ishi-kai/Chipathon2023_ADC/README.md

# ADC of [Chipathon2023](https://github.com/sscs-ose/DC23-LTC2)'s Japan Team

## Submission files
Click [here](https://github.com/ishi-kai/Chipathon2023_ADC/edit/main/submit_version) plz!

## Specification
- Base Spec
    - 6bit SAR-ADC
- Clock(Resolution)
    - 8MHz
- Process
    - Global Fundories 180nm
- Size
    - x00um x x00um
- Work Voltage (VDD)
    - 3.3V

## Members
- [Maple0705](https://github.com/maple0705)
    - Skills
        - Semiconductor Engineer
    - XP
        - Analog Circuit Design
- [Gitefu](https://github.com/Gitefu)
    - Skills
        - FPGA(Digital) Cource's Graduate Student
    - XP
        - Twice Analog Circuit Design
- [Kinako](https://github.com/kinako71)
    - Skills
        - FPGA(Digital) Cource's Graduate Student
    - XP
        - First Time Analog Circuit Design
- [Tseng](https://github.com/tsengs0)
    - Skills
        - Electronic Circuit Designer
    - XP
        - First Time Analog Circuit Design
- [Noritsuna Imamura](https://github.com/noritsuna)
    - Skills
        - RF Circuit Engineer (PCB CAD)
    - XP
        - Third Times Analog Circuit Design

### Supporters
- Takeshi Kuboki
- [Mizuki Mori](https://github.com/3zki/)
- [Akira Tsuchiya](https://github.com/atuchiya/)

# Parts
## [All Parts Merge as SAR-ADC](https://github.com/ishi-kai/Chipathon2023_ADC/tree/main/maple0705/SAR_ADC)
- Designer
    - [Maple0705](https://github.com/maple0705)

## [SAR-Logic](https://github.com/ishi-kai/Chipathon2023_ADC/tree/main/maple0705/SAR_Logic)
- Designer
    - [Maple0705](https://github.com/maple0705)

## [Comparator](https://github.com/ishi-kai/Chipathon2023_ADC/tree/main/gitefu/comp_20240331)
- Designer
    - [Gitefu](https://github.com/Gitefu)

## [CDAC](https://github.com/ishi-kai/Chipathon2023_ADC/tree/main/cdac/mim_cap_array_8x8)
- Designer
    - [Tseng](https://github.com/tsengs0)

## [Latch](https://github.com/ishi-kai/Chipathon2023_ADC/tree/main/latch)
- Designer
    - [Kinako](https://github.com/kinako71)

## [Switch](https://github.com/ishi-kai/Chipathon2023_ADC/tree/main/transmission-gate)
- Designer
    - [Kinako](https://github.com/kinako71)

## [LDO](https://github.com/ishi-kai/Chipathon2023_ADC/tree/main/noritsuna/ldo)
- Designer
    - [Noritsuna Imamura](https://github.com/noritsuna)

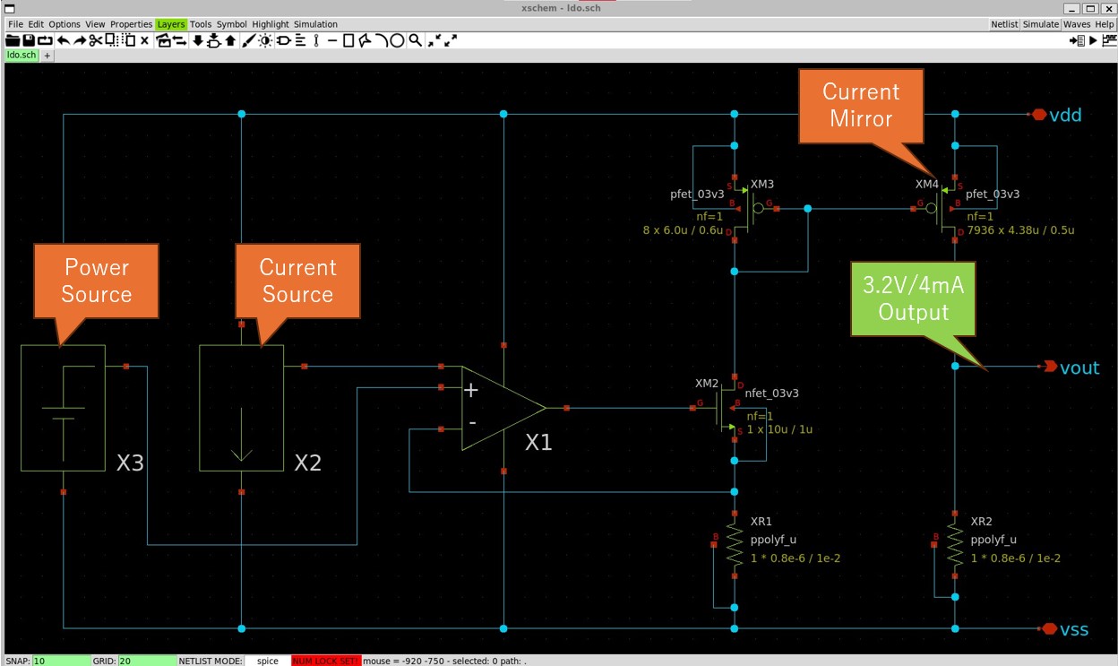
[picture p1: noritsuna/ldo/images/curcuit_ldo.jpg]
Curcuit
-   
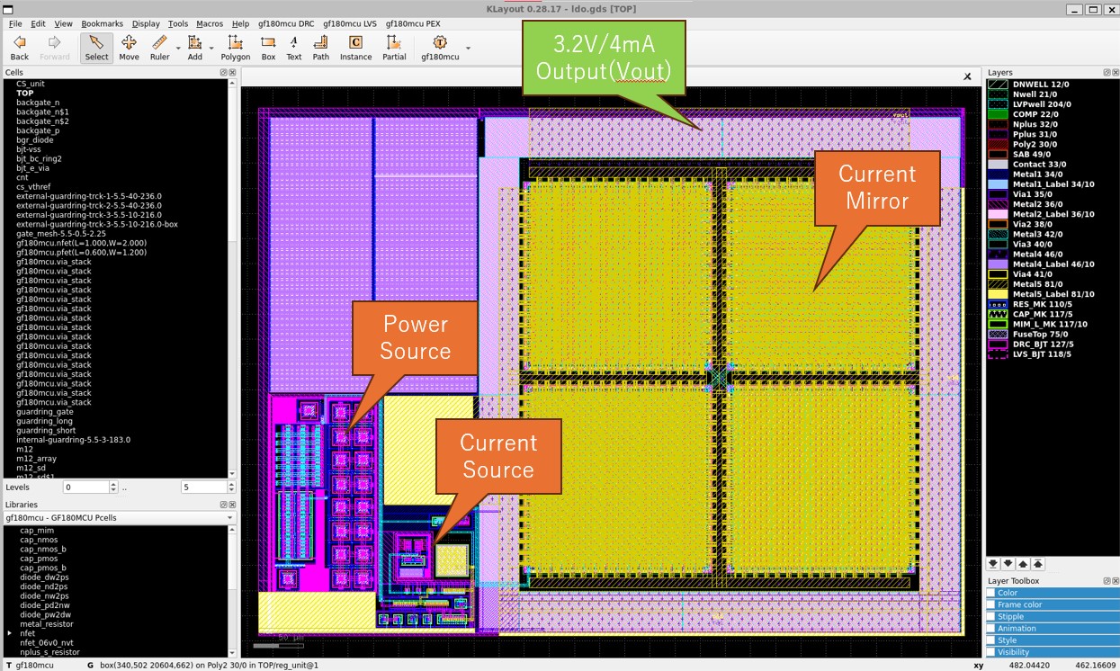
[picture p2: noritsuna/ldo/images/layout_ldo.jpg]
Layout
-   

### Specification
    - Size
        - 700um x 550um
    - In Voltage (VDD)
        - 3.3V
    - Out Voltage (Vout)
        - 3.2V
    - Out Ampere (Vout)
        - 4mA

# WSL Image
We provide a WSL image with an environment set up to run the circuit diagrams, simulations, layouts, DRC, and LVS mentioned above.  

- [Image for circuit diagrams, simulations, layouts, and LVS](https://www.noritsuna.jp/download/ubuntu2204_chipathon2023_gf180.tar.xz)
    - ID: ishi-kai
    - Pass: ishi-kai

## Installing WSL Images
`wsl --import-in-place ubuntu2204_chipathon2023_gf180 .\ubuntu2204_chipathon2023_gf180\ext4.vhdx`

The above command will be recognised. To execute it, please use the included "ubuntu2204_chipathon2023_gf180.lnk".  

## Deleting WSL Images
Please note that image files will also be deleted.  

`wsl --unregister ubuntu2204_chipathon2023_gf180`

# License
