ishi-kai/Chipathon2023_ADC/submit_version/readme.md

# Submission files
- [GDSII for tapeout](https://github.com/ishi-kai/Chipathon2023_ADC/blob/main/submit_version/klayout/SAR_TOP.gds)
- [Schematic file for LVS](https://github.com/ishi-kai/Chipathon2023_ADC/blob/main/submit_version/xschem/sar_adc_lvs.sch)

  - Layout and the contributor of each subblock/subsystem
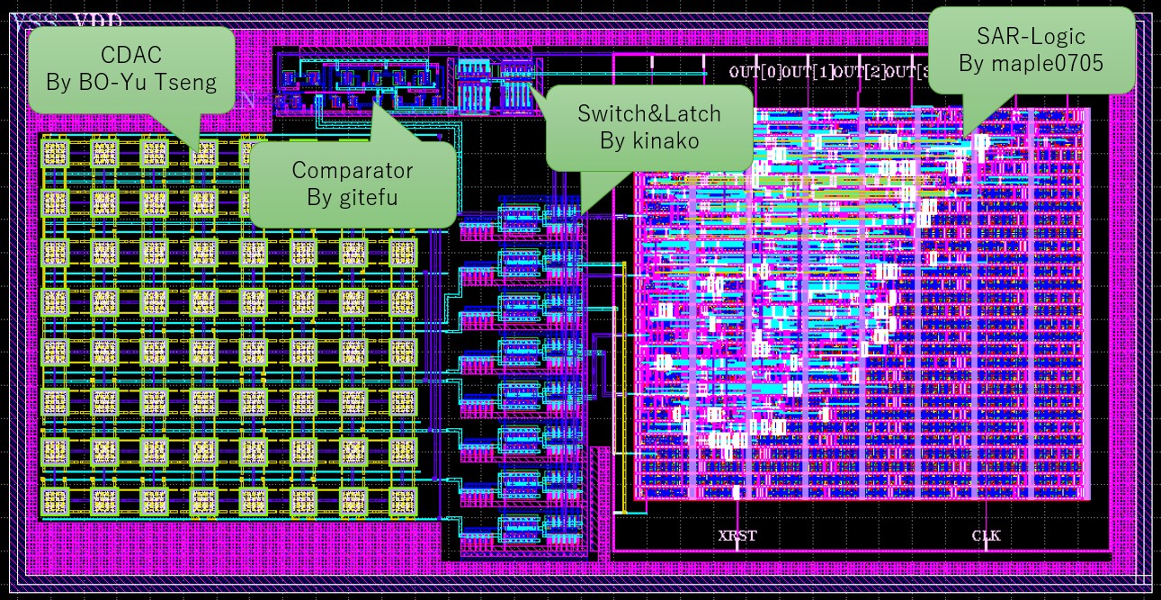
[picture p3: submit_version/images/layout.jpg]
Parts Layout
  

  - Block Diagrams
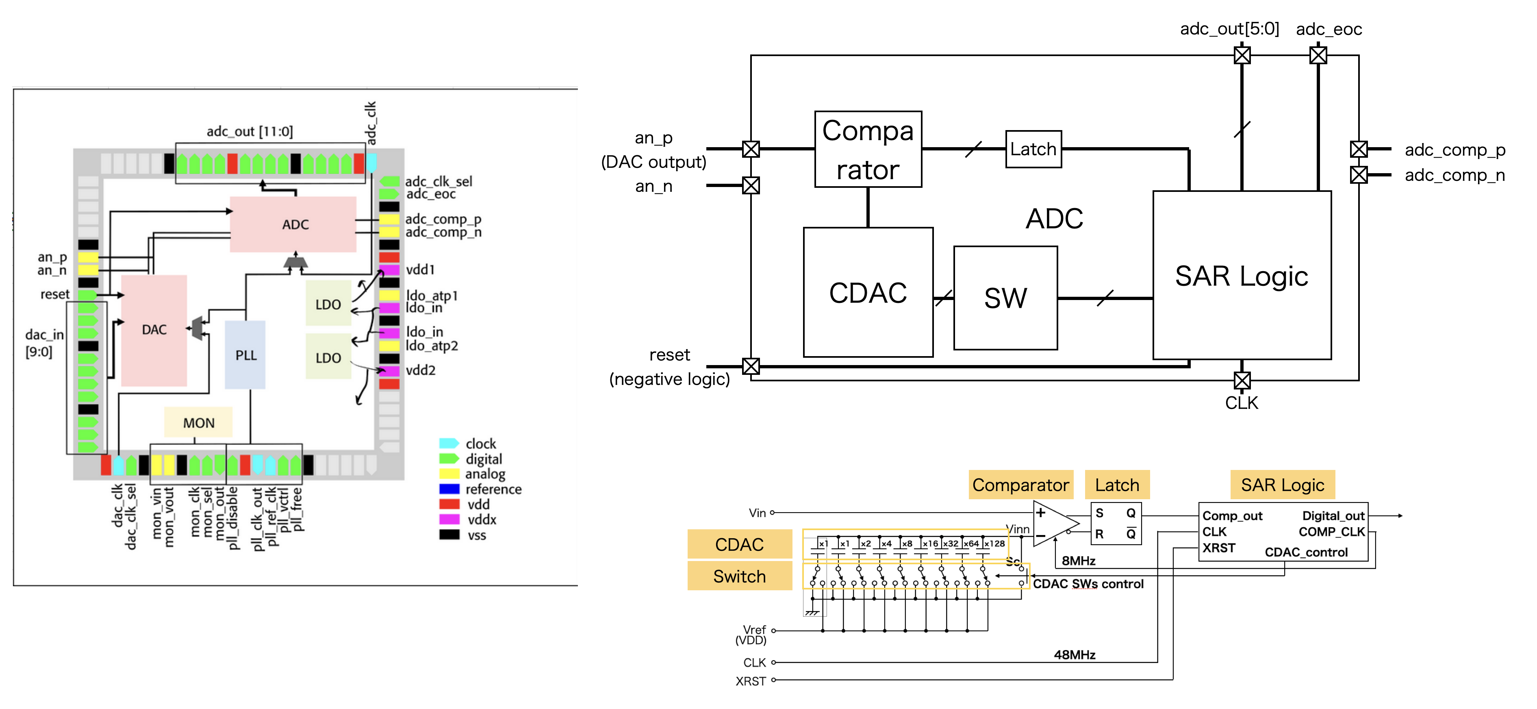
[picture p4: submit_version/images/PnR.png]
Block Figs
  

  - Interface and Area
  Pins Layout  

---

# Descriptoin of each design file
| File | Purpose/Function | Remark |
| --- | --- | --- |
|SW_CDAC.sch|switch component for each CDAC bit which is based on the https://github.com/ishi-kai/Chipathon2023_ADC/blob/main/transmission-gate/sw.sch|The only difference from the base sw.sch is the NMOS connected to the Vout port|
|SW_CDAC.sym|symbol file made from the Sw_CDAC.sch||
|user_proj_sarlogic.sym|symbol file used for the simulation of [user_proj_sarlogic_pex_extracted.spice](https://github.com/ishi-kai/Chipathon2023_ADC/blob/main/maple0705/SAR_Logic/klayout/user_proj_sarlogic_pex_extracted.spice)||
|user_proj_sarlogic.sch|blackbox module for making the symbol file of user_proj_sarlogic||
|tran_sar_logic.sch|schematic file for the unit-level verification of SAR logic||
|tran_sar_adc.sch|Testbench for the integration of the overall SAR A/D converter as shown in the figure below||

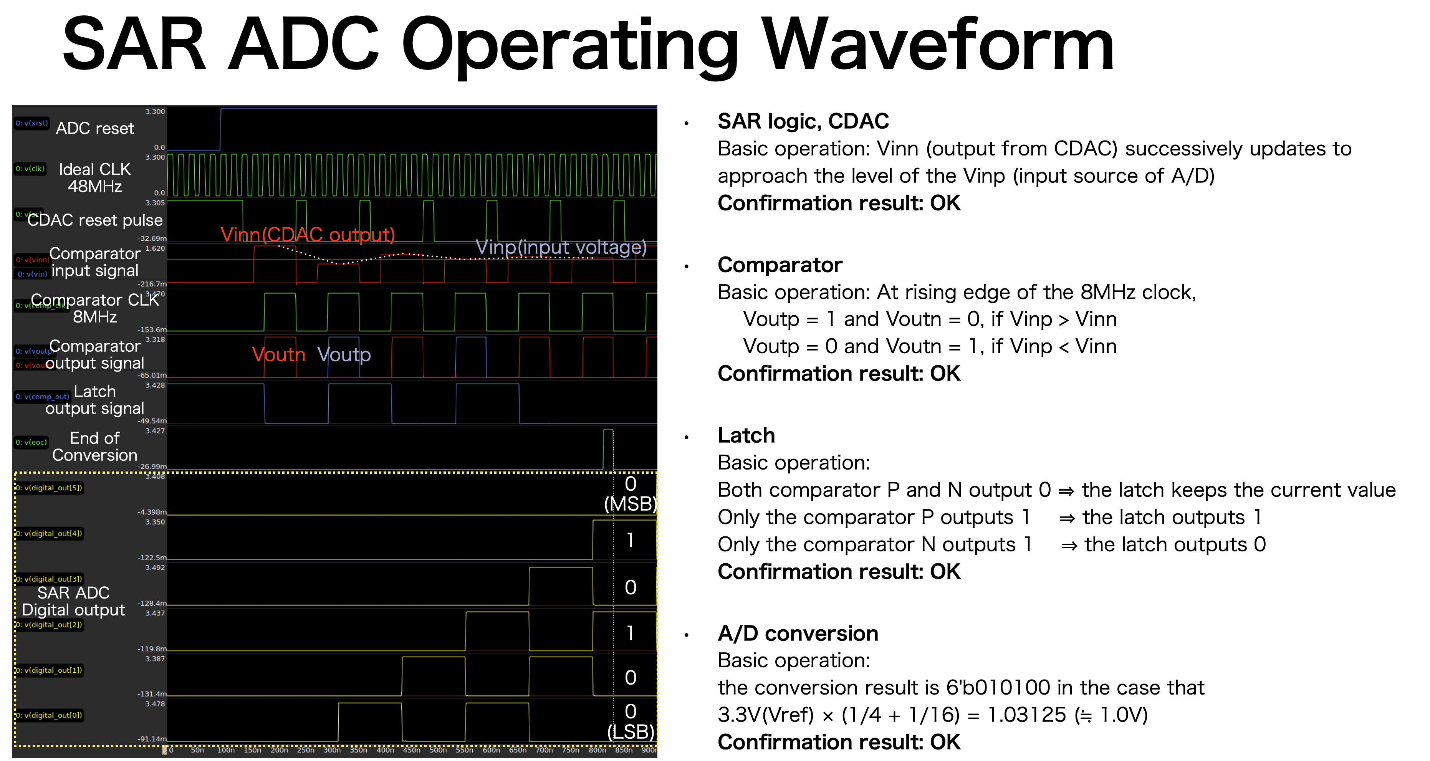
[picture p5: submit_version/images/sar_adc_operating_waveform.png]
SAR-ADC Spec
 

---

## Miscellaneous:  
  - Top-level schematic of the A/D converter integrating all subblocks 
    - https://github.com/ishi-kai/Chipathon2023_ADC/tree/main/maple0705/SAR_Logic/caravel/openlane
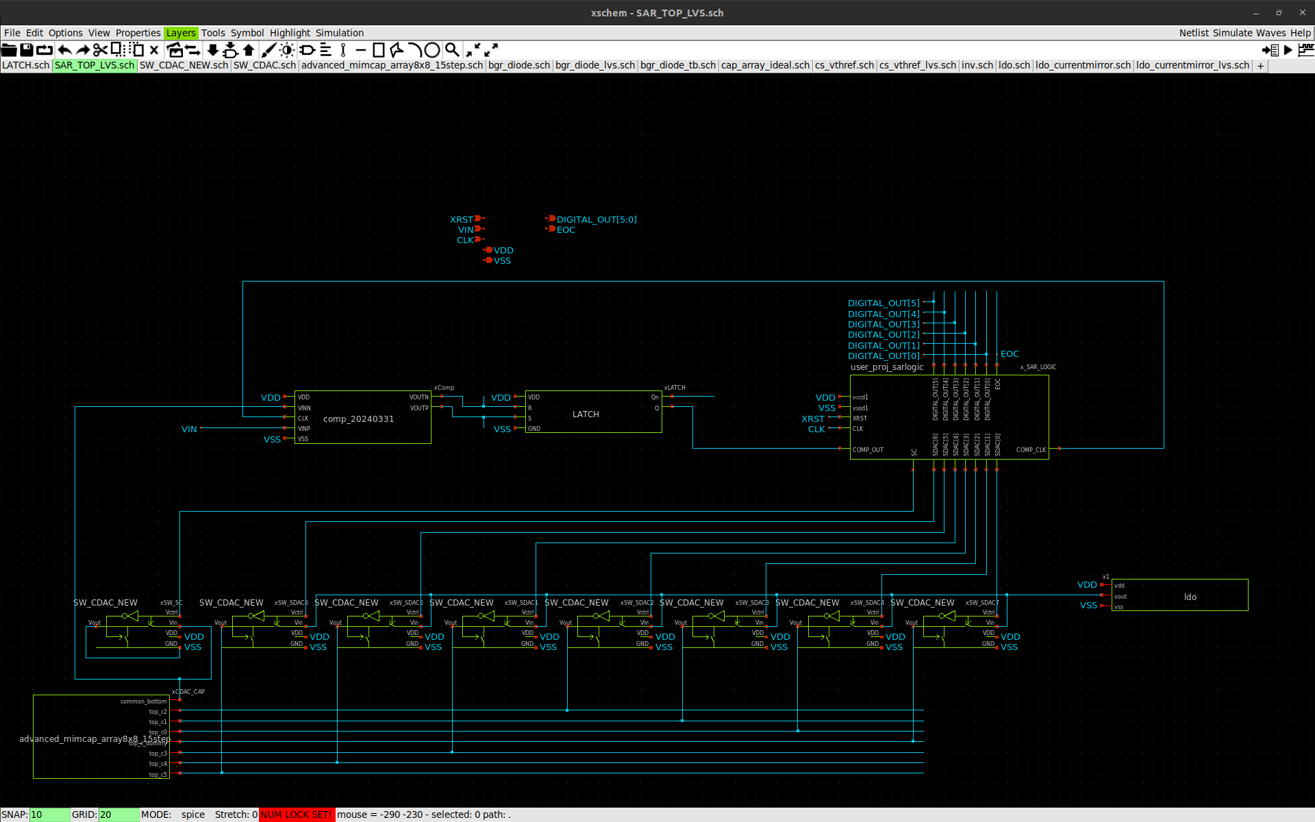
[picture p6: submit_version/images/SAR_TOP_LVS.png]
SAR_TOP_LVS
    -   
  - Design of the MIM capacitor array  
    - https://github.com/ishi-kai/Chipathon2023_ADC/tree/cdac_tseng/cdac/mim_cap_array_8x8
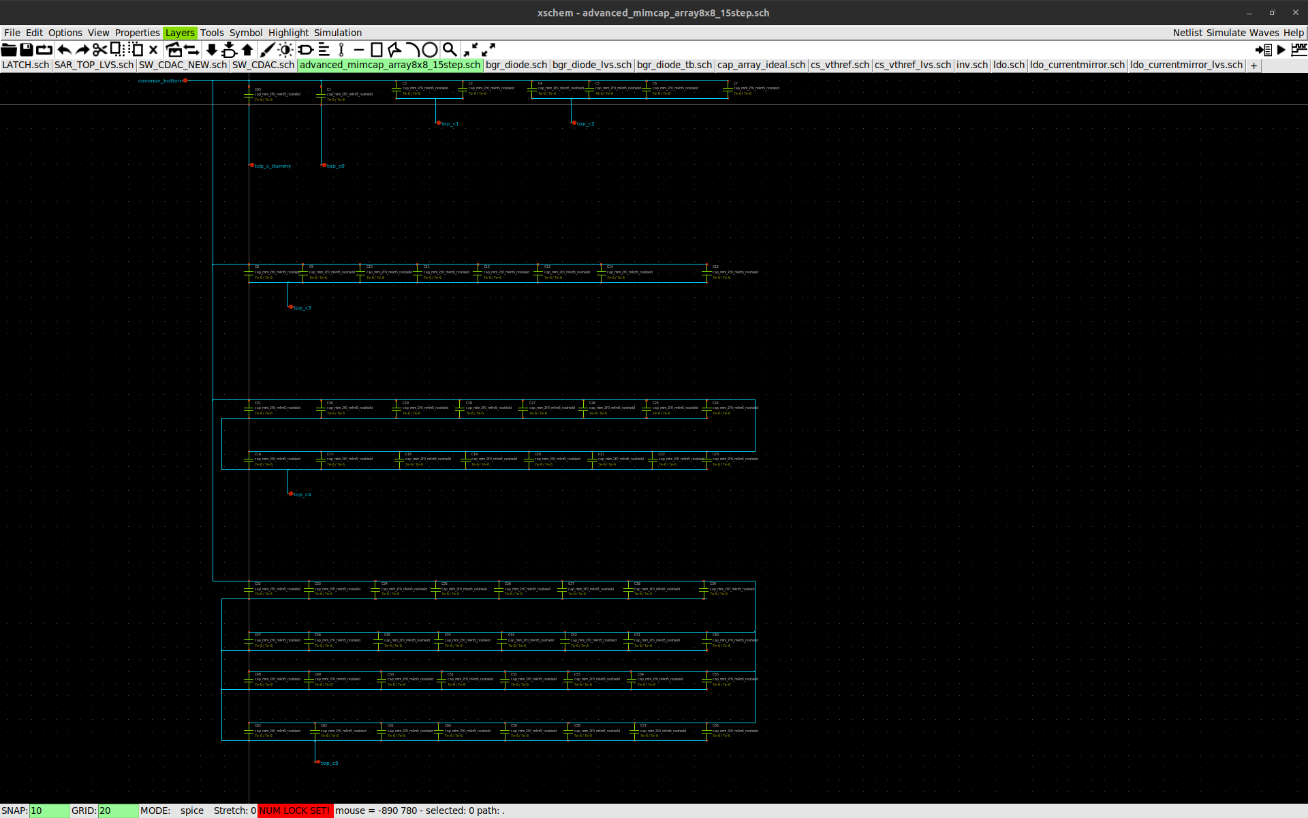
[picture p7: submit_version/images/advanced_mimcap_array8x8_15step.png]
CDAC
    -   
  - Design of the latch components
    - https://github.com/ishi-kai/Chipathon2023_ADC/tree/main/latch  
    - https://github.com/ishi-kai/Chipathon2023_ADC/tree/main/inverter
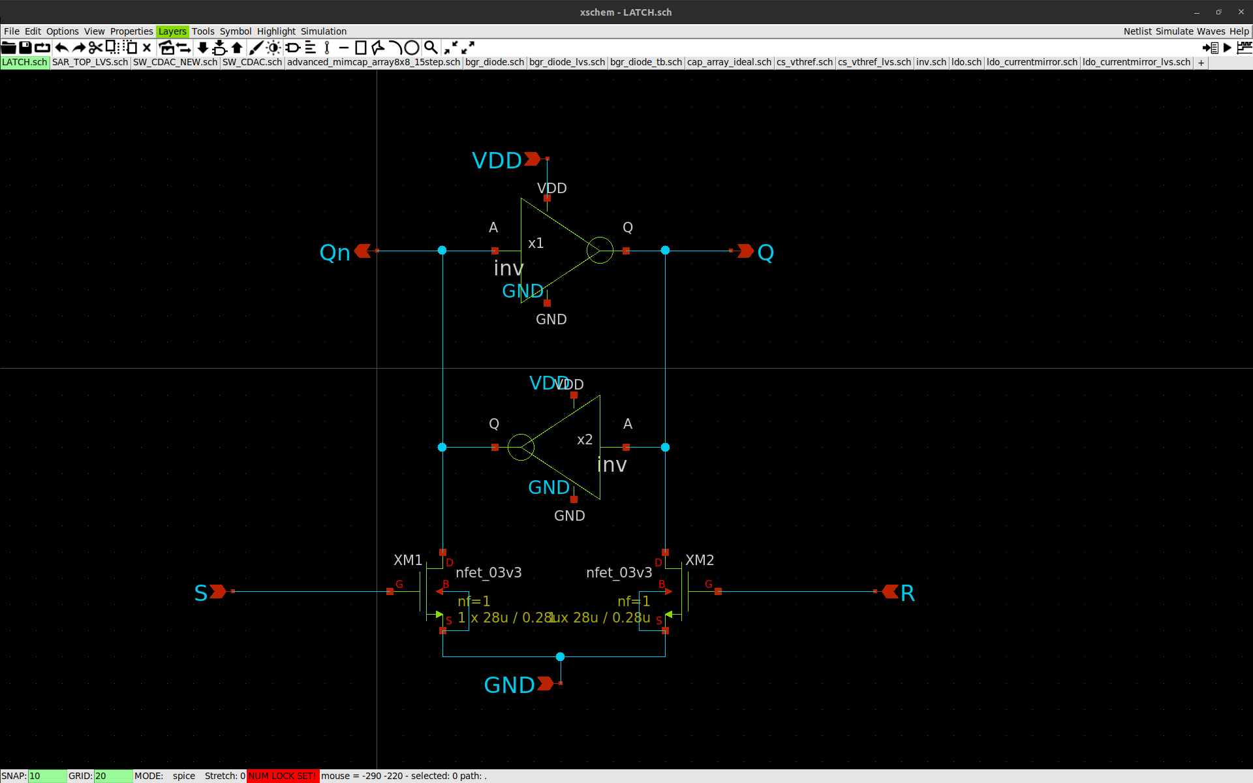
[picture p8: submit_version/images/LATCH.png]
LATCH
    -   
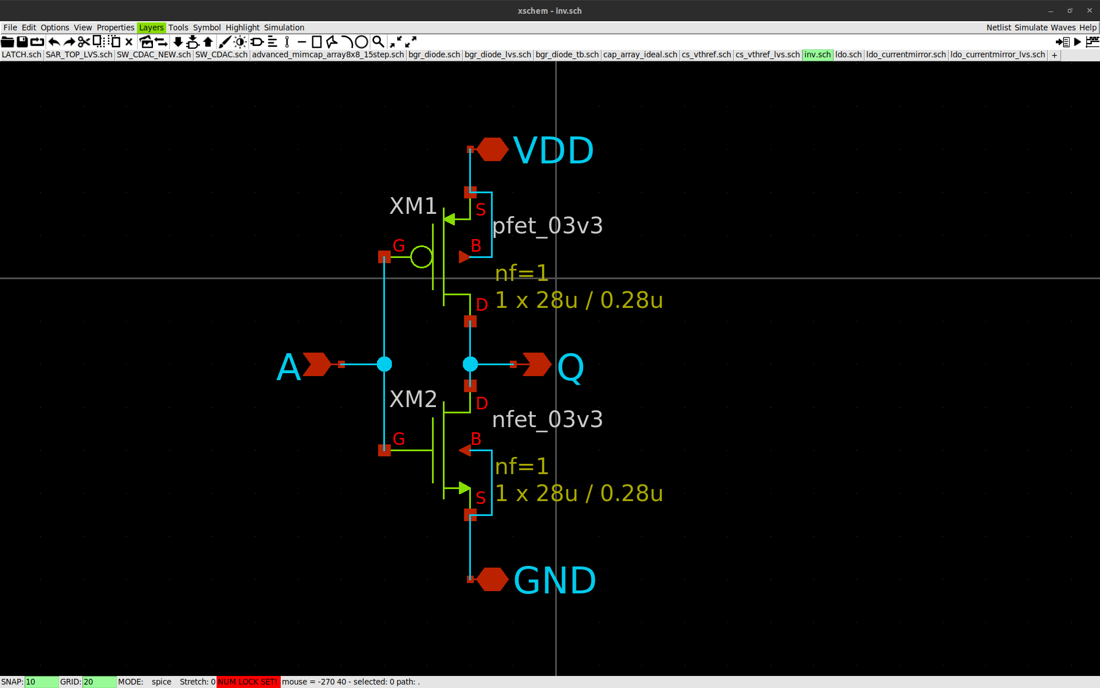
[picture p9: submit_version/images/Inv.png]
Inv
    -   
  - Design of the comparator
    - https://github.com/ishi-kai/Chipathon2023_ADC/tree/main/gitefu/comp_20240331
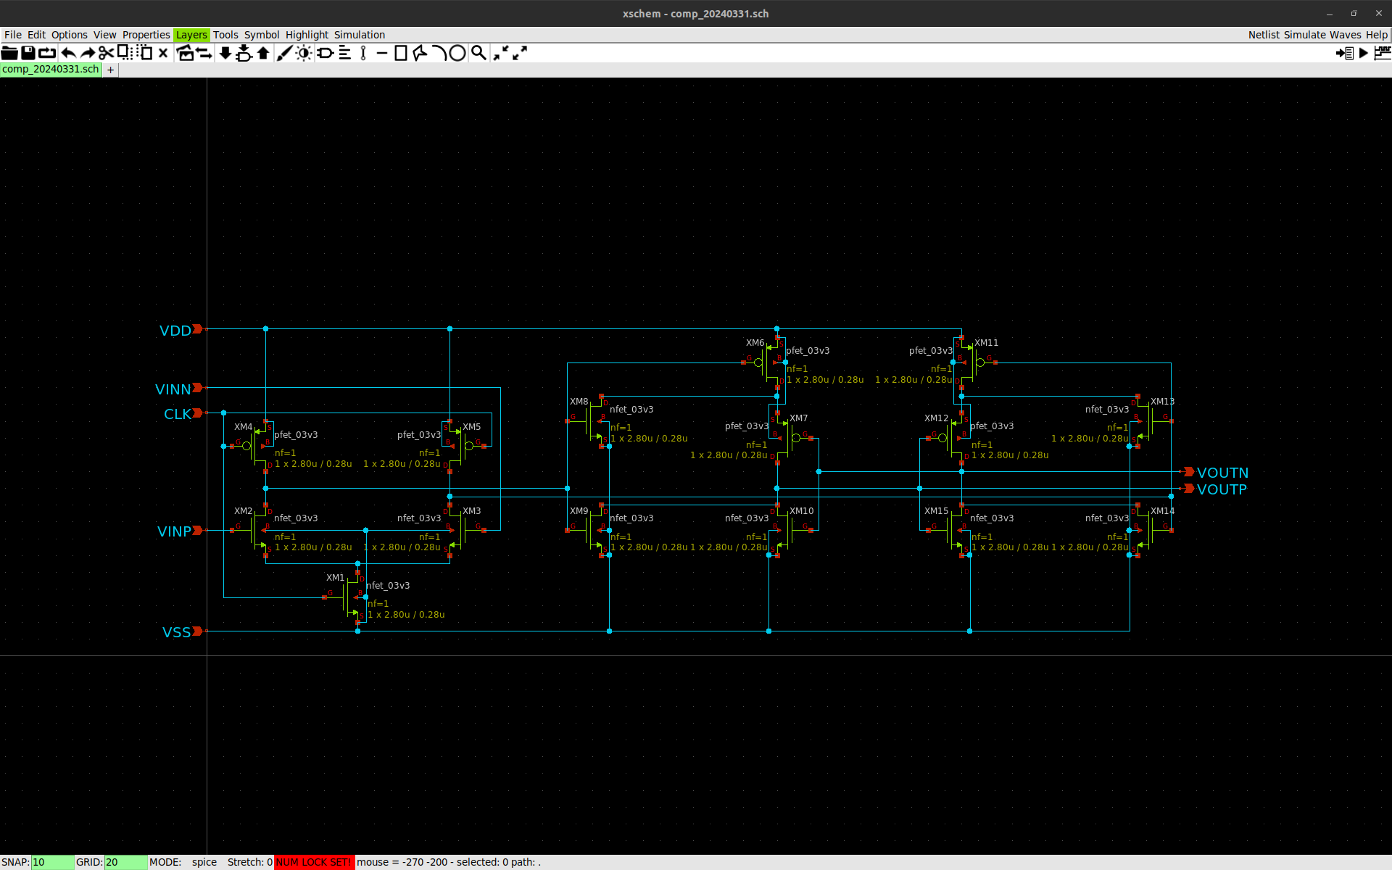
[picture p10: submit_version/images/comp_20240331.png]
Comparator
    -   
  - Unused/Tentative design material
      - LDO: https://github.com/ishi-kai/Chipathon2023_ADC/tree/main/noritsuna/ldo
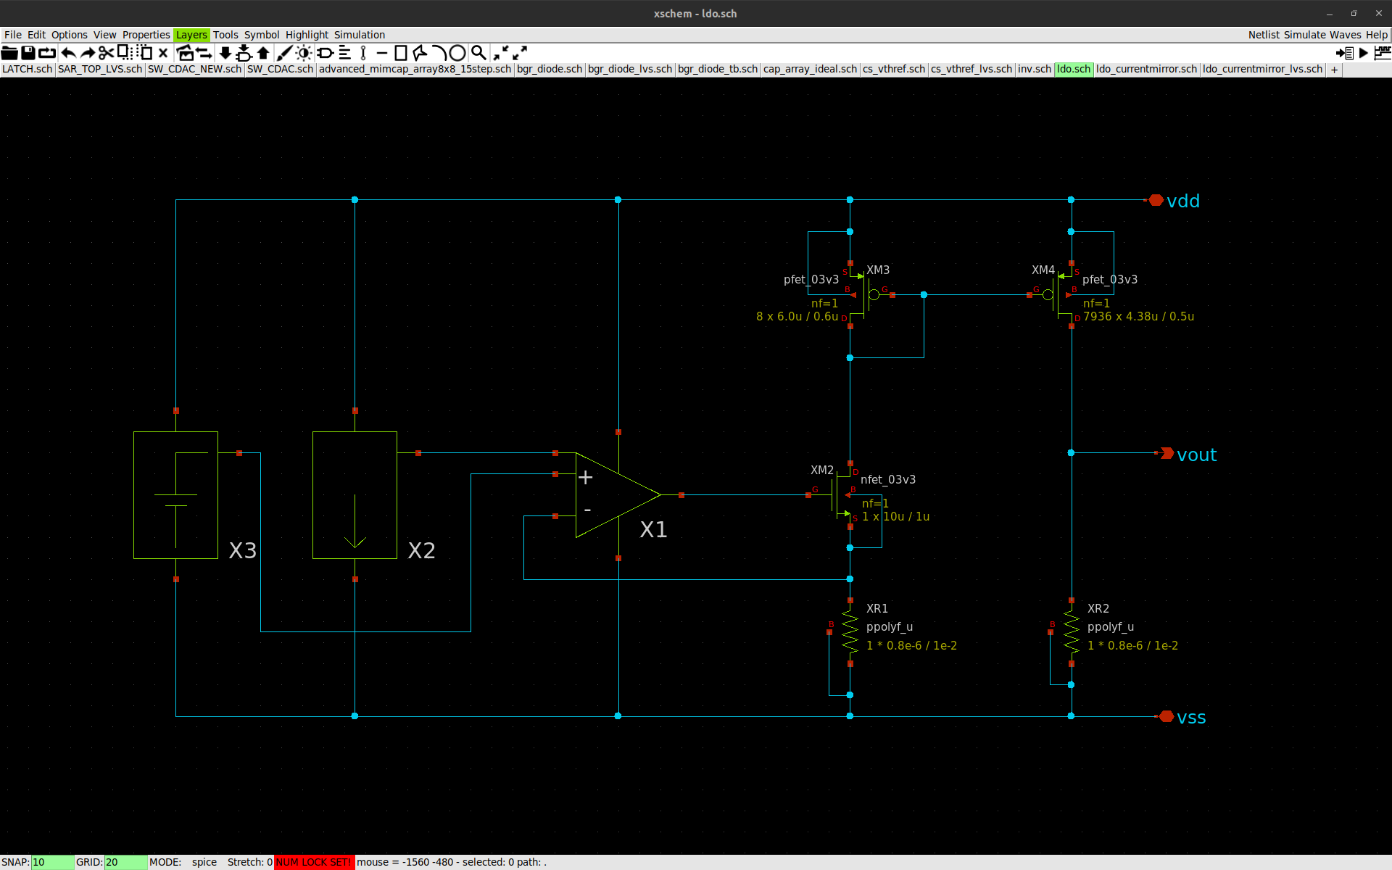
[picture p11: submit_version/images/ldo.png]
LDO
      -
