ishi-kai/Chipathon2023_ADC/maple0705/readme.md

- SAR ADC  
  SAR ADC 統合検証テストベンチ
- SAR Logic  
  SARロジック RTLや論理合成設定ファイル、合成後GDS
