ishi-kai/Chipathon2023_ADC/review/0407/noritsuna_sampleADC_Analyze.pptx

## 他のADCサンプル解析

Noritsuna Imamura
noritsuna@ishi-kai.org

## サンプル：MPW7より 差動入力10bit SAR-DAC https://github.com/christoph-weiser/mpw7

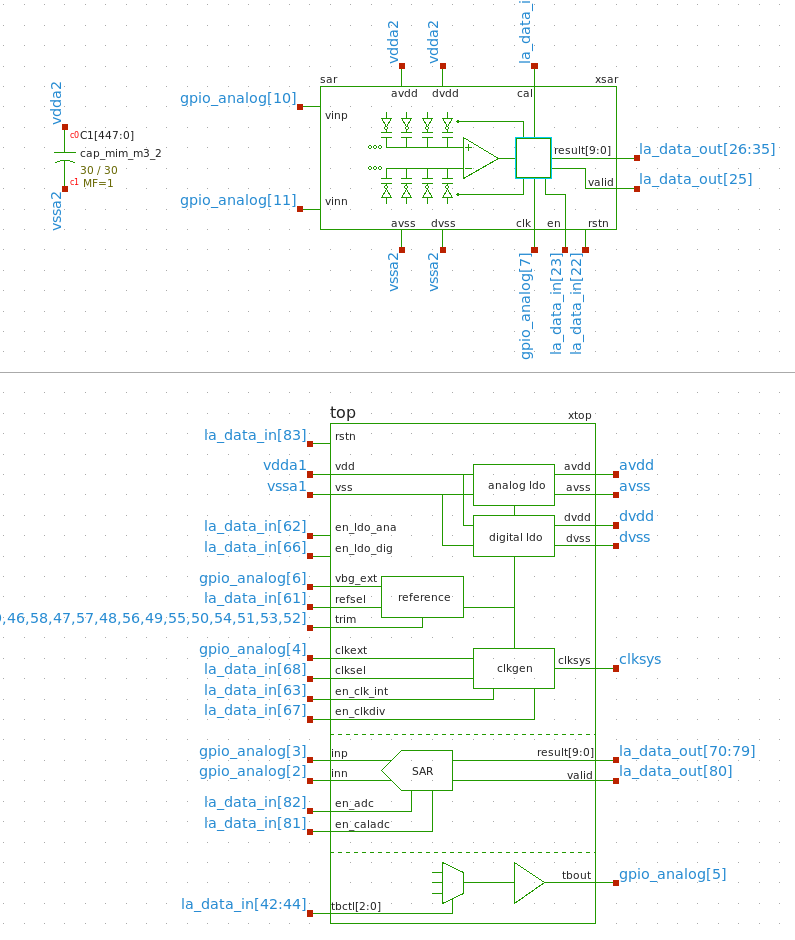
[picture p16: figure]

## 全体 レイアウトの サンプル

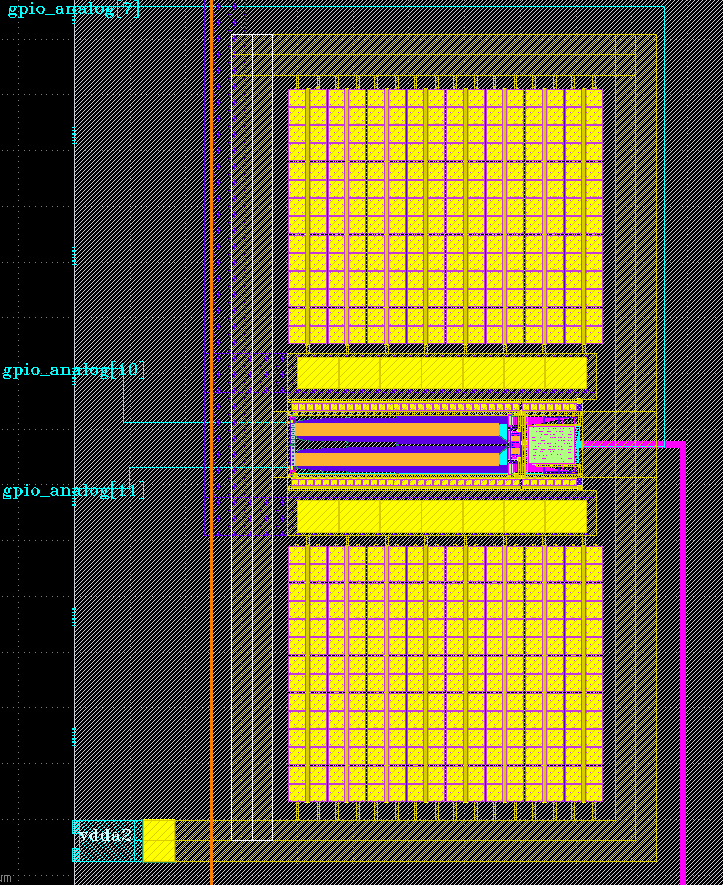
[picture p17: figure]

## 黄色の謎

MIMコンデンサのようだが、ここに電荷を貯めて、高速に電荷をCDAC部分に送れるようにしている？

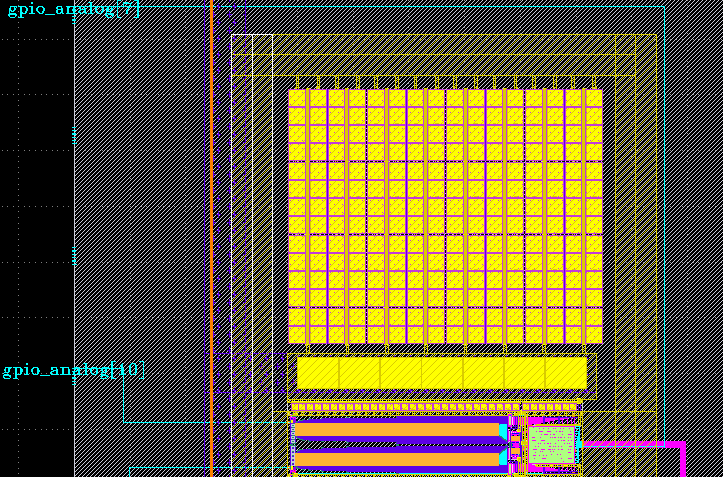
[picture p18: figure]

## CDACの前に何か回路がある

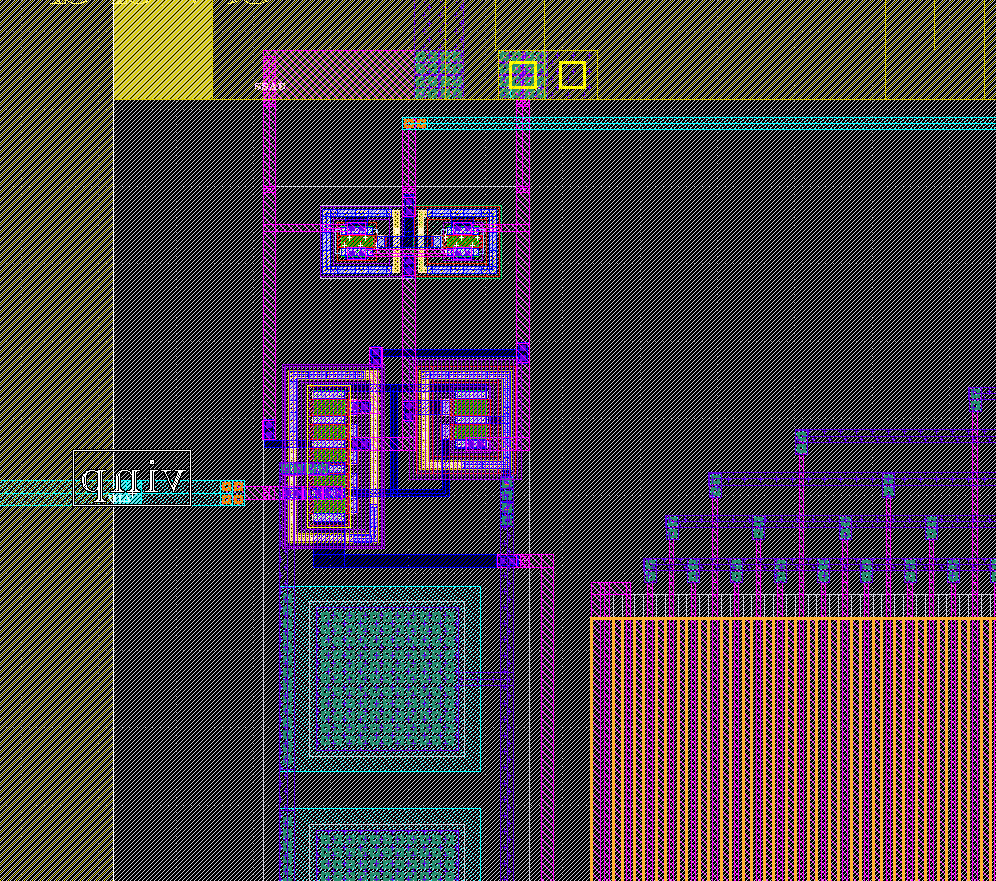
[picture p19: figure]

## 回路的にはBIAS用のAMP？

これは必要か？

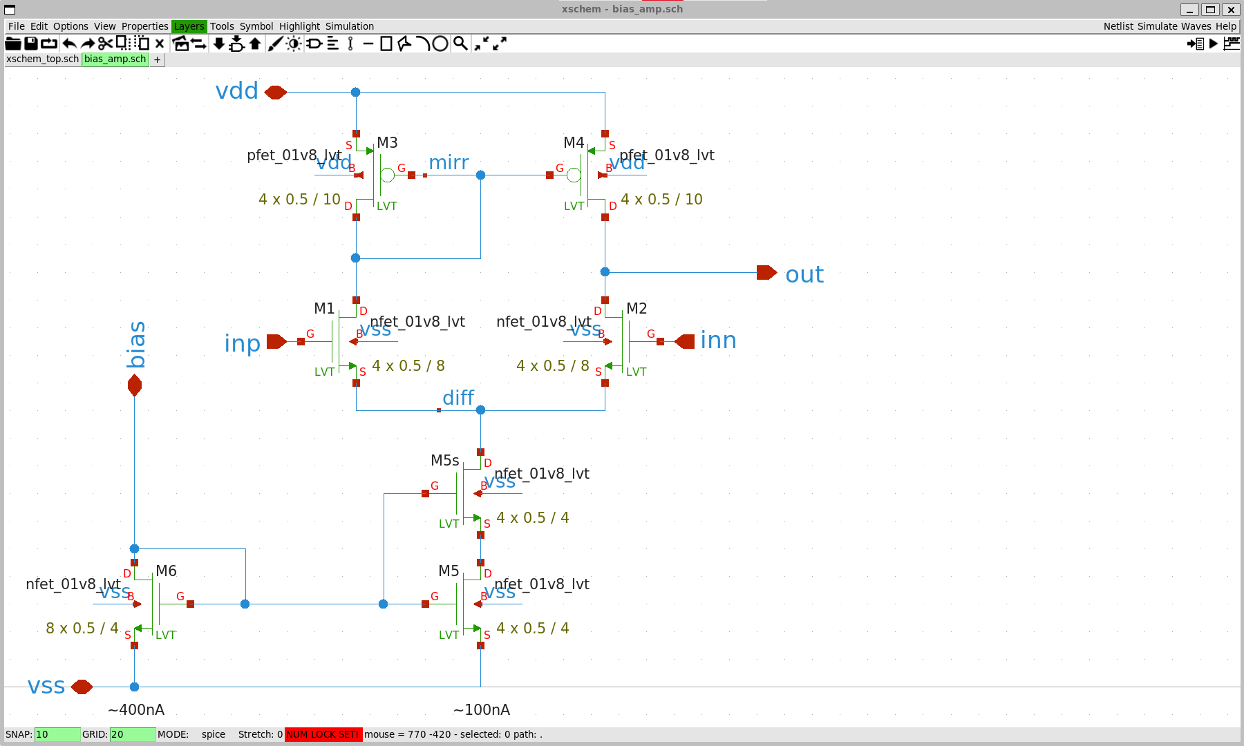
[picture p20: figure]

## コンパレータ

CDACスイッチ

ロジック

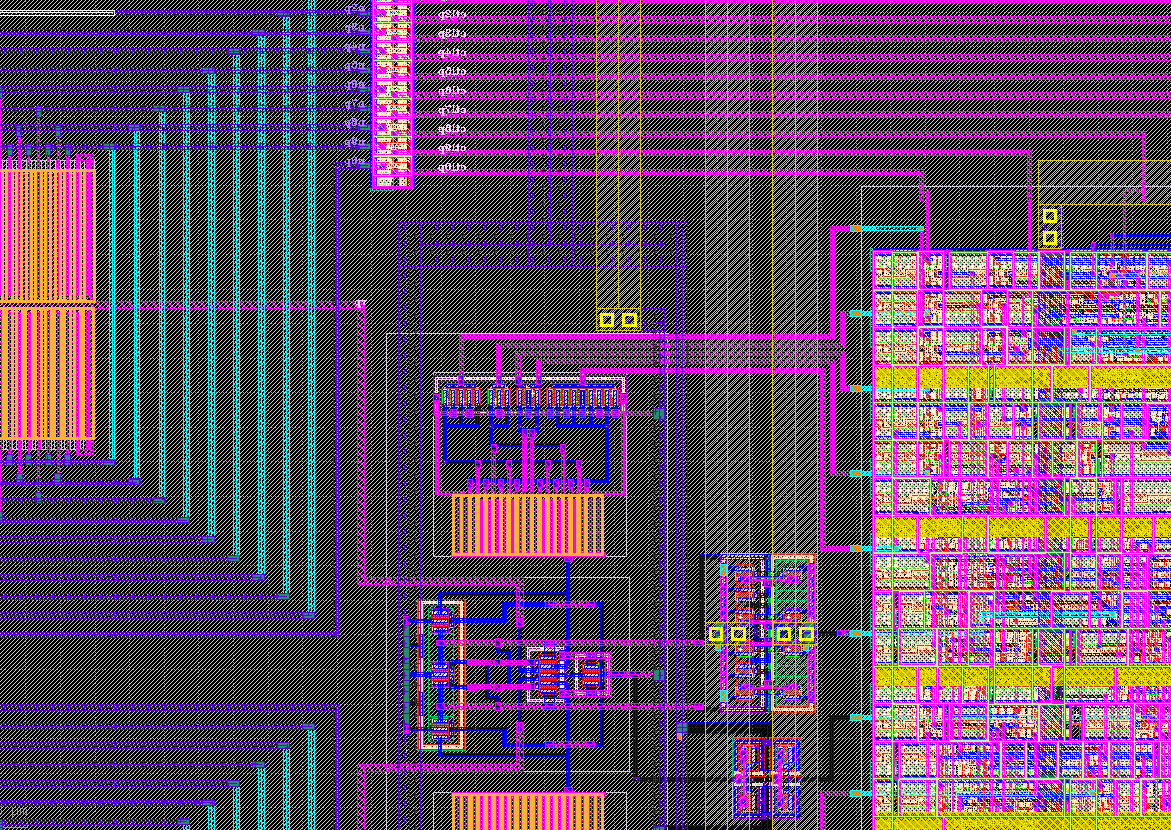
[picture p21: figure]

trim

コンパレータ

ラッチアップ

クロック
（バッファー）

## trim

何に使うの？

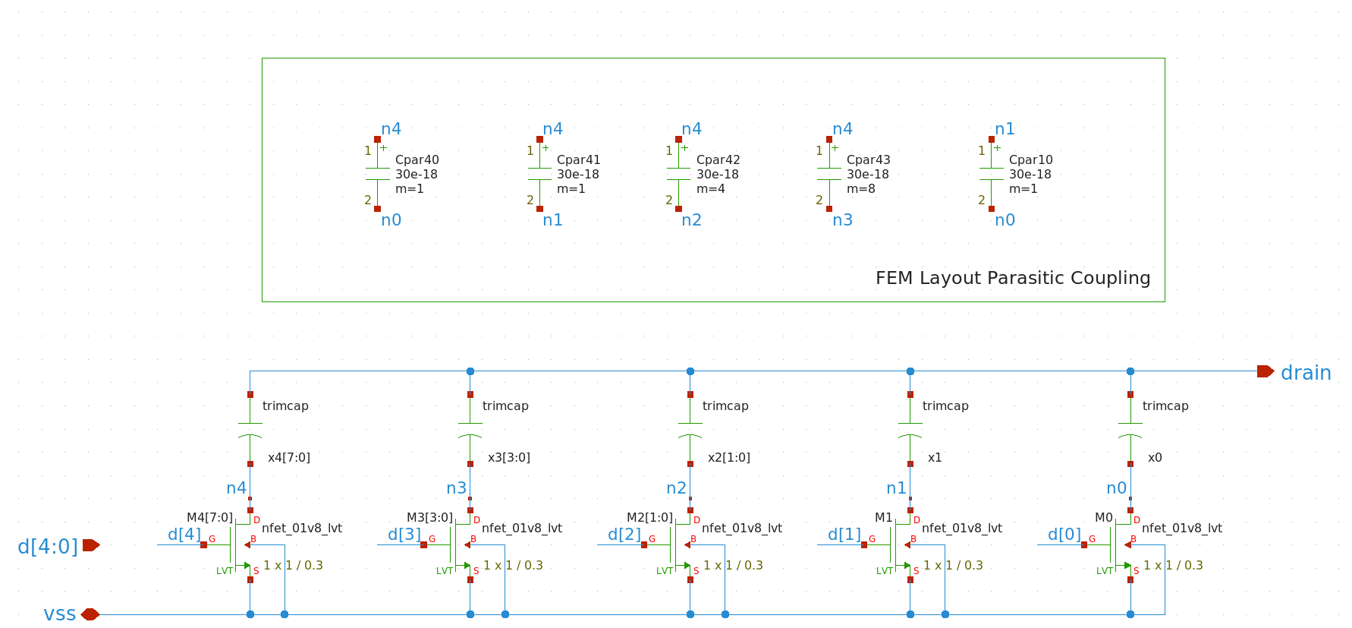
[picture p22: figure]

## ラッチアップ回路 と デジタル→アナログ駆動用スイッチ

こちらはスイッチも含めてきなこさんに作ってもらっている

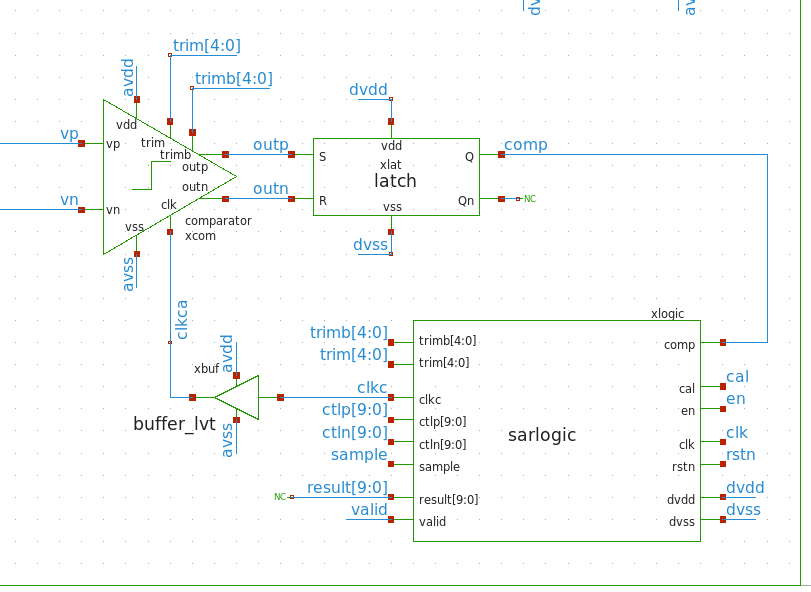
[picture p23: figure]

## クロック用 バッファー

SAR-Logicから供給される。
デジタル→アナログ駆動用？バッファーが必要な模様。
誰も作ってないはず・・・

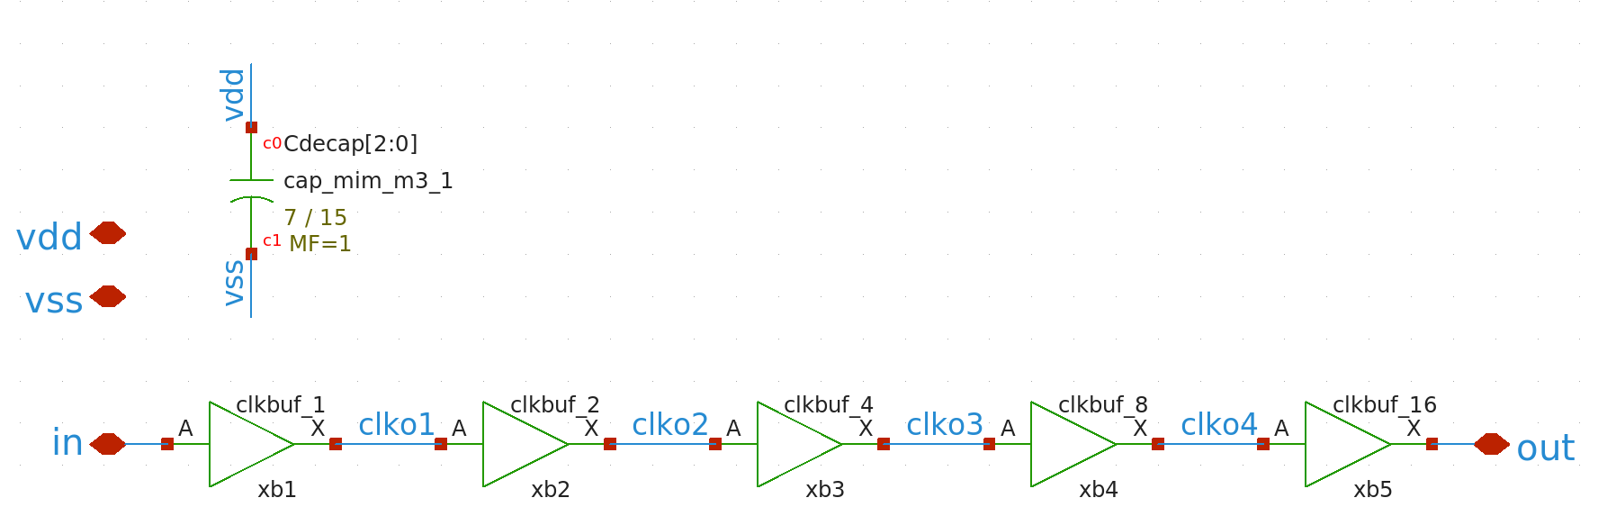
[picture p24: figure]

## LDOやリファレンス、クロックジェネレータ

- どこまで必要か？
- リファレンス電源は何種類いるのか？
  - ±3.3V, ± 1.8V, ± 0.6V

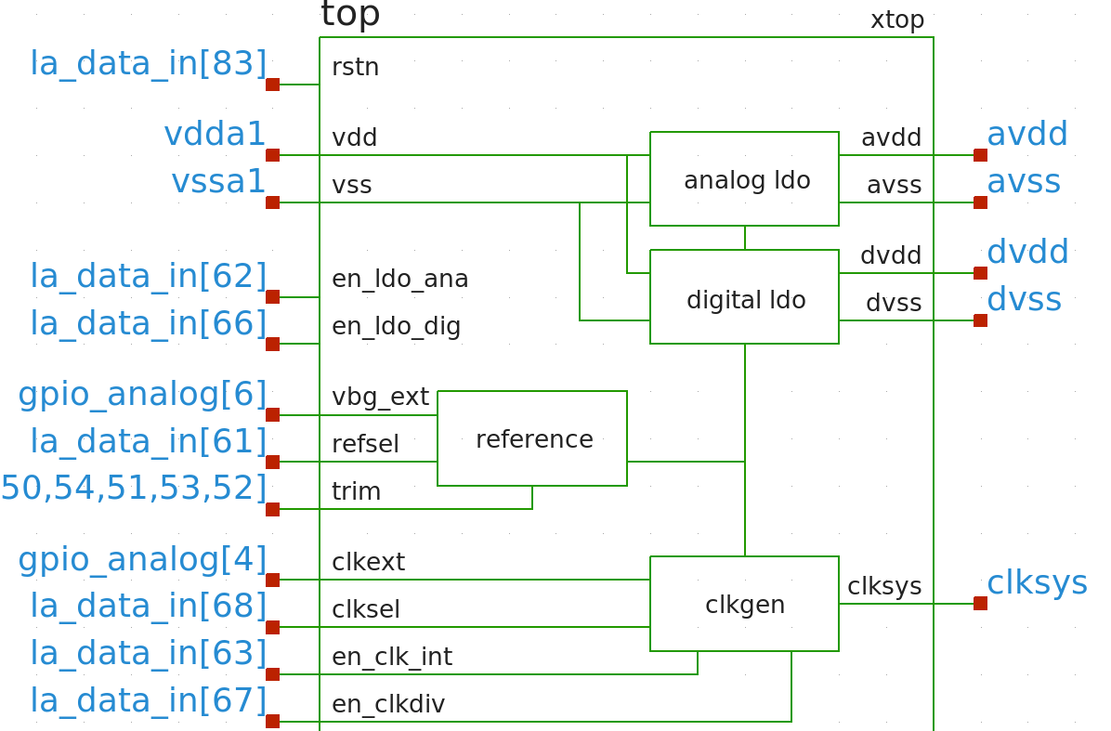
[picture p25: figure]
