ishi-kai/Chipathon2023_ADC/review/0407/SAR_Logic_review.pdf

## maple0705

# Chipathon 2023 SAR ADC

# レビュー 2024/4/7

# サマリ

- 進捗

## - SARロジックGDS完成(とりあえず動くものとして) - 皆さんの回路を統合して、抽出後の.spiceでA/Dとしての動作をtran sim.で確認

- 残件

## - 入力電圧 対 A/D結果、誤差 のシミュレーション 回路構成的に入力レンジに制限があるはず。それを確認したい

## - SAR ADC全体のレイアウト完成

## - シフトレジスタ作成

- 疑問

•

# 想定しているSAR ADC構成

### - 宮原先生資料の構成をベースとした。 ただし、一旦Sample&Holdは無しとした。必要な場合、前段の駆動力が気になる。 (A/D対象入力信号の仕様が知りたい。レンジ・周波数・・・)

### - PLLから48MHzクロックをもらい、SARロジックを動作させる。

### - 1bitあたりのA/D時間は125ns(1/8MHz)。 この時間内に、CDAC制御・コンパレータ反転・次のbitでのCDAC状態決定 が行われる。

### - A/D精度は6bit (実際は、回路は8bitで作り下位2bitを捨てるのでしたっけ?)

### - 各bit、入力信号VinとVDACが比較され、 Vin > VDAC 1 Vin < VDAC 0 が順次出力される。従ってA/D結果から電圧値を逆算する場合、 電圧値[V] = Vref × ((Q8)/2 + (Q7)/4 + ・・・+ (Q2)/128 + (Q1)/256) Qnは各ビットの0/1。 Vin=1.0Vならば、A/D結果は6ʼb010011 (=0.9796875V) が理想

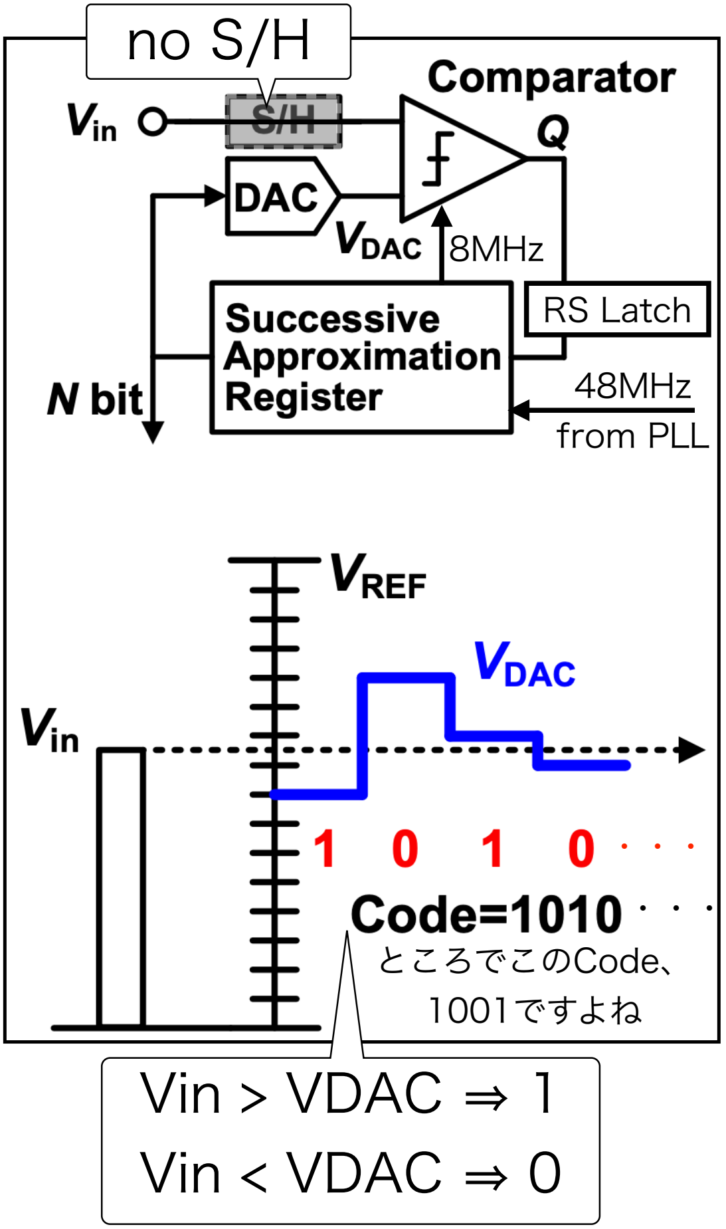
[picture p26: figure]
ところでこのCode、; 1001ですよね Vin > VDAC  1; Vin < VDAC  0; RS Latch; 8MHz; 48MHz; from PLL

https://openit.kek.jp/training/2020/daq/text/analog-digital-miyahara-200729-v1.pdf p.52

# 想定しているSAR ADC構成 詳細

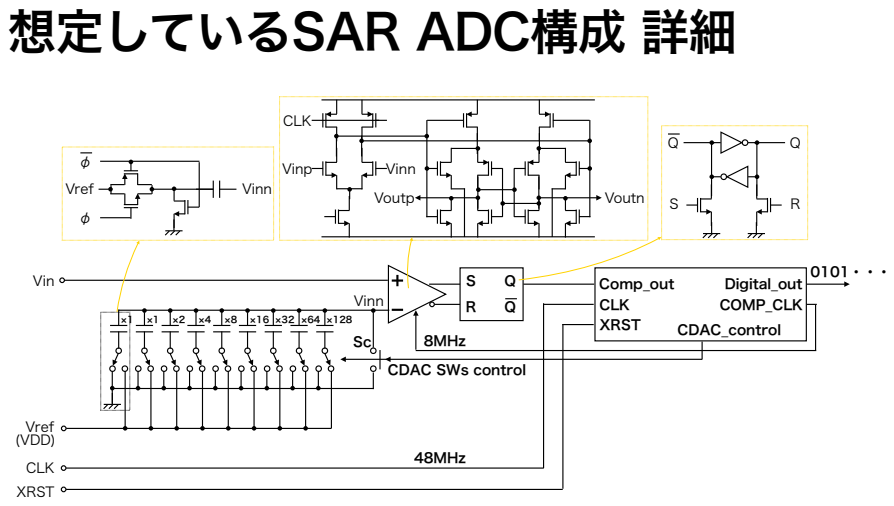
[picture p27: page 4]
Vinn; Vref; Vin; (VDD); Comp_out; CLK; XRST; CDAC_control; Digital_out COMP_CLK; 8MHz; Vinp; Voutp; Voutn; 48MHz

CDAC SWs control

# SAR Logic 動作

Sc

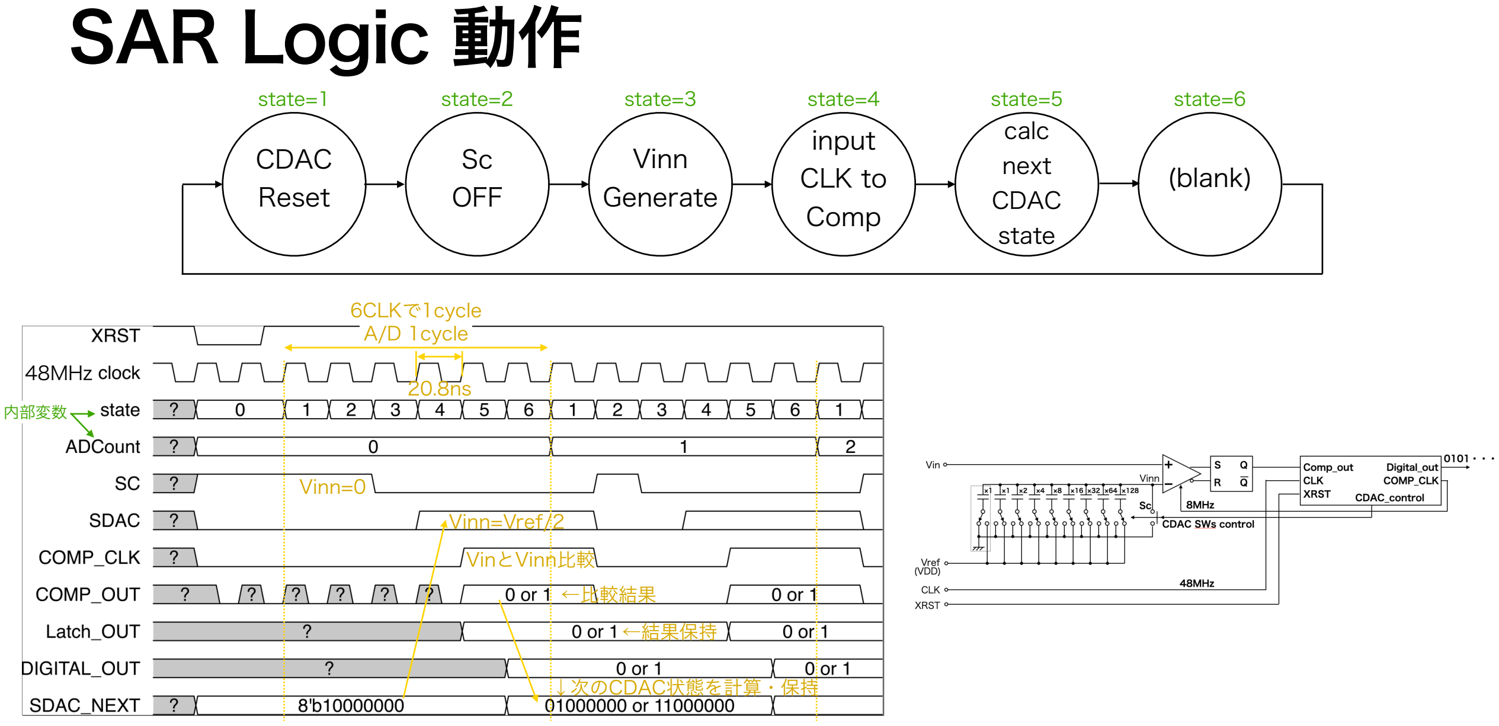
[picture p28: page 5]

## CDAC Reset

## OFF

## Vinn Generate

## input CLK to Comp

### calc next CDAC state

48MHz | 20.8ns A/D 1cycle

6CLKで1cycle

state=1 | state=2 | state=3 | state=4 | state=5

## (blank)

state=6

Vinn=0

Vinn=Vref/2

VinとVinn比較

内部変数

←比較結果

←結果保持

↓次のCDAC状態を計算・保持

# SARロジック GDS

# - Openlane 自動生成 ピン配置やサイズ等は相談したい

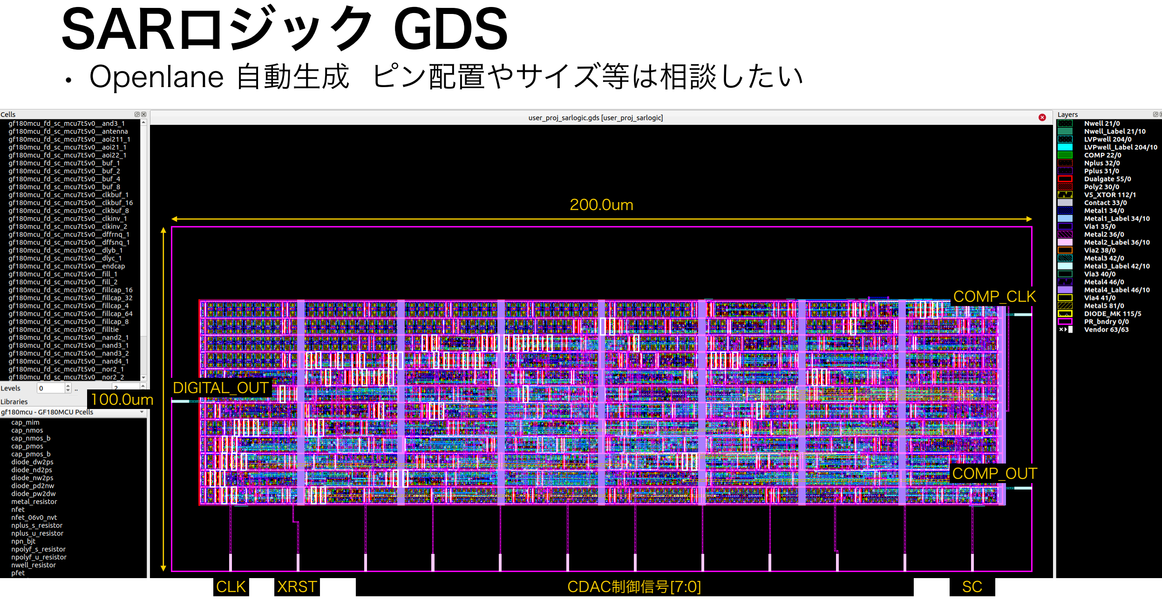
[picture p29: page 6]

200.0um

100.0um DIGITAL_OUT

COMP_CLK

COMP_OUT

CLK | XRST | CDAC制御信号[7:0] | SC

# テストベンチ

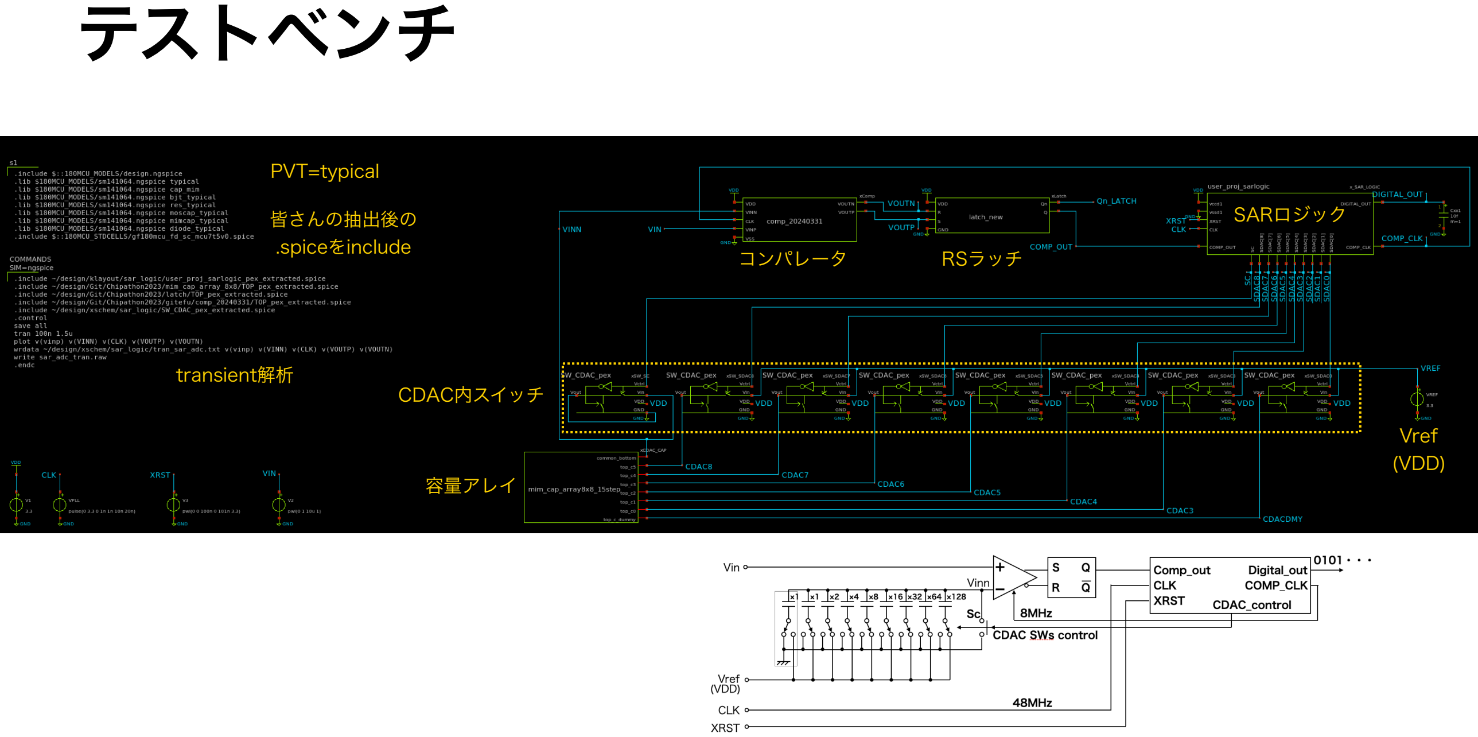
[picture p30: page 7]

コンパレータ | RSラッチ

SARロジック

CDAC内スイッチ

容量アレイ

Vref
(VDD)

PVT=typical

皆さんの抽出後の
.spiceをinclude

transient解析

# SAR ADC 基本動作確認 → OK

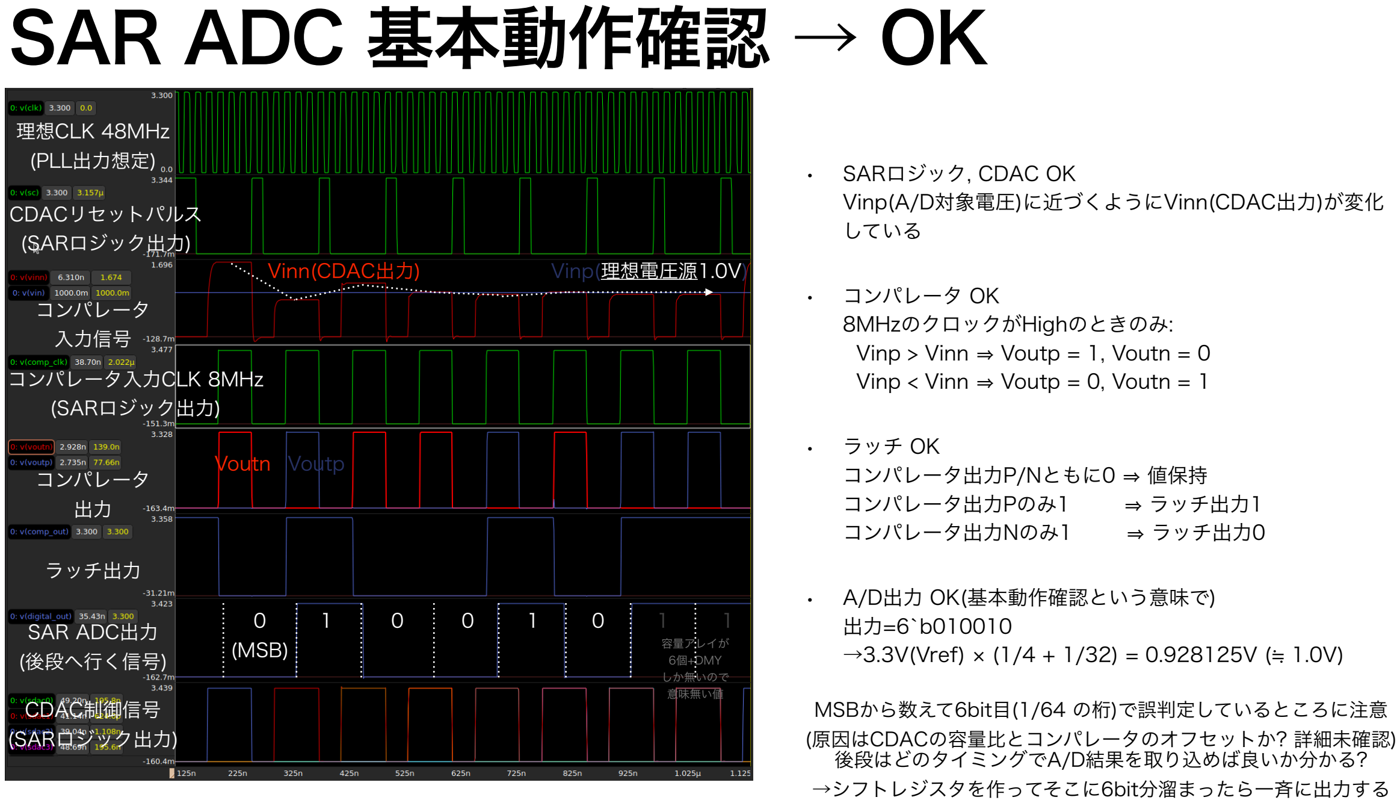
[picture p31: page 8]

- SARロジック, CDAC OK
Vinp(A/D対象電圧)に近づくようにVinn(CDAC出力)が変化 している
- コンパレータ OK
8MHzのクロックがHighのときのみ:
Vinp > Vinn Voutp = 1, Voutn = 0 Vinp < Vinn Voutp = 0, Voutn = 1
- ラッチ OK
コンパレータ出力P/Nともに0 値保持
コンパレータ出力Pのみ1 | ラッチ出力1
コンパレータ出力Nのみ1 | ラッチ出力0
- A/D出力 OK(基本動作確認という意味で)
出力=6`b010010
→3.3V(Vref) × (1/4 + 1/32) = 0.928125V ( 1.0V)

理想CLK 48MHz
(PLL出力想定)

CDACリセットパルス
(SARロジック出力)

コンパレータ
入力信号
Vinn(CDAC出力) | Vinp(理想電圧源1.0V)

コンパレータ入力CLK 8MHz
(SARロジック出力)

コンパレータ
出力

Voutn Voutp

ラッチ出力

SAR ADC出力
(後段へ行く信号)

CDAC制御信号
(SARロジック出力)

0
(MSB)
1 | 0 | 0 | 1 | 0 | 1 | 1

容量アレイが
6個+DMY
しか無いので
意味無い値
MSBから数えて6bit目(1/64 の桁)で誤判定しているところに注意 (原因はCDACの容量比とコンパレータのオフセットか? 詳細未確認) 後段はどのタイミングでA/D結果を取り込めば良いか分かる? →シフトレジスタを作ってそこに6bit分溜まったら一斉に出力する

# Appendix

# SAR ADC 基本動作確認 → ほぼOK

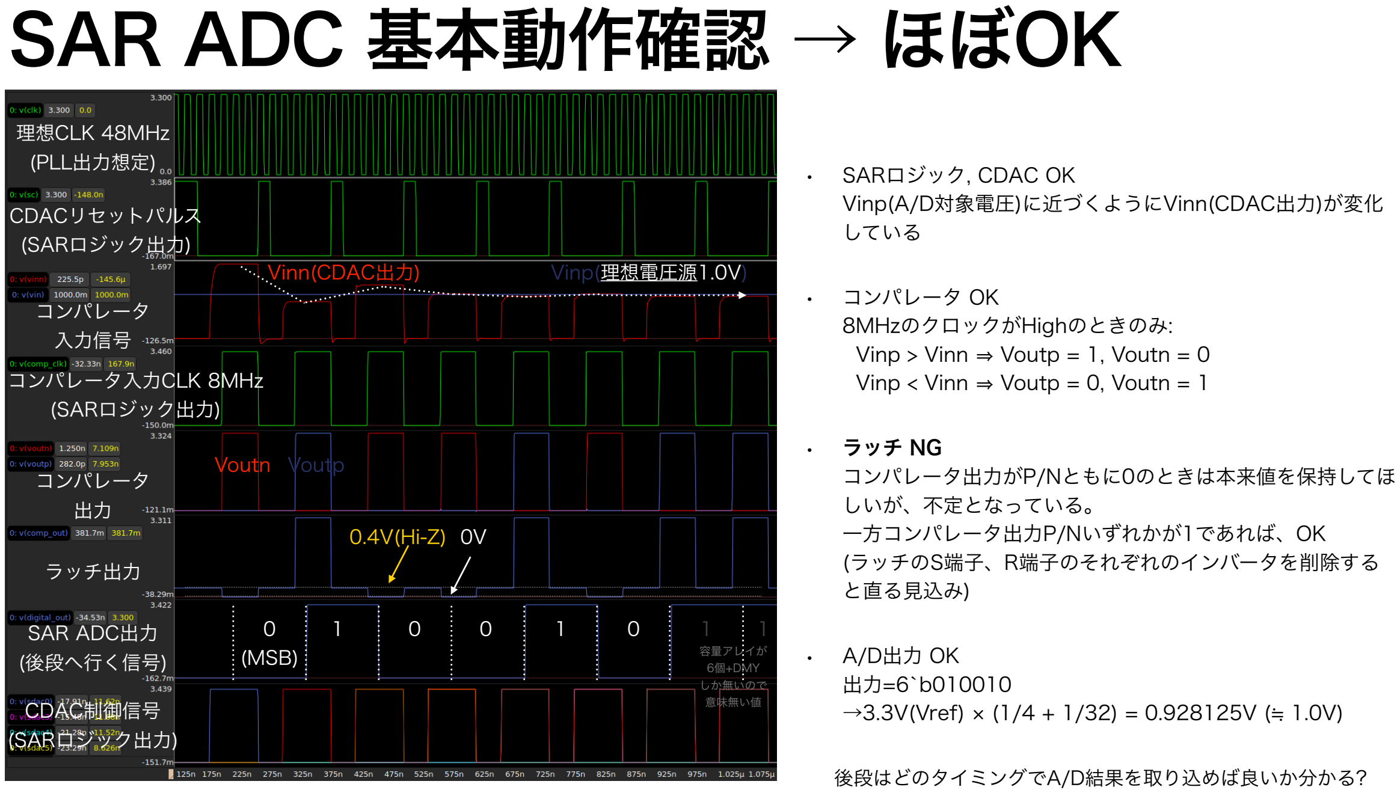
[picture p32: page 10]

- SARロジック, CDAC OK
Vinp(A/D対象電圧)に近づくようにVinn(CDAC出力)が変化 している
- コンパレータ OK
8MHzのクロックがHighのときのみ:
Vinp > Vinn Voutp = 1, Voutn = 0 Vinp < Vinn Voutp = 0, Voutn = 1
- ラッチ NG
コンパレータ出力がP/Nともに0のときは本来値を保持してほ しいが、不定となっている。
一方コンパレータ出力P/Nいずれかが1であれば、OK (ラッチのS端子、R端子のそれぞれのインバータを削除する と直る見込み)
- A/D出力 OK
出力=6`b010010
→3.3V(Vref) × (1/4 + 1/32) = 0.928125V ( 1.0V)

理想CLK 48MHz
(PLL出力想定)

CDACリセットパルス
(SARロジック出力)

コンパレータ
入力信号
Vinn(CDAC出力) | Vinp(理想電圧源1.0V)

コンパレータ入力CLK 8MHz
(SARロジック出力)

コンパレータ
出力

Voutn Voutp

ラッチ出力

SAR ADC出力
(後段へ行く信号)

CDAC制御信号
(SARロジック出力)

0.4V(Hi-Z) 0V

0
(MSB)
1 | 0 | 0 | 1 | 0 | 1 | 1

容量アレイが
6個+DMY
しか無いので
意味無い値

後段はどのタイミングでA/D結果を取り込めば良いか分かる?

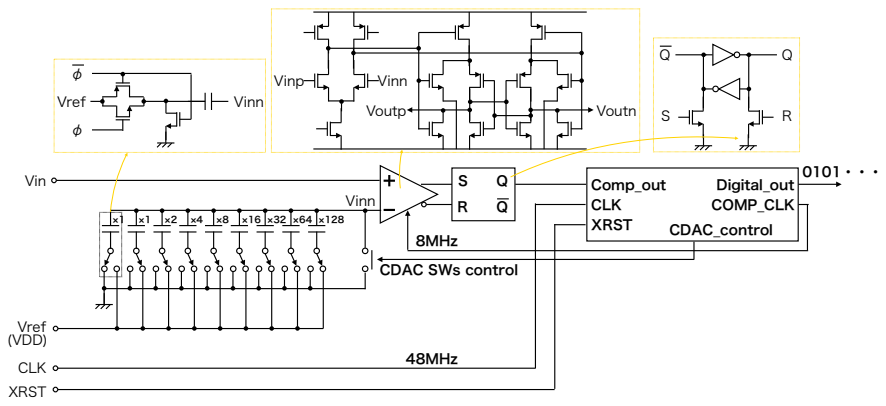
[picture p33: page 11]
Vinn; Vref; Vin; (VDD); Comp_out; CLK; XRST; CDAC_control; Digital_out COMP_CLK; 8MHz; Vinp; Voutp; Voutn; 48MHz

CDAC SWs control

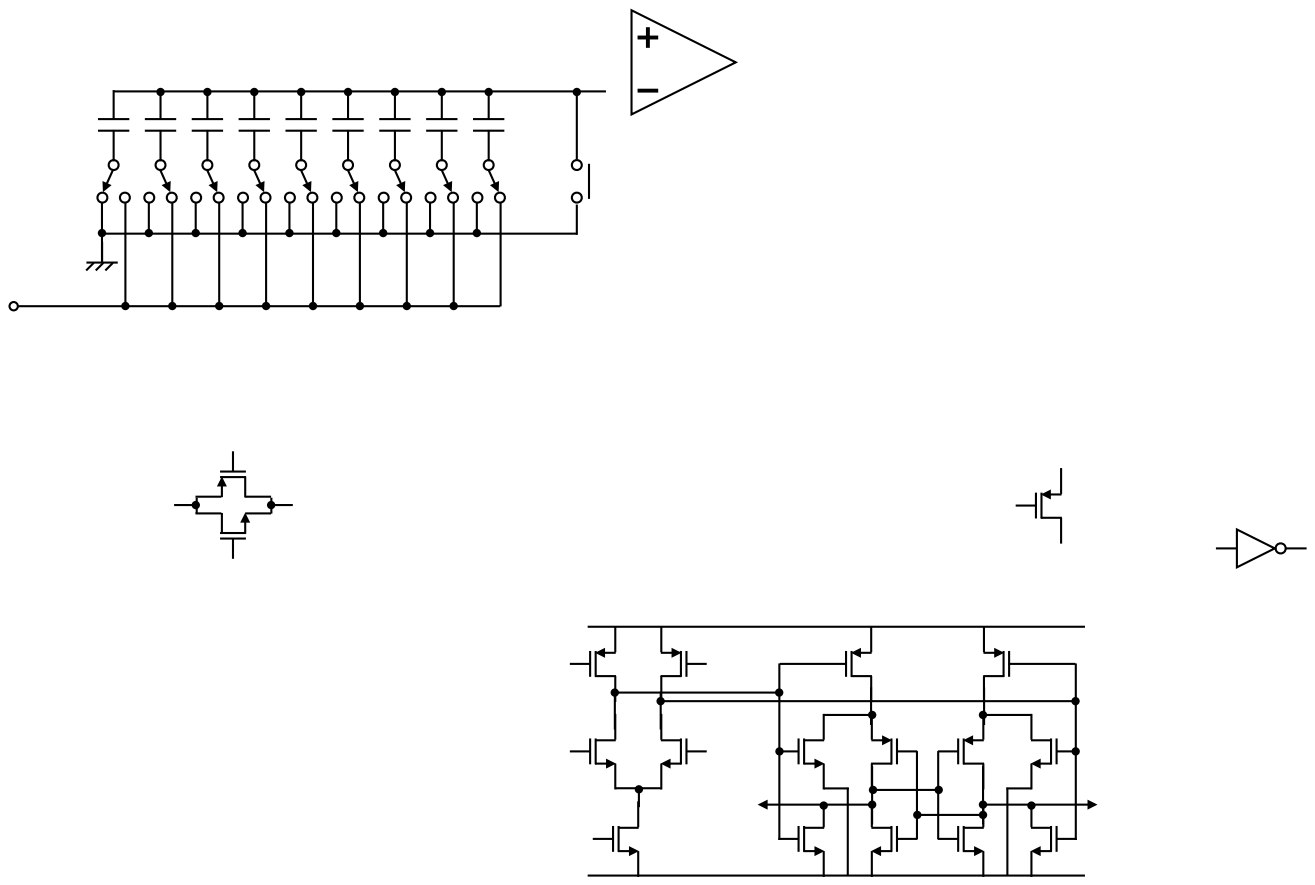
[picture p34: page 12]
