ishi-kai/Chipathon2023_ADC/tools/xschem/gf180_comp_mc/README.md

# gf180_comp_mc
Mismatch and Montecarlo simulation examples

# モンテカルロシミュレーション
コーナーをランダムに設定してシミュレーションを行います。

通常のシミュレーションでは”ダイ”の特性は最も平均的なもの(=typical)が設定されており、
コーナーではベスト(=ff)とワースト(ss)を見る事ができます。

これに対して、モンテカルロシミュレーションではベスト－ティピカル－ワーストの間を
確率的に（ランダムに）設定して特性をみることができます。

尚、モンテカルロシミュレーションで変更されるパラメータは酸化膜厚とチャネル長／幅のオフセット等です。

例えばMOSFETでは以下のパラメータが変更されます。
```
vth0 - Long channel threshold voltage at Vbs = 0
tox - Oxide thickness (toxp=toxe=tox)
xl - Channel length offset due to mask/etch effect
xw - Channel width offset due to mask/etch effect
xj - Junction depth
rdsw - Zero bias LDD resistance per unit width
```

モデルを読み込む際はコーナー```statistical```を適用します。
ダイオードとMOSCAPは対応していません。
```
.lib $::180MCU_MODELS/sm141064.ngspice statistical
.lib $::180MCU_MODELS/sm141064.ngspice bjt_statistical
.lib $::180MCU_MODELS/sm141064.ngspice res_statistical
.lib $::180MCU_MODELS/sm141064.ngspice mimcap_statistical

.lib $::180MCU_MODELS/sm141064.ngspice cap_mim
.lib $::180MCU_MODELS/sm141064.ngspice diode_typical
.lib $::180MCU_MODELS/sm141064.ngspice moscap_typical
```

# ミスマッチシミュレーション
各素子の特性を確率的に（ランダムに）振ってシミュレーションを行います。

コーナーシミュレーションではモンテカルロシミュレーションでは全体の特性を変更しているだけで、
各素子間のばらつきは一様（つまりばらつきなし）としています。

しかし、実際は隣接する素子ですら特性は異なっています。そのためのミスマッチシミュレーションです。

ミスマッチではMOSFET、抵抗、BJTの特性が変わります。

MOSFETでは各素子に対して```delvto```がランダムに設定され、Vthが変動します。また、Vthが変動したことでgmなどのパラメータも併せて変動します。

# ミスマッチ付きモンテカルロシミュレーション
両方組み合わせてより現実に近いばらつきを考慮してシミュレーションを行う事も可能です。

# 例
例として、２個のPFETの動作点解析を見てみますす。

モンテカルロシミュレーションであってミスマッチシミュレーションでない場合、
2個のPFETは同じ特性です。

```
 BSIM4v5: Berkeley Short Channel IGFET Model-4
     device              m.xm2.m0              m.xm1.m0
      model           pfet_03v3.4           pfet_03v3.4
          l               2.8e-07               2.8e-07
          w                 1e-06                 1e-06
          m                     1                     1
         nf                     1                     1
         sa                     0                     0
         sb                     0                     0
         sd                     0                     0
        sca                     0                     0
        scb                     0                     0
        scc                     0                     0
         sc                     0                     0
        min                     0                     0
         ad               1.8e-13               1.8e-13
         as               1.8e-13               1.8e-13
         pd              2.36e-06              2.36e-06
         ps              2.36e-06              2.36e-06
        nrd                  0.18                  0.18
        nrs                  0.18                  0.18
        off                     0                     0
       rbdb                    50                    50
       rbsb                    50                    50
       rbpb                    50                    50
       rbps                    50                    50
       rbpd                    50                    50
     delvto                     0                     0
      mulu0                     1                     1
        xgw                     0                     0
      ngcon                     1                     1
   trnqsmod                     0                     0
   acnqsmod                     0                     0
   rbodymod                     0                     0
   rgatemod                     0                     0
     geomod                     0                     0
    rgeomod                     0                     0
       gmbs           4.91256e-05           4.91256e-05
         gm           0.000130725           0.000130725
        gds           1.31696e-05           1.31696e-05
      vdsat               2.02446               2.02446
        vth              0.555569              0.555569
         id           0.000275164           0.000275164
        ibd           -3.3026e-12           -3.3026e-12
        ibs          -3.46729e-16          -3.46729e-16
        gbd           1.00326e-12           1.00326e-12
        gbs           1.00006e-12           1.00006e-12
       isub           4.31245e-13           4.31245e-13
      igidl                     0                     0
      igisl                     0                     0
        igs                     0                     0
        igd                     0                     0
        igb                     0                     0
       igcs                     0                     0
       igcd                     0                     0
        vbs          -0.000346707          -0.000346707
        vgs               3.29965               3.29965
        vds               3.29931               3.29931
        cgg           9.46979e-16           9.46979e-16
        cgs          -7.85285e-16          -7.85285e-16
        cgd           6.86937e-18           6.86937e-18
        cbg          -1.55994e-16          -1.55994e-16
        cbd           2.79381e-18           2.79381e-18
        cbs          -2.66831e-16          -2.66831e-16
        cdg          -3.16524e-16          -3.16524e-16
        cdd          -3.71566e-18          -3.71566e-18
        cds           4.20869e-16           4.20869e-16
        csg           -4.7446e-16           -4.7446e-16
        csd          -5.94753e-18          -5.94753e-18
        css           6.31247e-16           6.31247e-16
        cgb          -1.68563e-16          -1.68563e-16
        cdb          -1.00629e-16          -1.00629e-16
        csb          -1.50839e-16          -1.50839e-16
        cbb           4.20031e-16           4.20031e-16
      capbd           6.09241e-16           6.09241e-16
      capbs           8.55644e-16           8.55644e-16
         qg           3.60157e-15           3.60157e-15
         qb          -1.32473e-15          -1.32473e-15
         qd          -9.10864e-16          -9.10864e-16
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
         qs          -8.86557e-21          -1.62183e-15
       qinv           1.45573e-23            3.1602e-15
       qdef                     0                    -0
       gcrg                     0                     0
       gtau                     0                     0

```
