ishi-kai/Chipathon2023_ADC/review/0407/latch/README.txt

きなこ分
transmission gate と latch を作成。
latch、SとRの機能が反転している気がする。
スイッチは全体を統合後に調整。
