ishi-kai/Chipathon2023_ADC/tools/klayout/tips/VIA_Pcell.pptx

## VIA

Noritsuna Imamura
noritsuna@ishi-kai.org

## Slide 2

Incetanceを選択
or
I(アイ)キーを押す

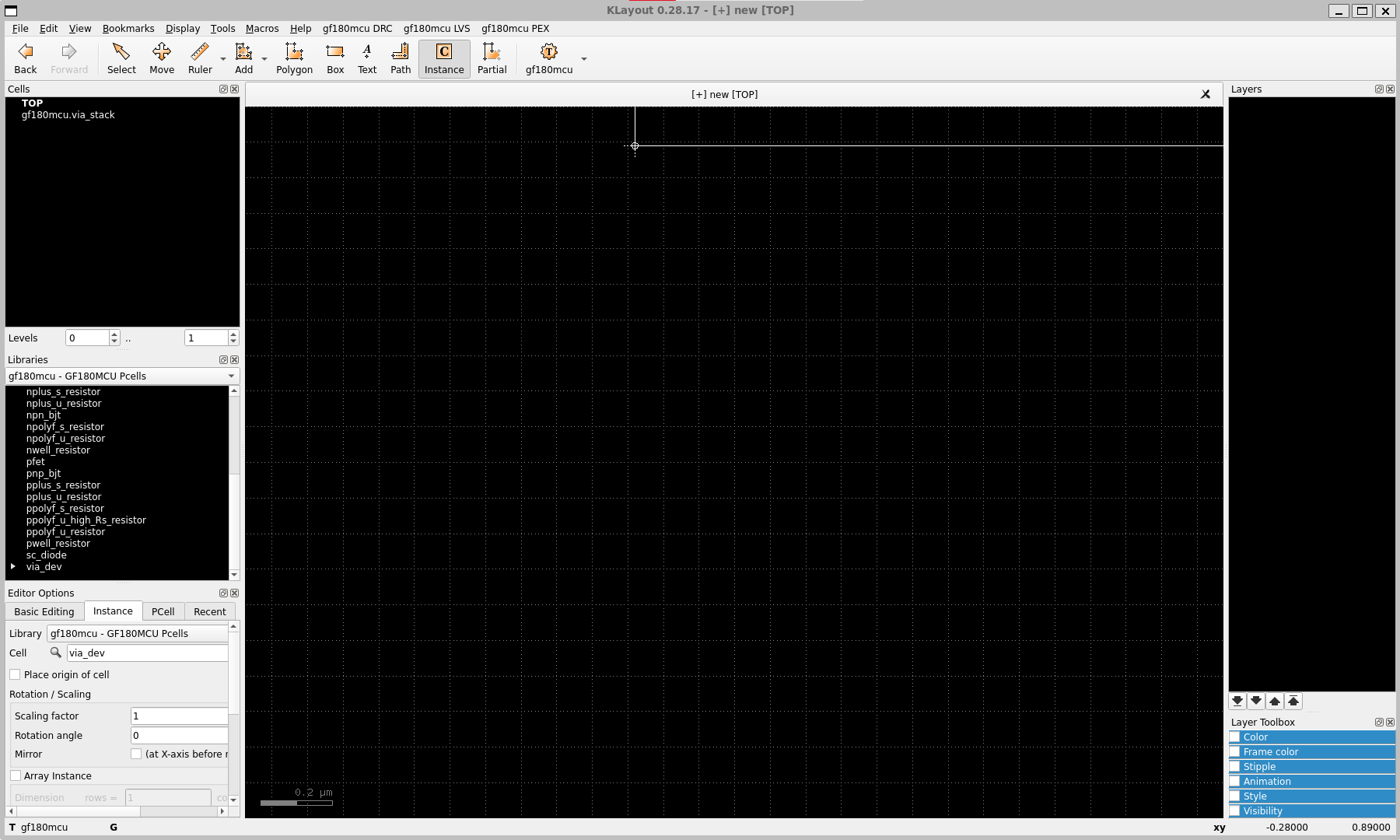
[picture p43: figure]

P-Cell
と
Via_dev
を選択

## Slide 3

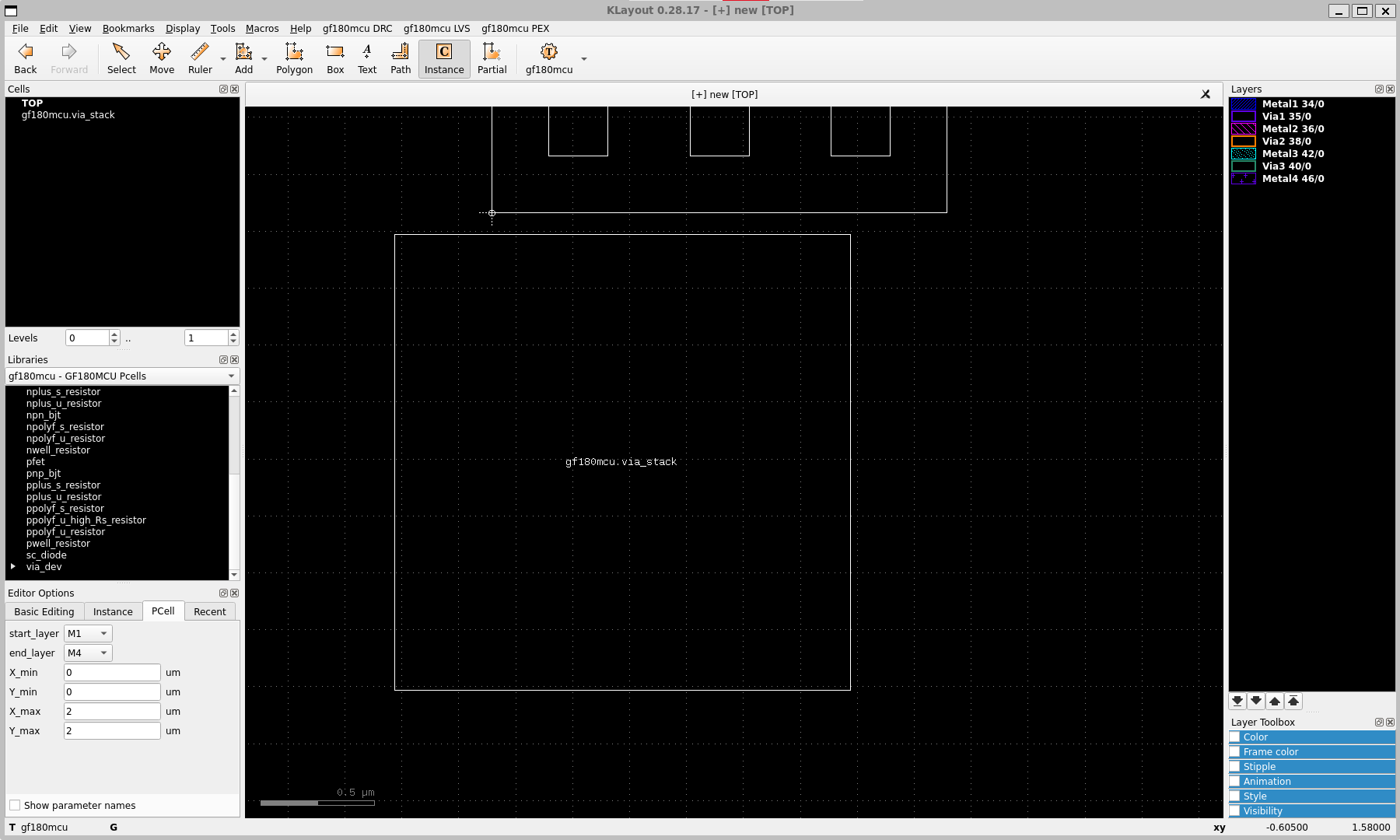
[picture p44: figure]

こんな感じでVIAが出来る

使いたいレイヤーを指定
M1=1層（青）
M4=4層（紫）

作りたいサイズを指定

## Slide 4

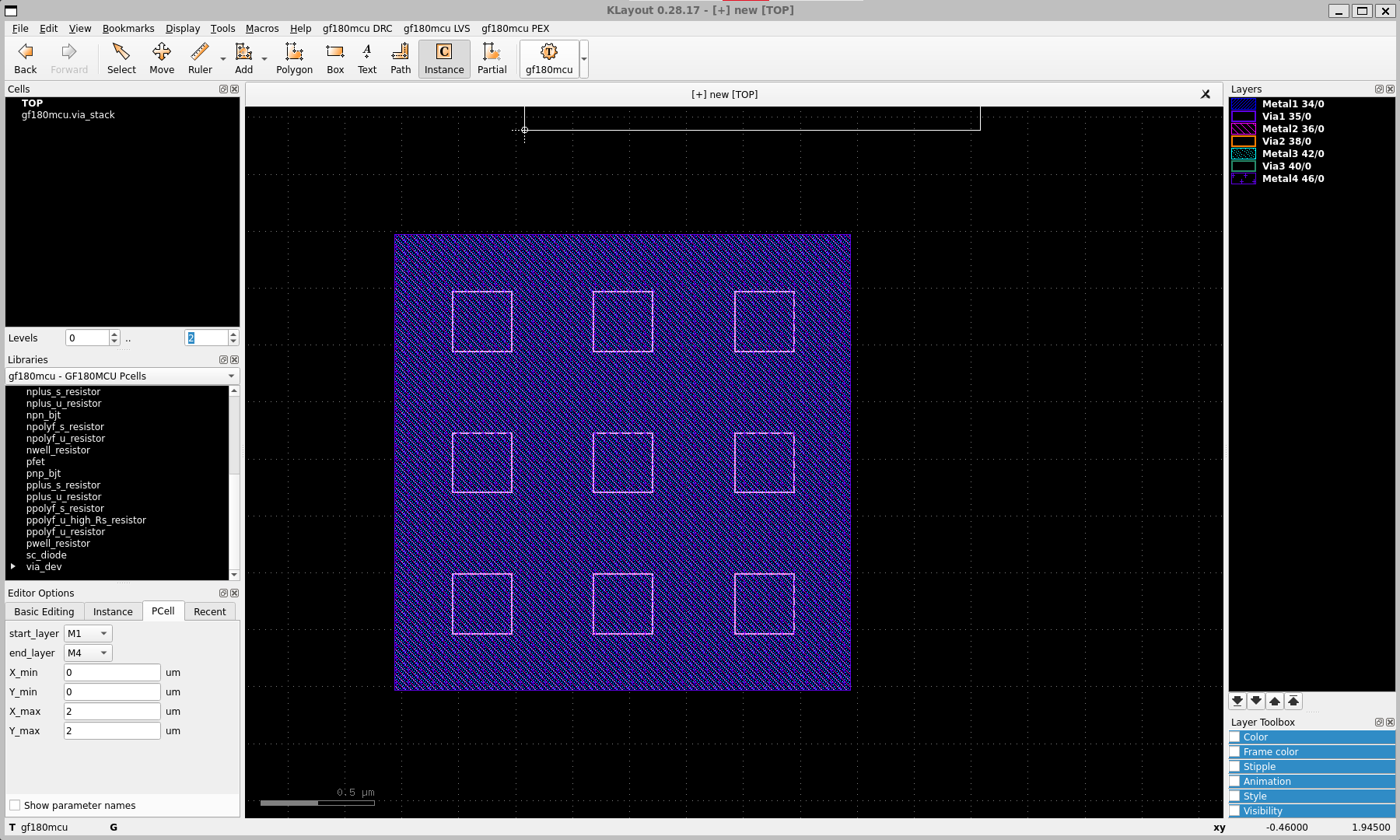
[picture p45: figure]

ここの数字を上げると中身が見える

中身は
こうなっている

## Slide 5

作った分だけここにVIAのセルが出来る

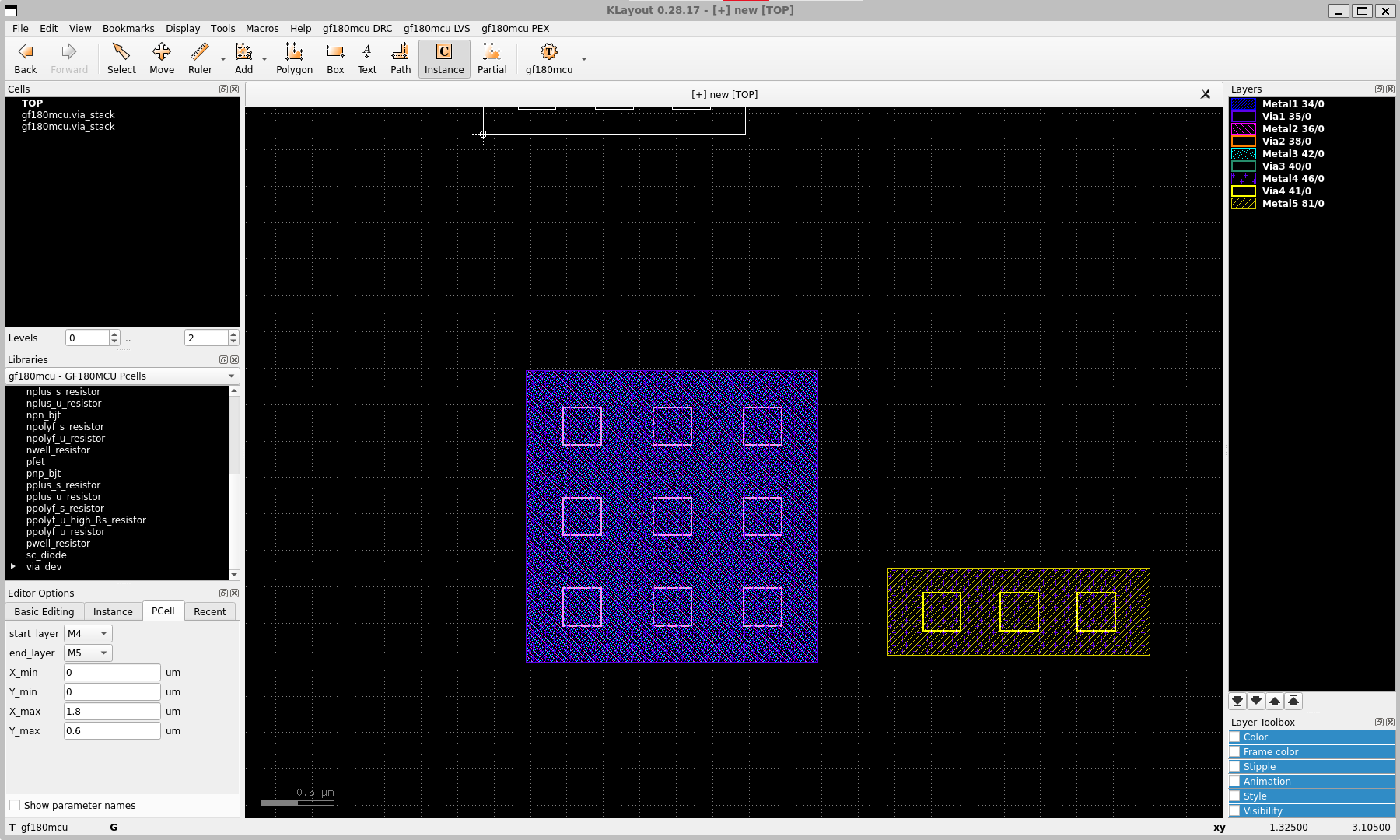
[picture p46: figure]

レイヤーとサイズを変えたバージョン
