ishi-kai/Chipathon2023_ADC/tools/klayout/tips/array_cell.pptx

## Cell化とArray配置

## Cell化

## Slide 3

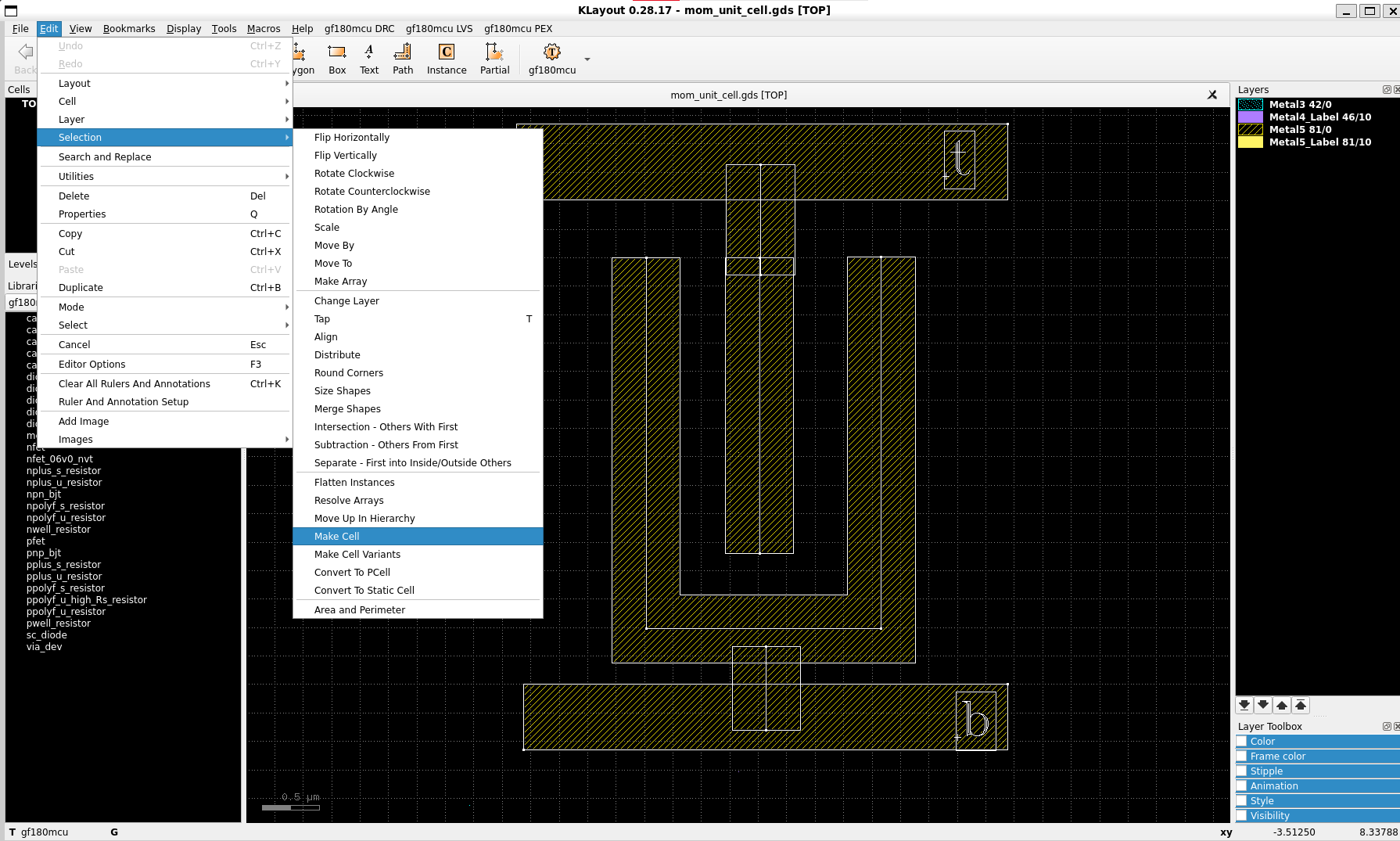
[picture p47: figure]

## Slide 4

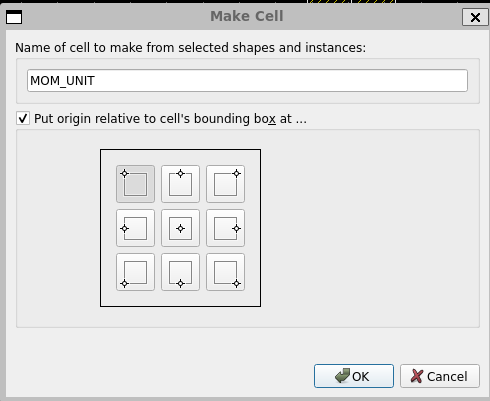
[picture p48: figure]

## Slide 5

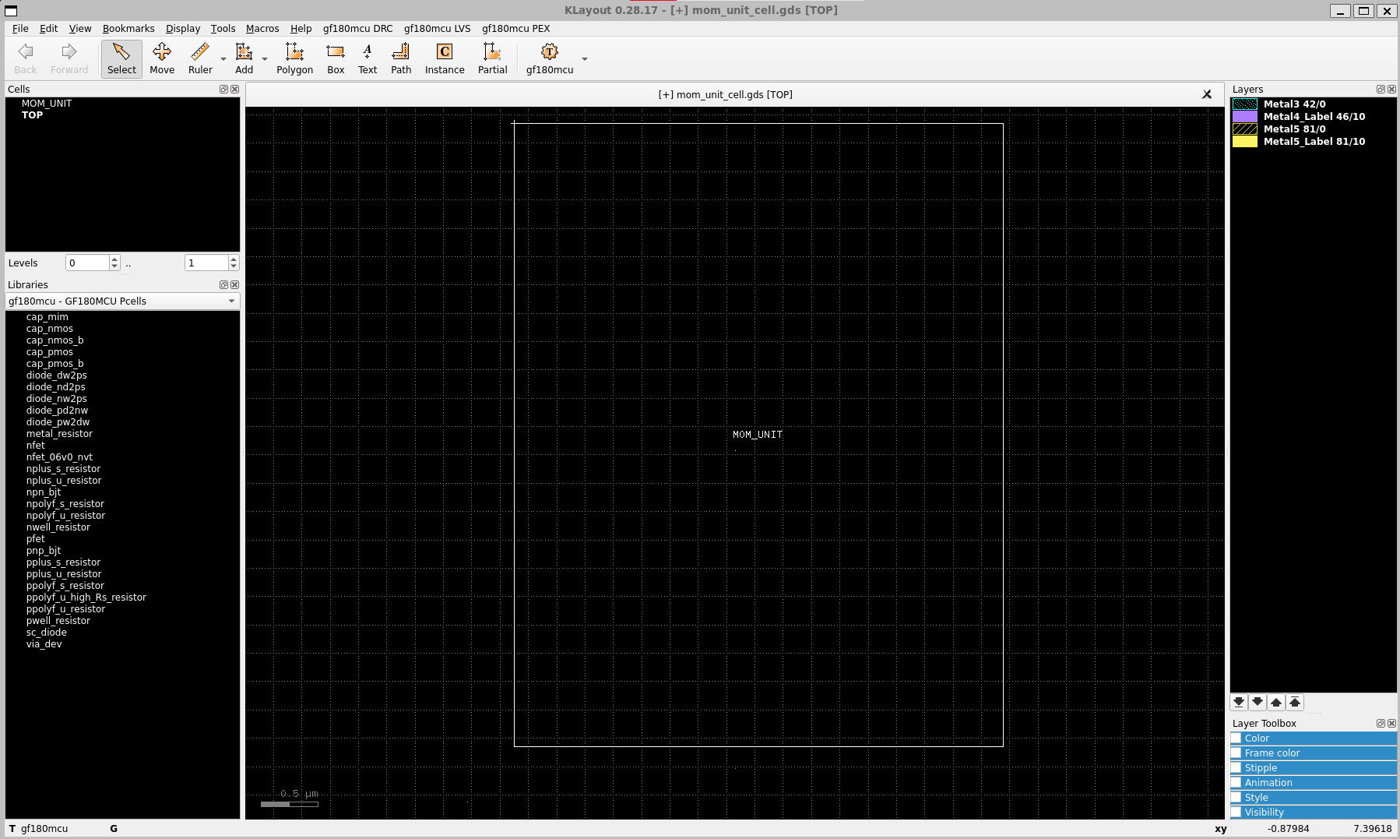
[picture p49: figure]

## Array

## Slide 7

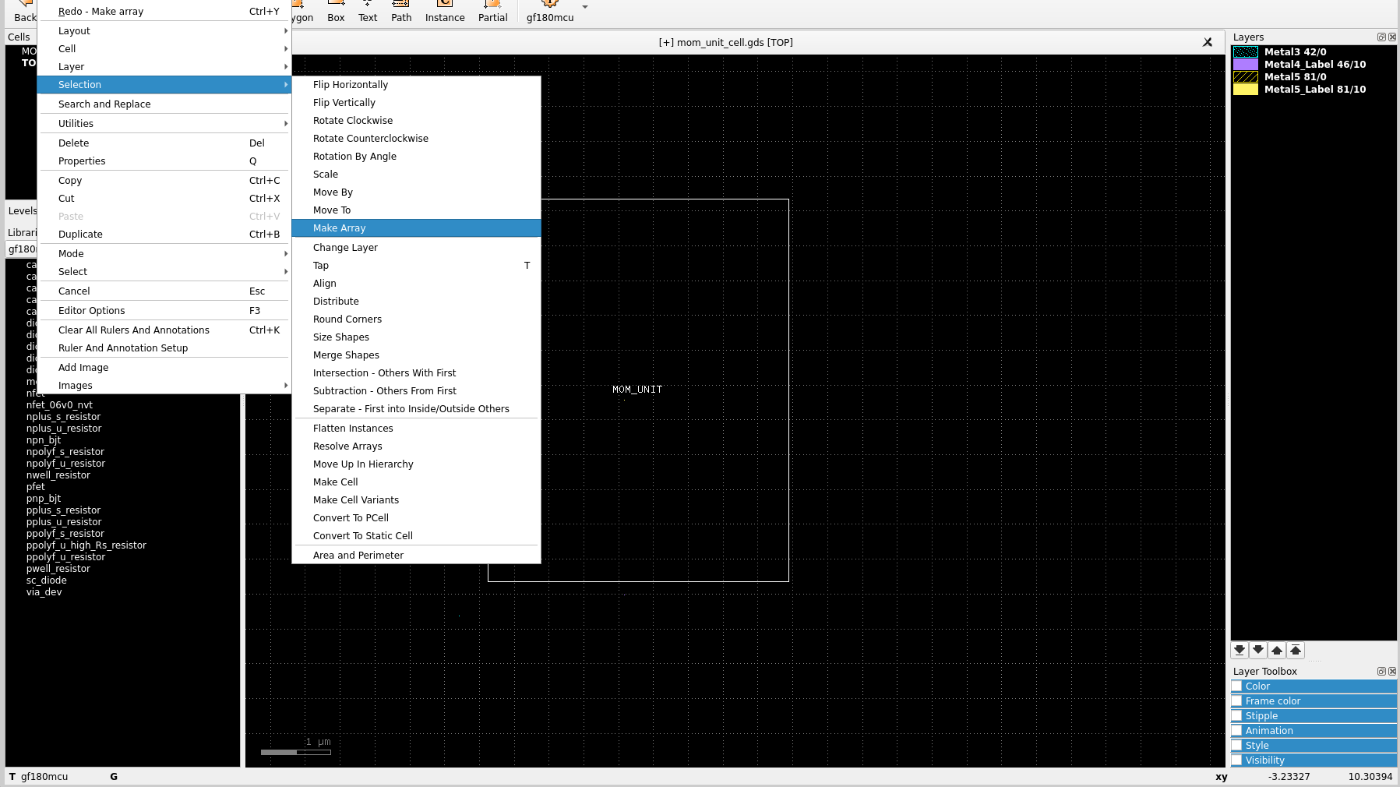
[picture p50: figure]

## Slide 8

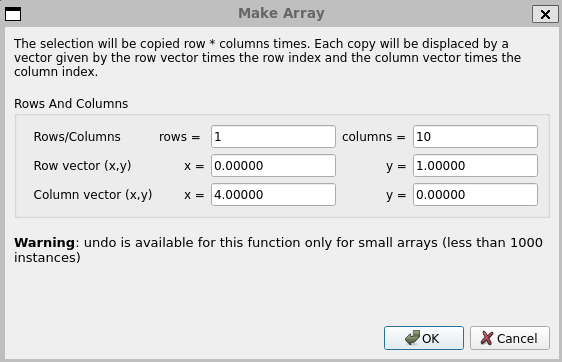
[picture p51: figure]

## Slide 9

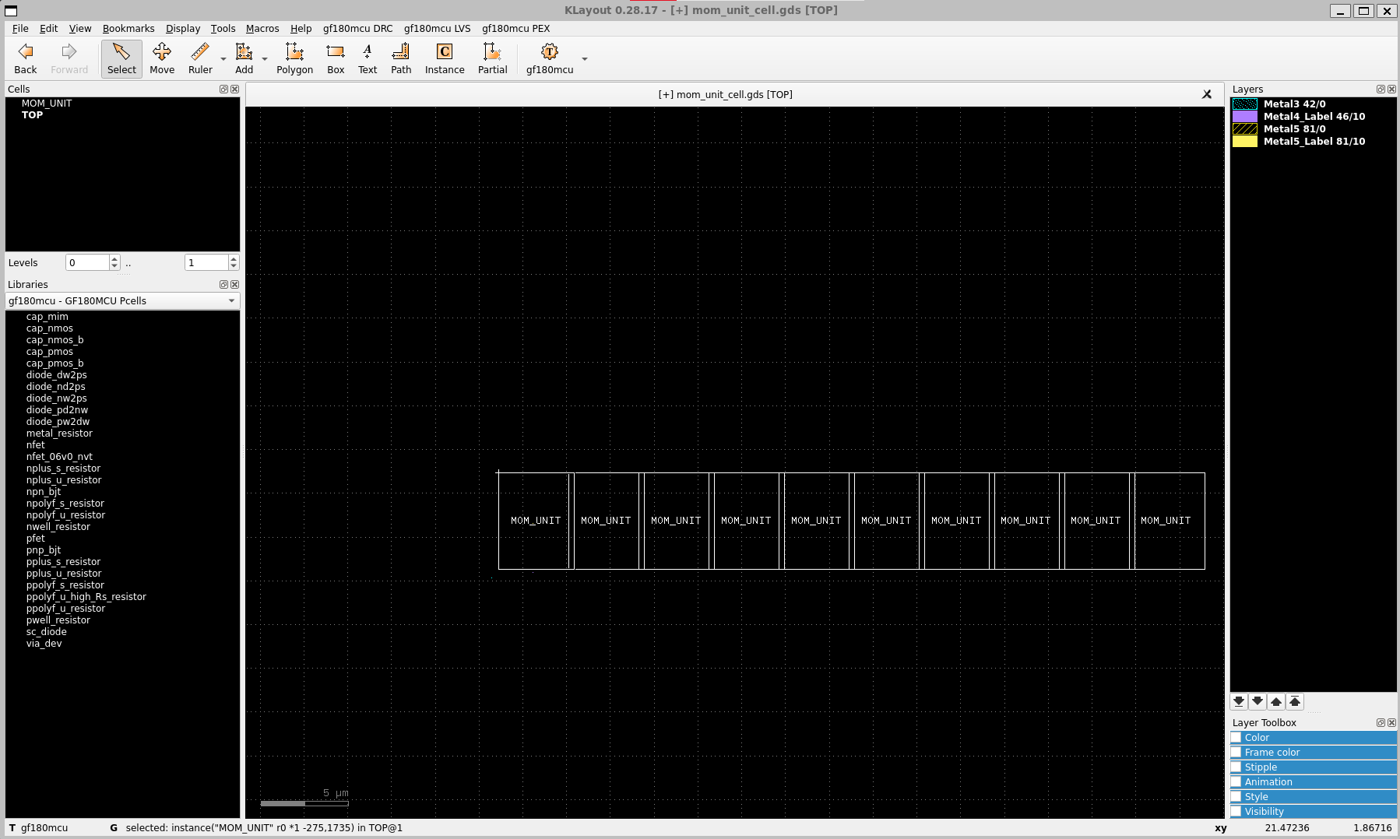
[picture p52: figure]

## Slide 10

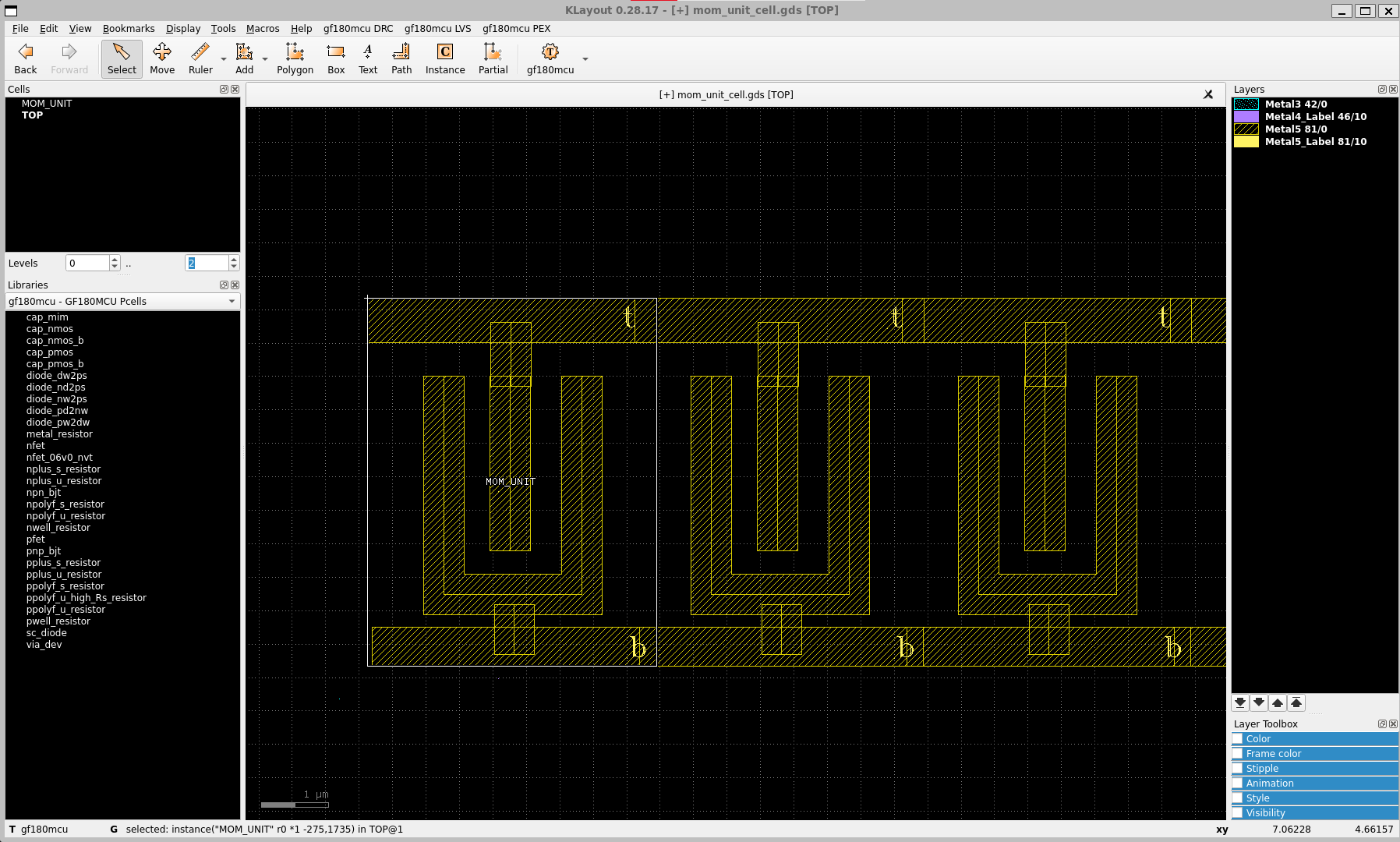
[picture p53: figure]
