ishi-kai/Chipathon2023_ADC/noritsuna/ps/circuit_image.png

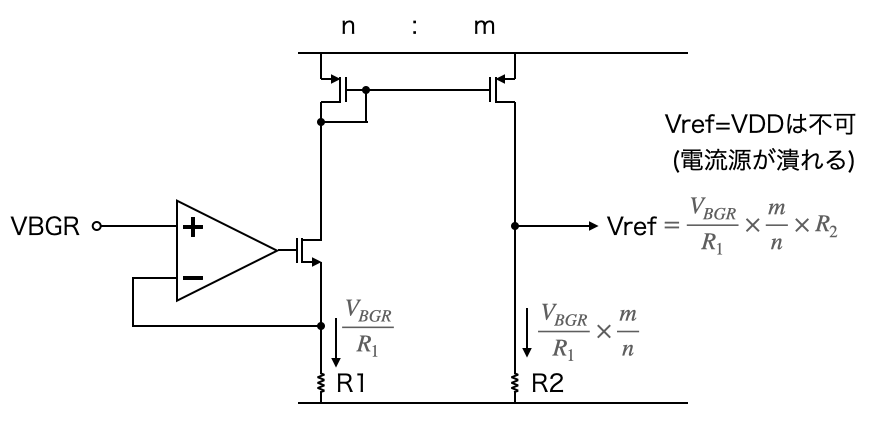
noritsuna/ps/circuit_image.png
