ishi-kai/Chipathon2023_ADC/submit_version/images/bgr_diode.png

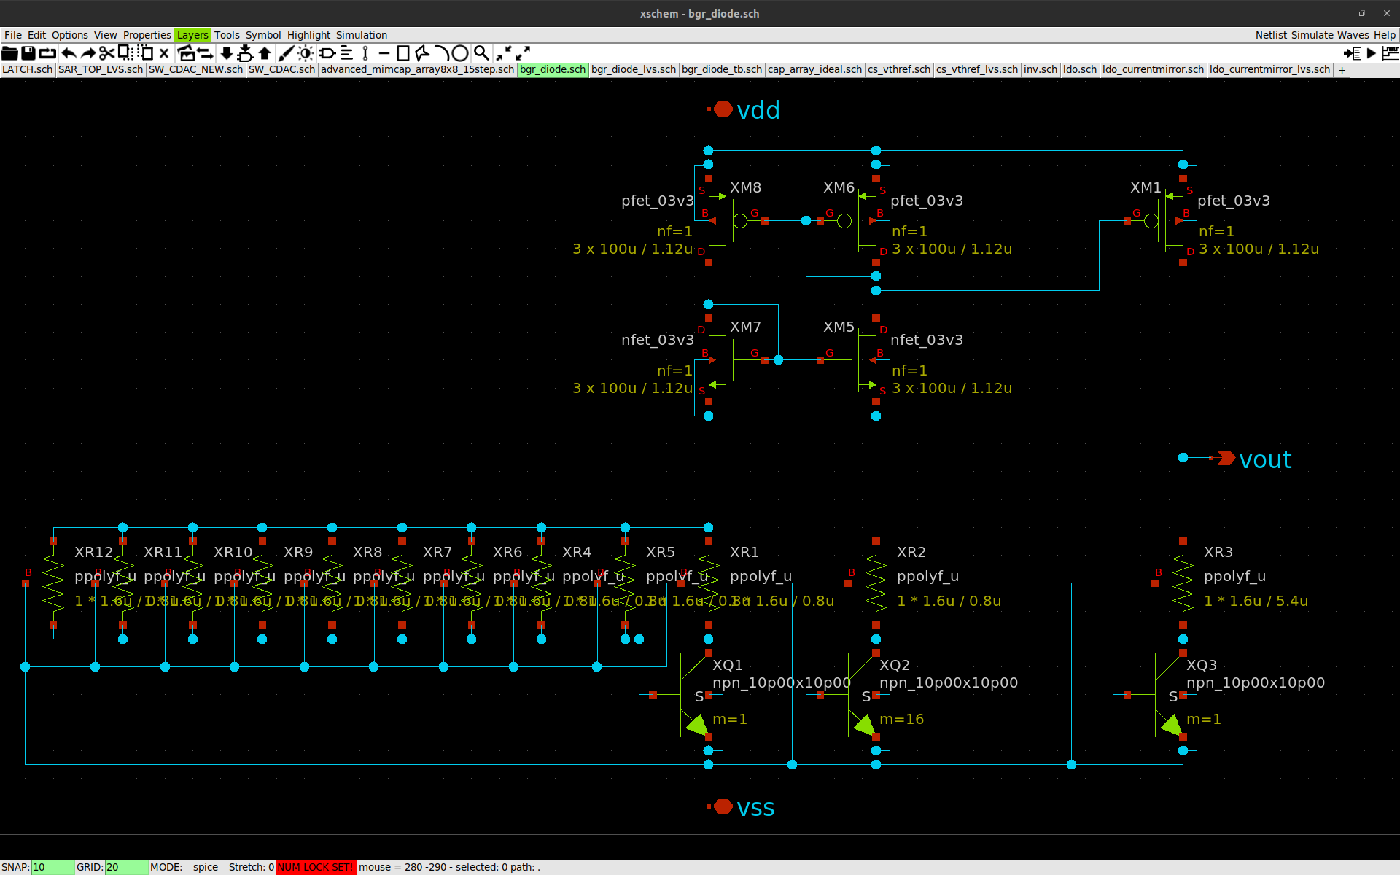
submit_version/images/bgr_diode.png
