ishi-kai/Chipathon2023_ADC/submit_version/images/bgr_diode_tb.png

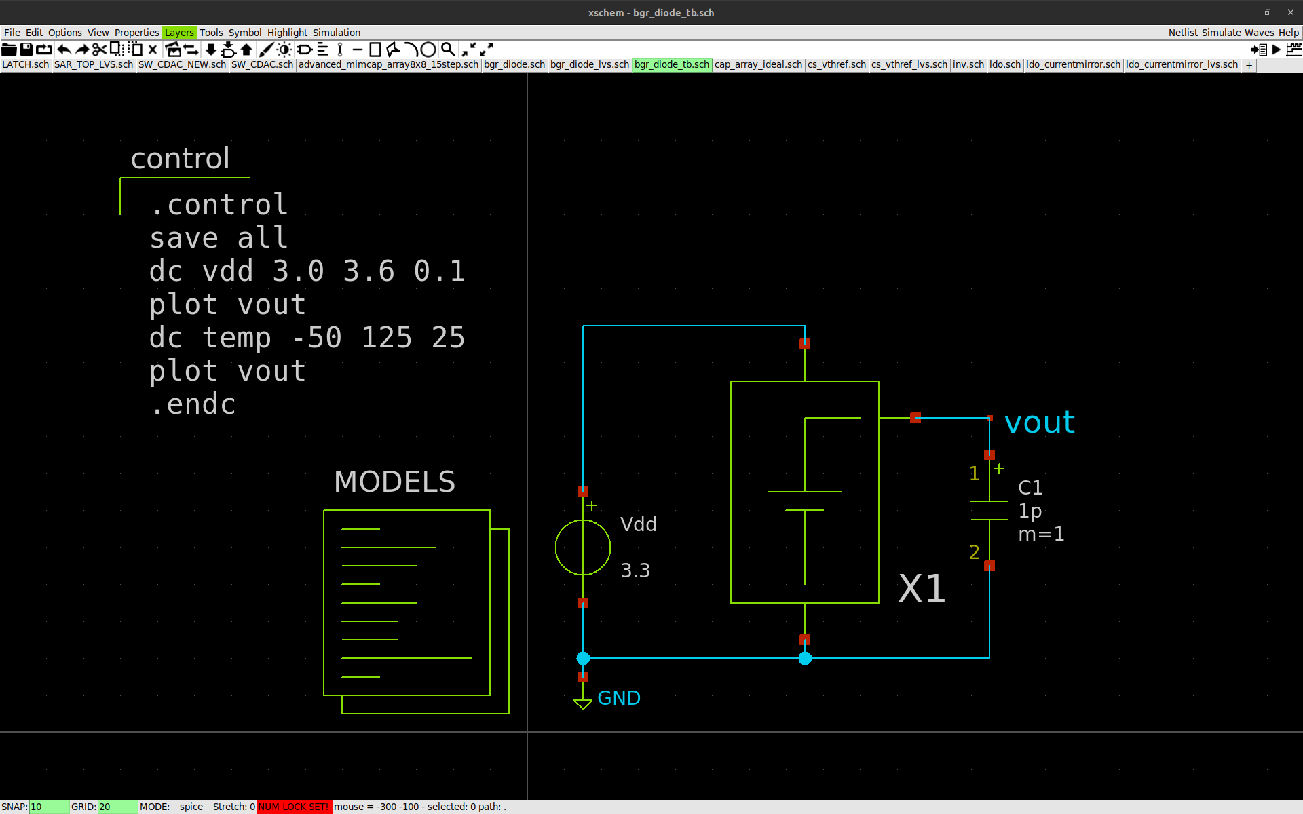
submit_version/images/bgr_diode_tb.png
