ishi-kai/Chipathon2023_ADC/submit_version/images/cap_array_ideal.png

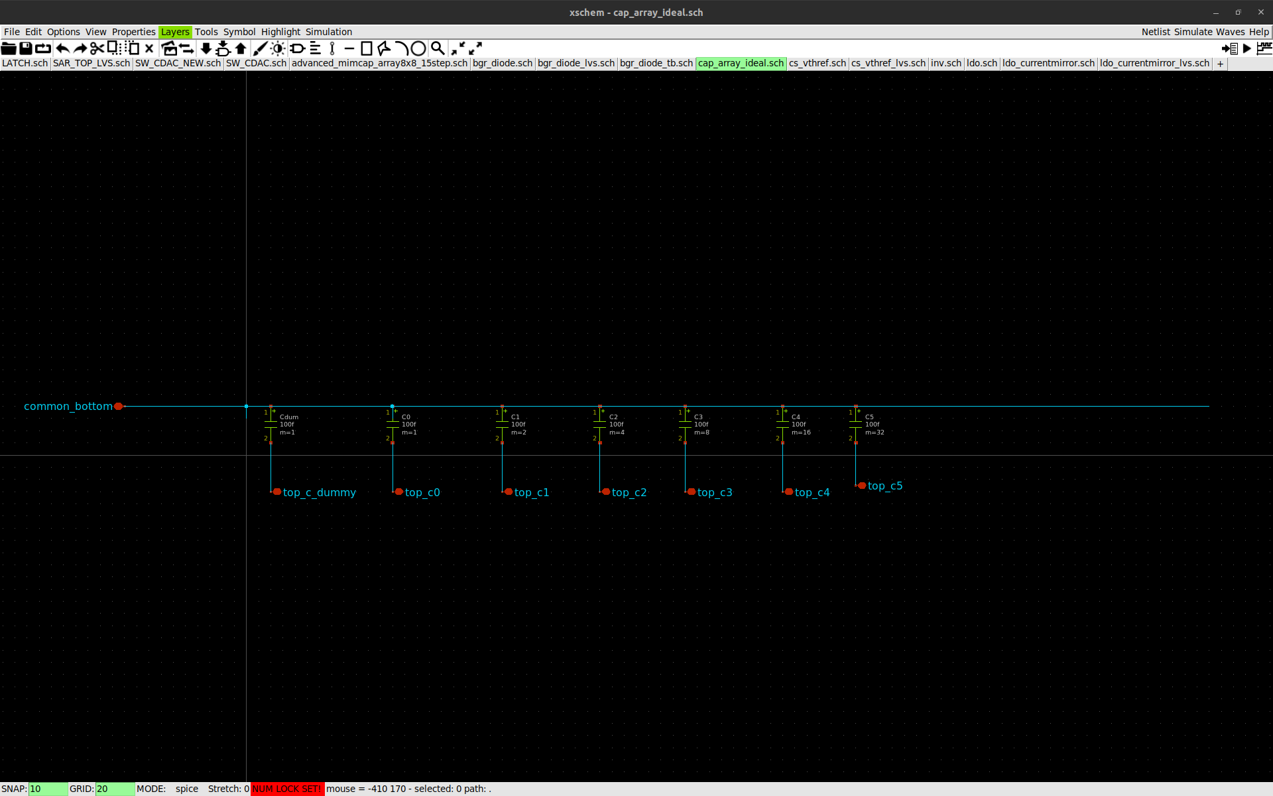
submit_version/images/cap_array_ideal.png
