ishi-kai/Chipathon2023_ADC/submit_version/images/cs_vthref.png

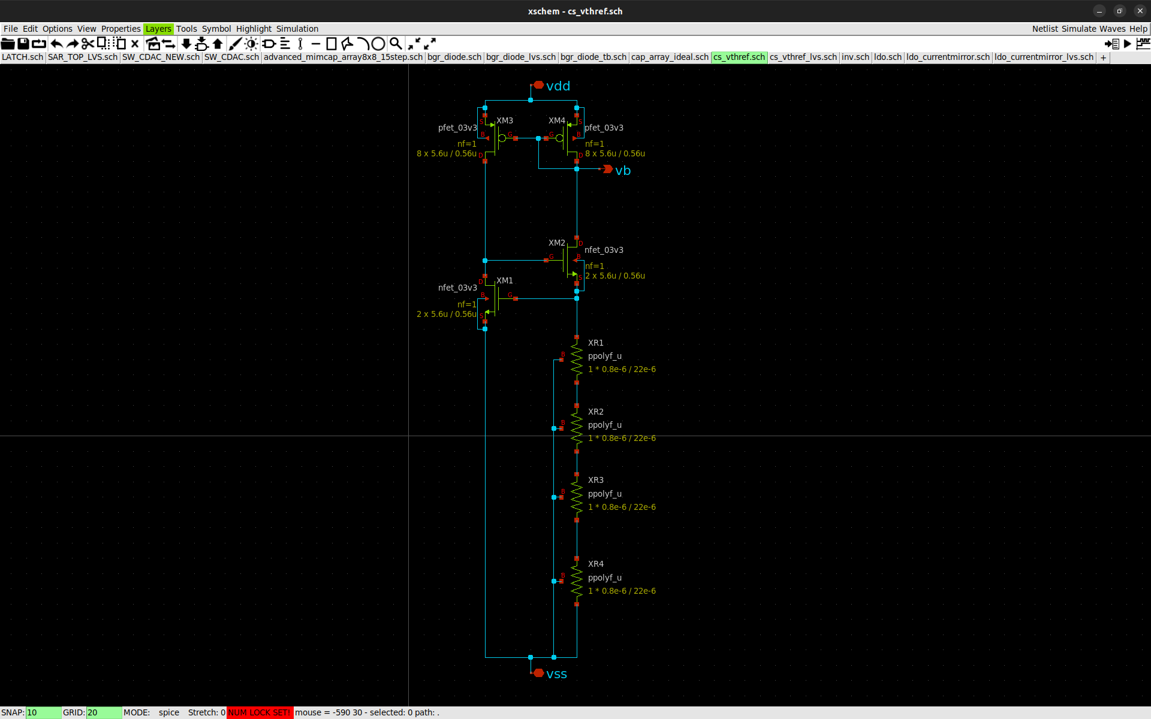
submit_version/images/cs_vthref.png
