ishi-kai/Chipathon2023_ADC/submit_version/images/Ido_lvs.png

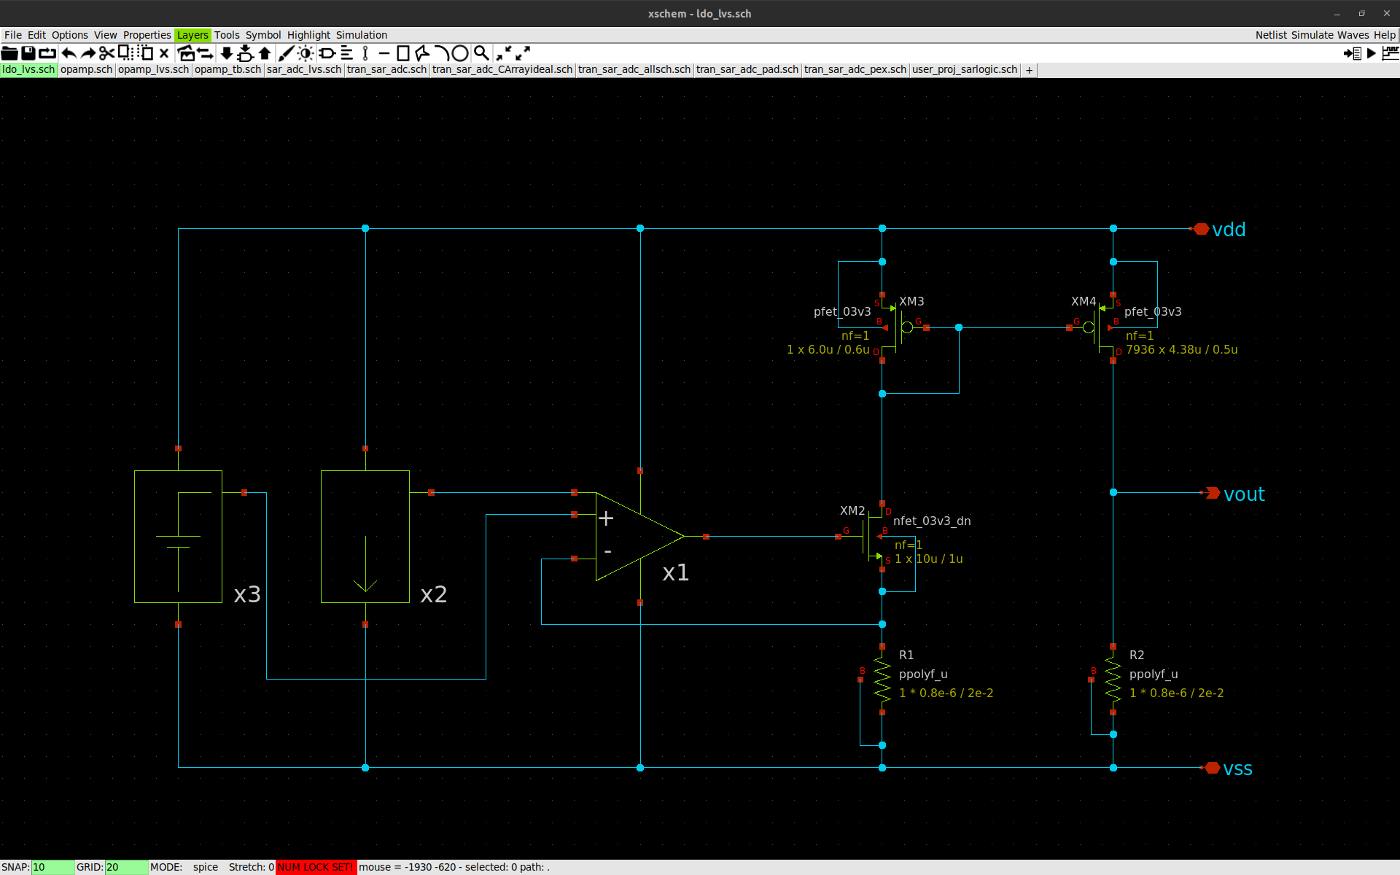
submit_version/images/Ido_lvs.png
