ishi-kai/Chipathon2023_ADC/submit_version/images/ldo_currentmirror.png

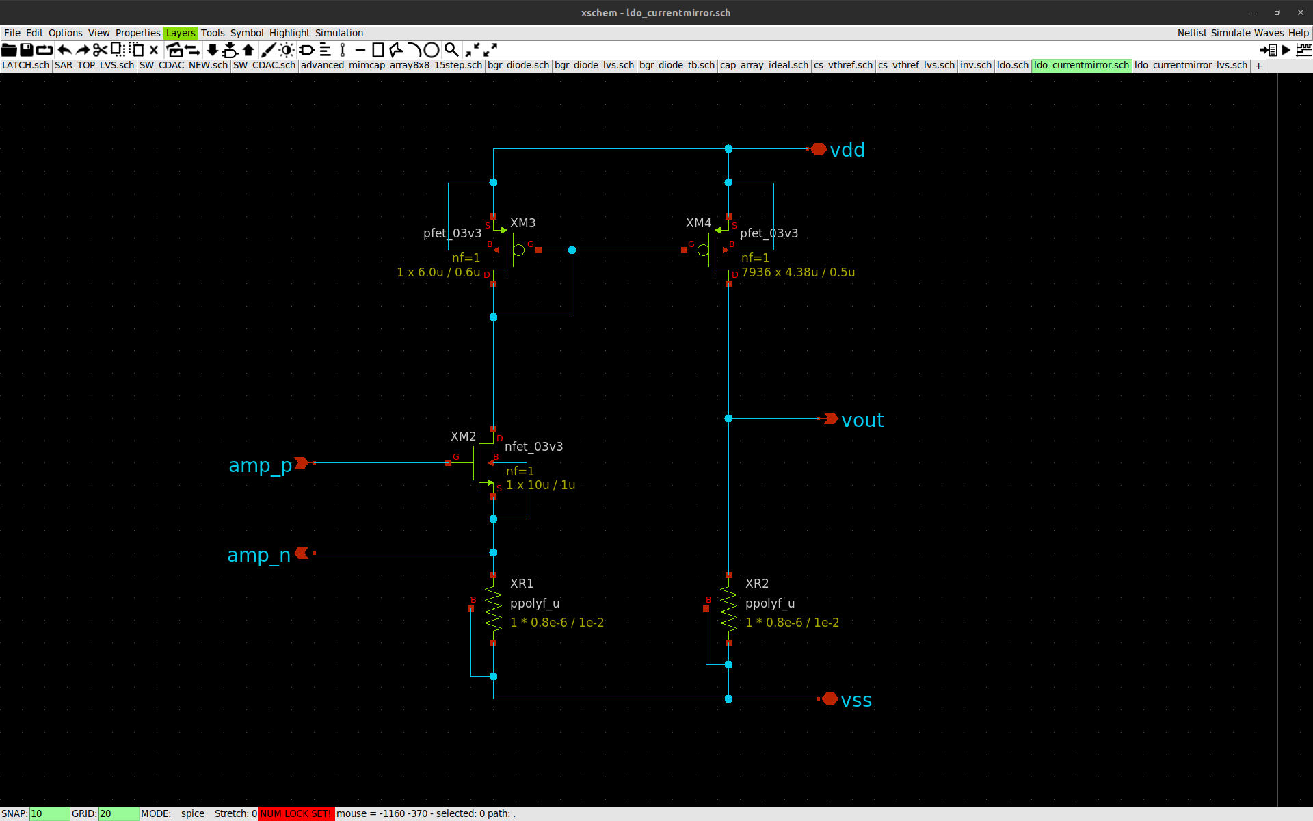
submit_version/images/ldo_currentmirror.png
