ishi-kai/Chipathon2023_ADC/submit_version/images/ldo_currentmirror_lvs.png

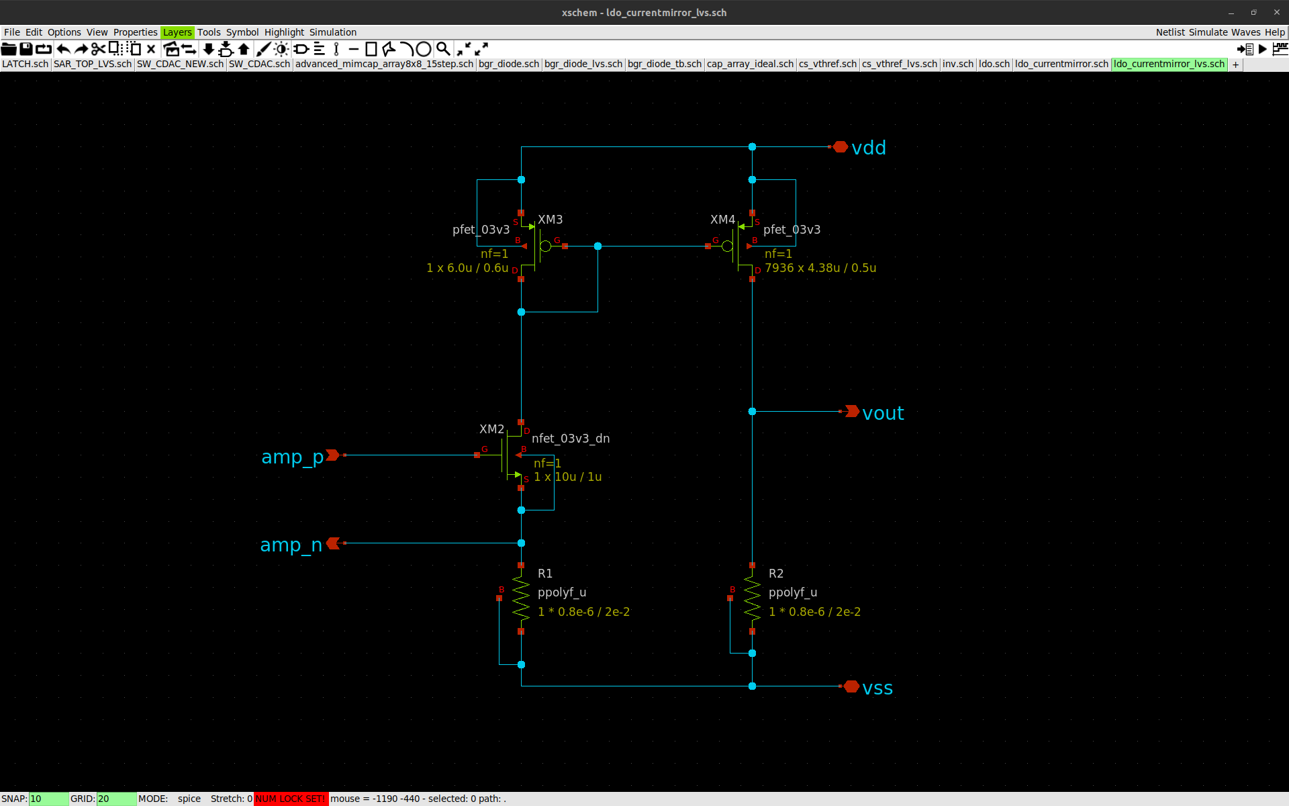
submit_version/images/ldo_currentmirror_lvs.png
