ishi-kai/Chipathon2023_ADC/submit_version/images/opamp.png

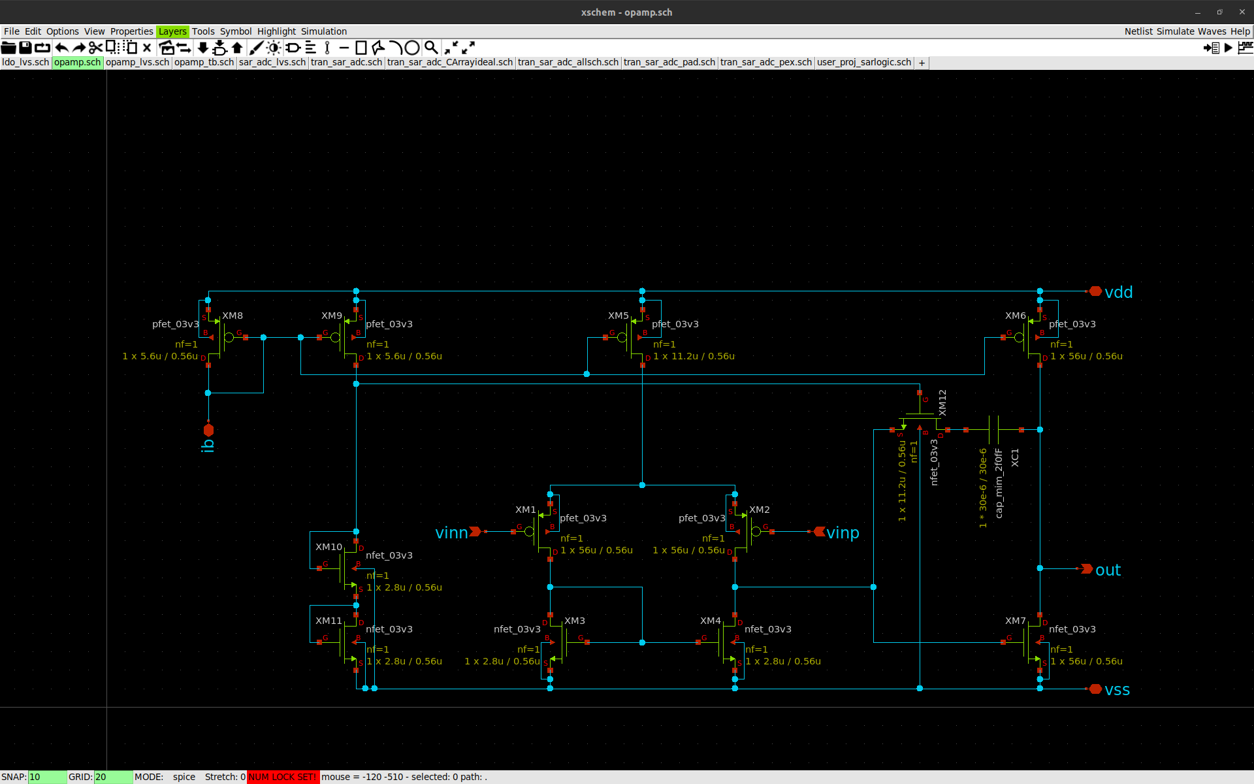
submit_version/images/opamp.png
