ishi-kai/Chipathon2023_ADC/submit_version/images/opamp_lvs.png

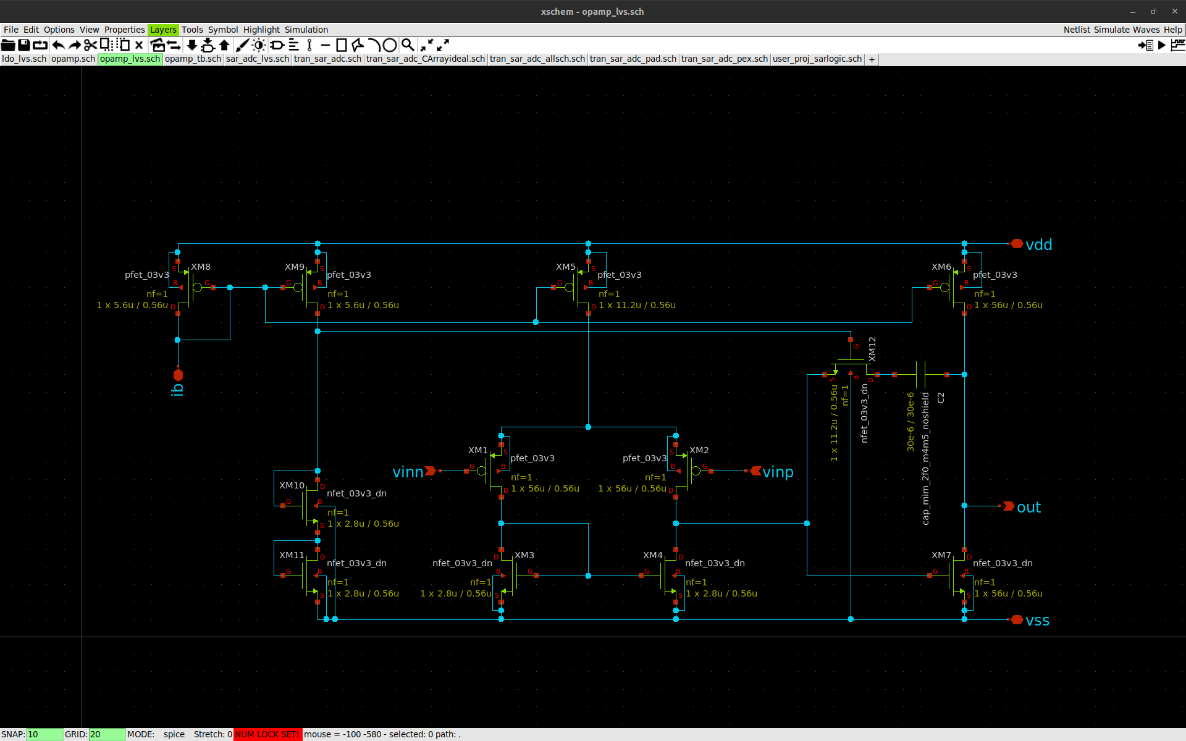
submit_version/images/opamp_lvs.png
