ishi-kai/Chipathon2023_ADC/submit_version/images/opamp_tb.png

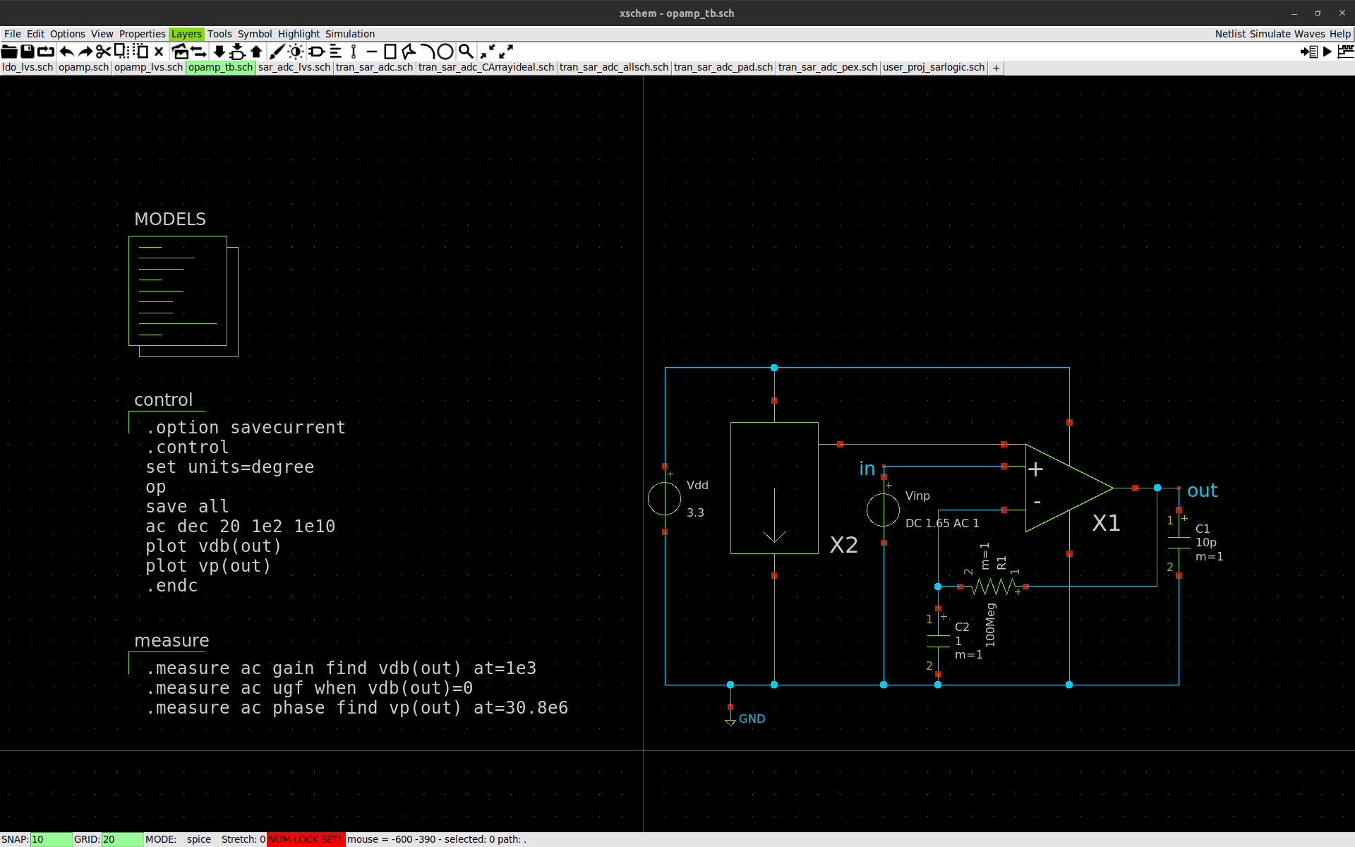
submit_version/images/opamp_tb.png
