ishi-kai/Chipathon2023_ADC/submit_version/images/sar_adc_lvs.png

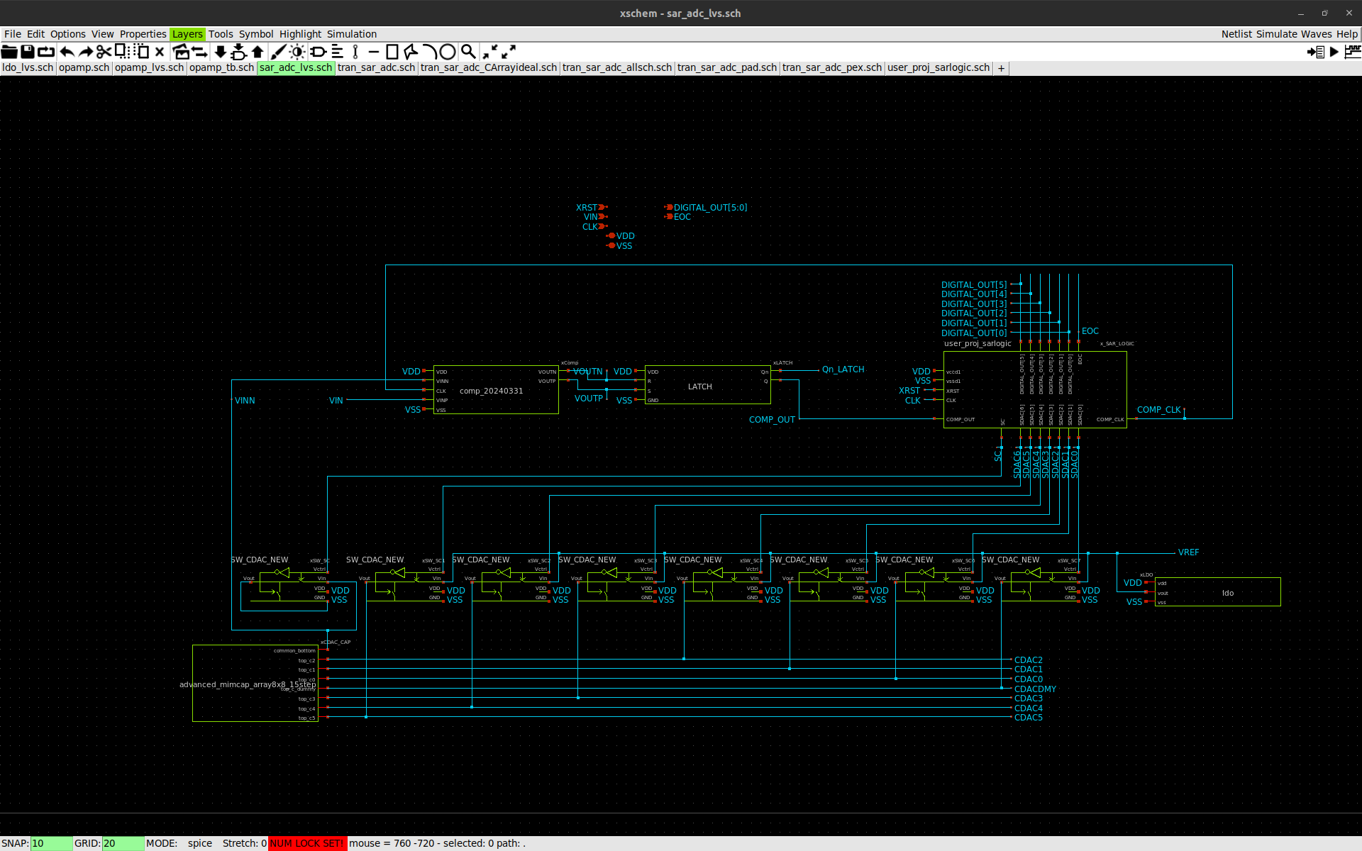
submit_version/images/sar_adc_lvs.png
