ishi-kai/Chipathon2023_ADC/submit_version/images/SAR_CDAC.png

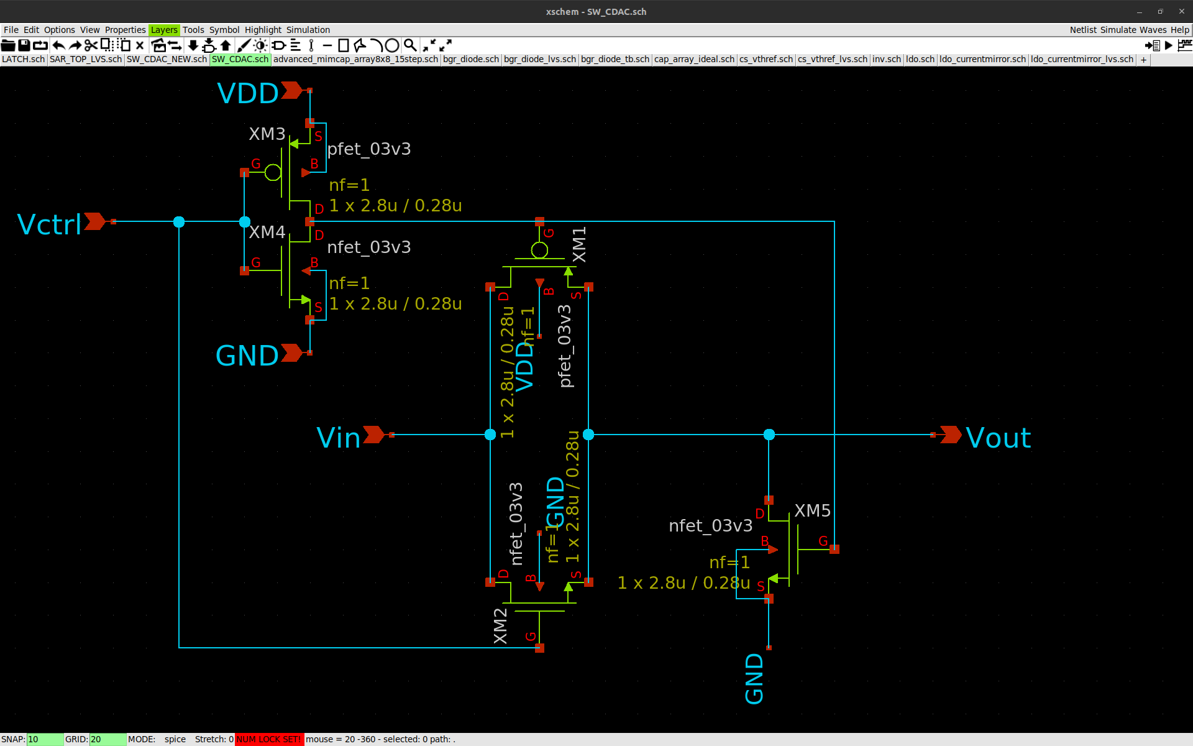
submit_version/images/SAR_CDAC.png
