ishi-kai/Chipathon2023_ADC/submit_version/images/tran_sar_adc__pex.png

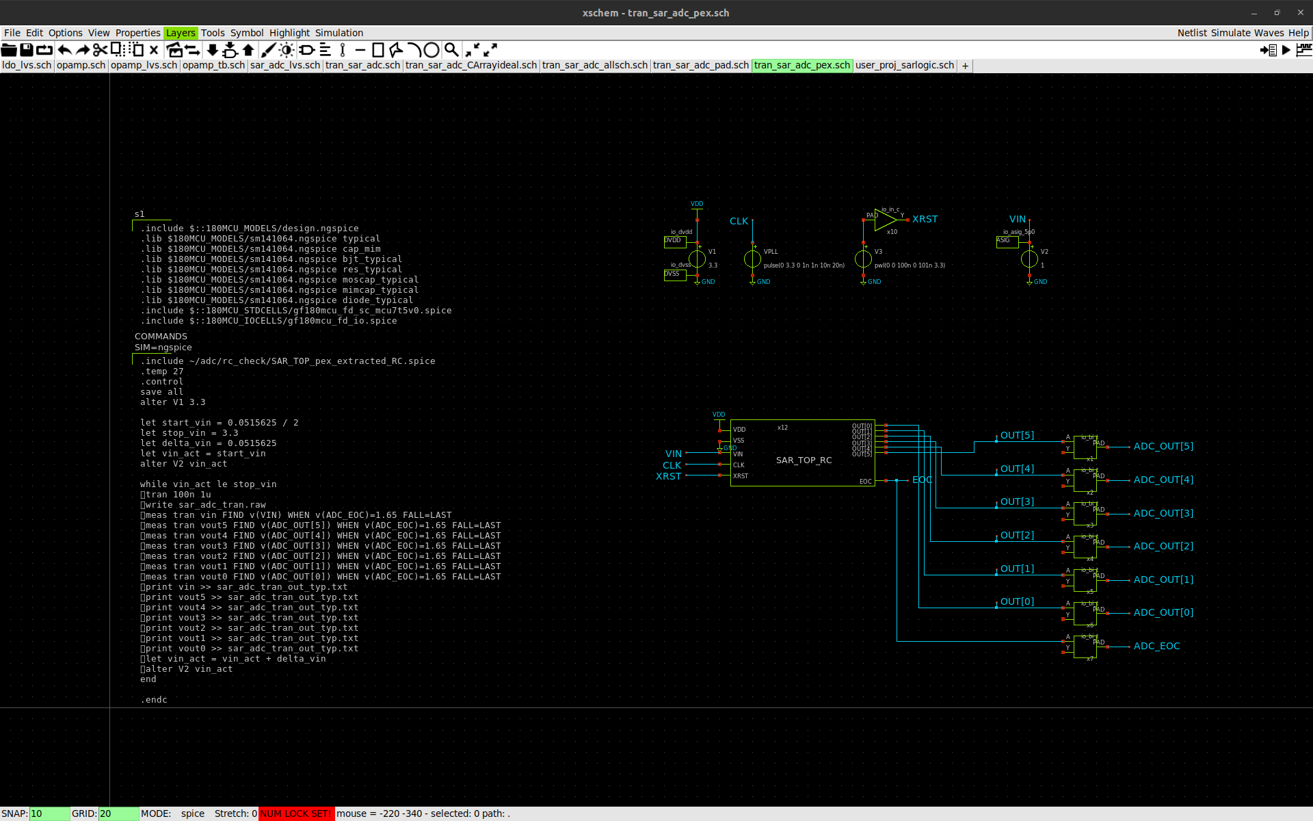
submit_version/images/tran_sar_adc__pex.png
