ishi-kai/Chipathon2023_ADC/submit_version/images/tran_sar_adc_CArrayideal.png

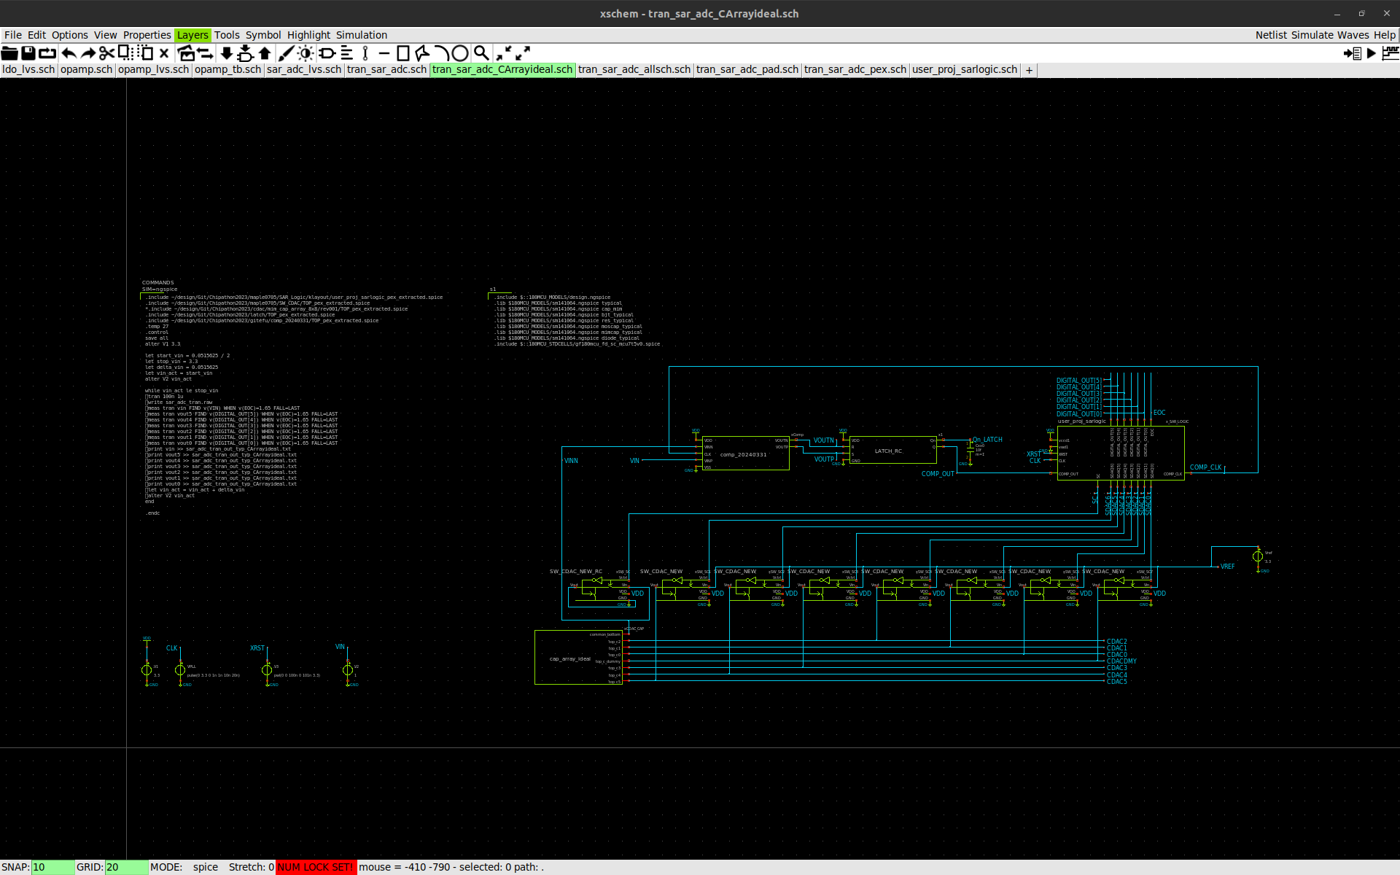
submit_version/images/tran_sar_adc_CArrayideal.png
