ishi-kai/Chipathon2023_ADC/submit_version/images/tran_sar_adc_lvs_pad.png

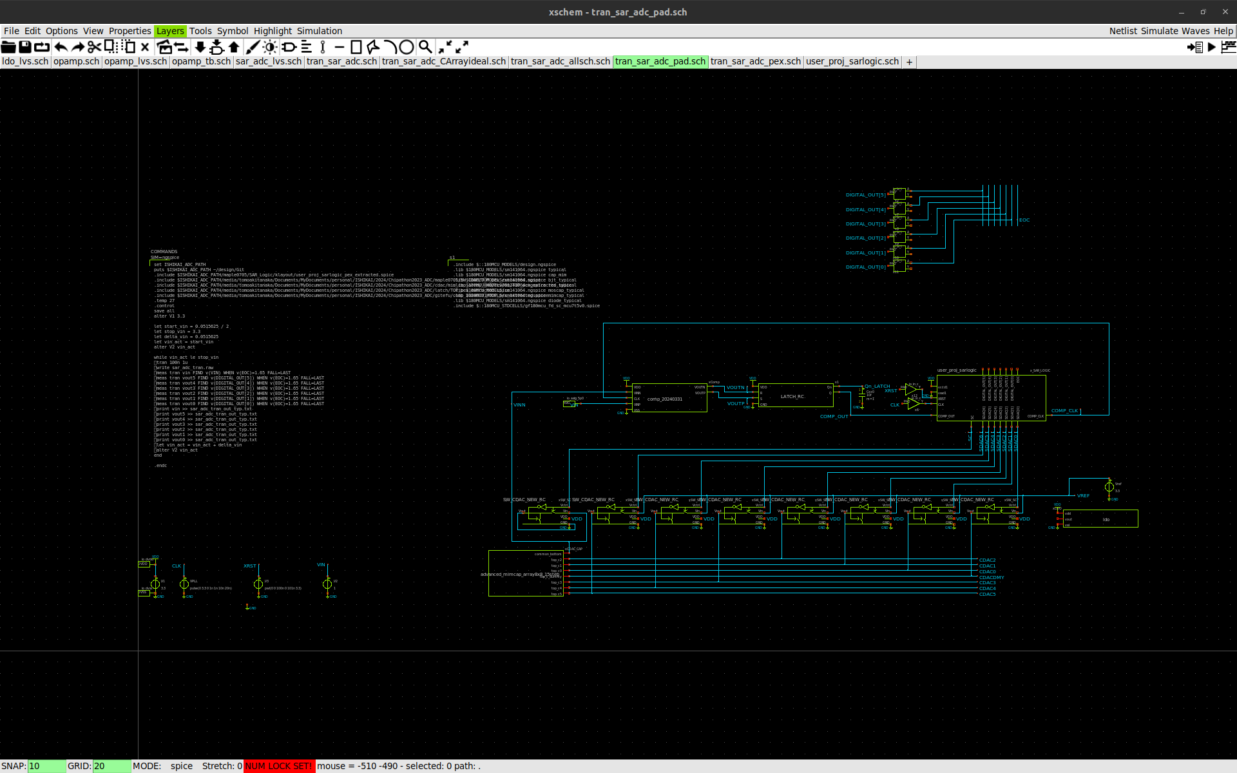
submit_version/images/tran_sar_adc_lvs_pad.png
