ishi-kai/Chipathon2023_ADC/submit_version/images/user_proj_sarlogic.png

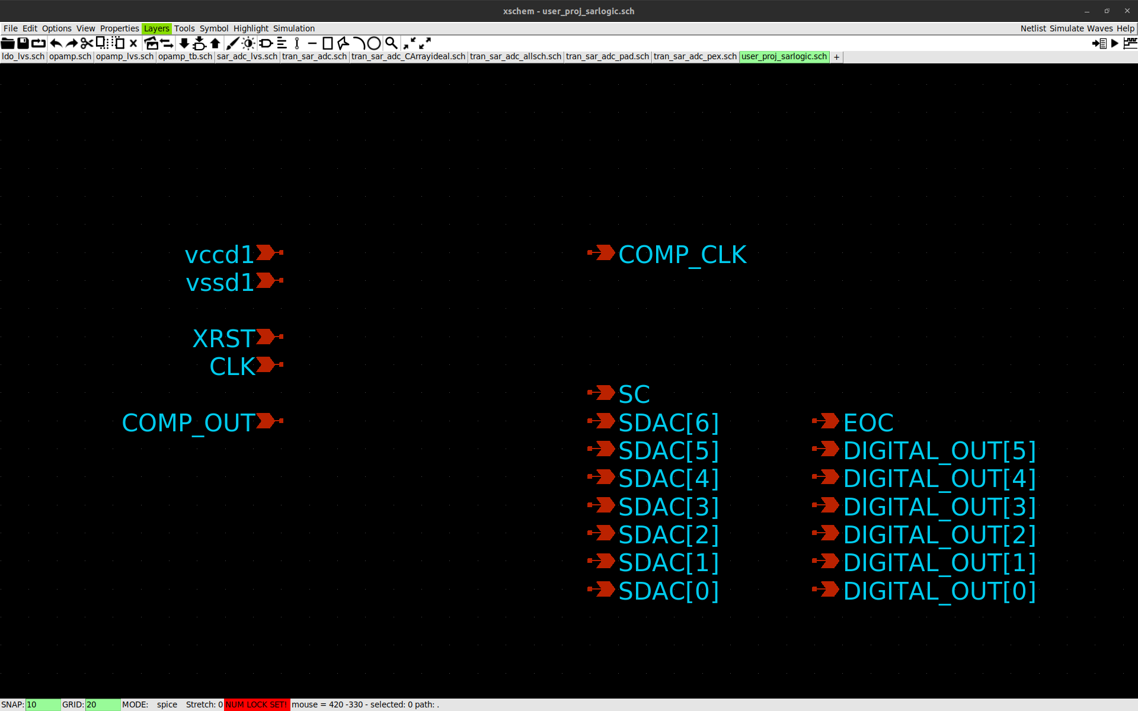
submit_version/images/user_proj_sarlogic.png
