ishi-kai/Chipathon2023_ADC/maple0705/SAR_Logic/RTL/howtosim.txt

$ iverilog SAR_LOGIC_tb.v SAR_LOGIC.v
$ vvp a.out
$ gtkwave wave_SAR_Logic.vcd
