ishi-kai/Chipathon2023_ADC/submit_version/xschem/sim_result/sar_adc_tran_out_typ_woLDO_eachBlockExtracted_20240415.csv

vin | vout5 | vout4 | vout3 | vout2 | vout1 | vout0
2.578125e-02 | 2.332541e-08 | 1.750744e-08 | 1.910650e-08 | 1.910655e-08 | 2.380191e-08 | 2.327092e-08
7.734375e-02 | 2.332536e-08 | 1.750741e-08 | 1.910647e-08 | 1.910652e-08 | 2.380186e-08 | 2.327088e-08
1.289062e-01 | 2.332549e-08 | 1.750748e-08 | 1.910655e-08 | 1.910660e-08 | 2.380200e-08 | 2.327101e-08
1.804687e-01 | 2.332546e-08 | 1.750748e-08 | 1.910655e-08 | 1.910660e-08 | 2.380195e-08 | 2.327097e-08
2.320312e-01 | 2.332548e-08 | 1.750753e-08 | 1.910659e-08 | 1.910664e-08 | 2.380195e-08 | 2.327099e-08
2.835937e-01 | 2.332499e-08 | 1.750721e-08 | 1.910622e-08 | 1.910627e-08 | 2.380146e-08 | 2.327050e-08
3.351562e-01 | 2.332050e-08 | 1.750430e-08 | 1.910281e-08 | 1.910286e-08 | 2.379697e-08 | 2.326596e-08
3.867187e-01 | 2.329691e-08 | 1.748934e-08 | 1.908523e-08 | 1.908528e-08 | 2.377320e-08 | 2.324216e-08
4.382812e-01 | 2.322221e-08 | 1.744237e-08 | 1.902987e-08 | 1.902992e-08 | 2.369771e-08 | 2.316674e-08
4.898437e-01 | 2.317370e-08 | 1.741156e-08 | 1.899367e-08 | 1.899372e-08 | 2.364882e-08 | 2.311777e-08
5.414062e-01 | 2.316199e-08 | 1.740934e-08 | 1.898981e-08 | 3.300000e+00 | 3.300000e+00 | 3.300000e+00
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
