ishi-kai/Chipathon2023_ADC/cdac/mim_cap_array_8x8/figures/measurement_summary.png

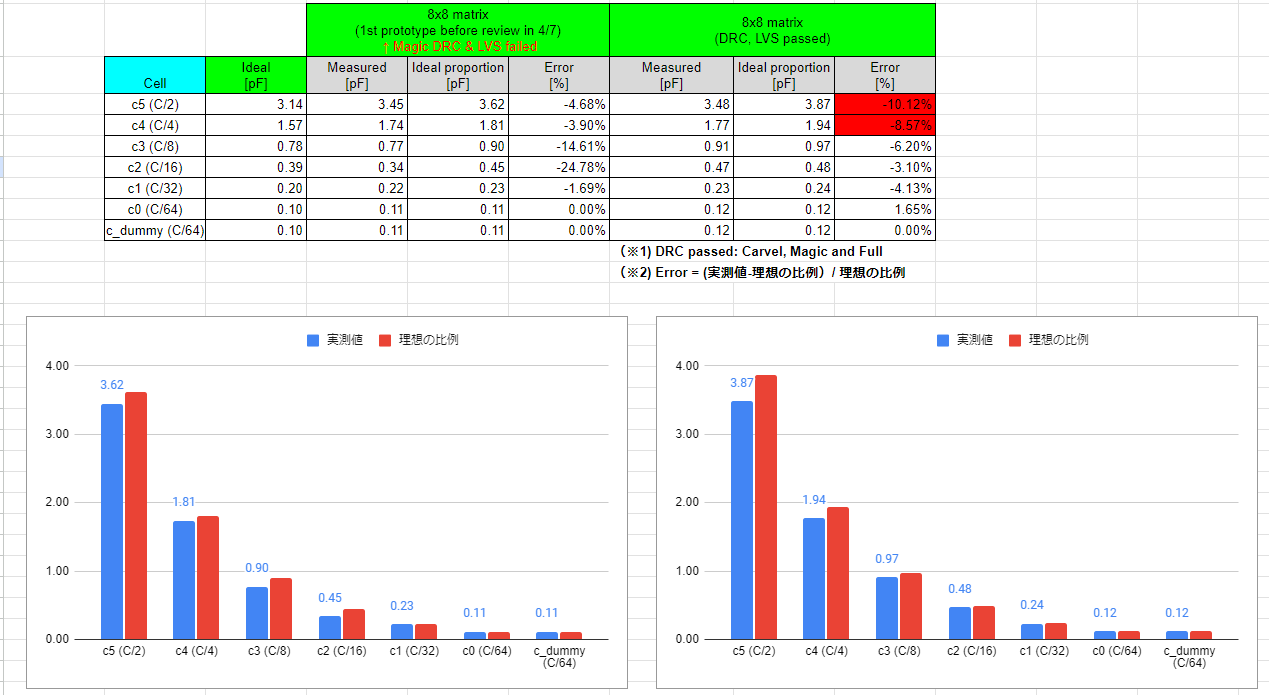
cdac/mim_cap_array_8x8/figures/measurement_summary.png
