ishi-kai/Chipathon2023_ADC/submit_version/xschem/sim_result/vin_vout_result.png

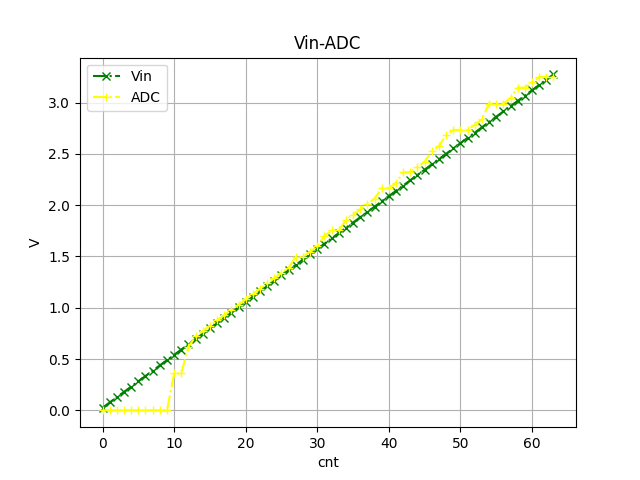
submit_version/xschem/sim_result/vin_vout_result.png
