ishi-kai/Chipathon2023_ADC/latch/TOP_pex_extracted.spice

* NGSPICE file created from TOP.ext - technology: gf180mcuD

.subckt TOP VDD S R Q Qn GND
X0 GND.t56 Q.t30 Qn.t9 GND.t0 nfet_03v3 ad=0.728p pd=3.32u as=0.728p ps=3.32u w=2.8u l=0.28u
X1 GND.t33 S.t0 Qn.t6 GND.t32 nfet_03v3 ad=0.728p pd=3.32u as=0.728p ps=3.32u w=2.8u l=0.28u
X2 Qn.t15 Q.t31 GND.t55 GND.t30 nfet_03v3 ad=0.728p pd=3.32u as=0.728p ps=3.32u w=2.8u l=0.28u
X3 Q.t5 Qn.t30 VDD.t19 VDD.t18 pfet_03v3 ad=0.728p pd=3.32u as=1.82p ps=6.9u w=2.8u l=0.28u
X4 VDD.t17 Qn.t31 Q.t9 VDD.t16 pfet_03v3 ad=0.728p pd=3.32u as=0.728p ps=3.32u w=2.8u l=0.28u
X5 GND.t54 Q.t32 Qn.t14 GND.t4 nfet_03v3 ad=0.728p pd=3.32u as=0.728p ps=3.32u w=2.8u l=0.28u
X6 GND.t42 R.t0 Q.t22 GND.t24 nfet_03v3 ad=0.728p pd=3.32u as=0.728p ps=3.32u w=2.8u l=0.28u
X7 Q.t19 R.t1 GND.t39 GND.t20 nfet_03v3 ad=0.728p pd=3.32u as=0.728p ps=3.32u w=2.8u l=0.28u
X8 VDD.t39 Q.t33 Qn.t27 VDD.t38 pfet_03v3 ad=0.728p pd=3.32u as=0.728p ps=3.32u w=2.8u l=0.28u
X9 Q.t0 Qn.t32 VDD.t15 VDD.t14 pfet_03v3 ad=0.728p pd=3.32u as=0.728p ps=3.32u w=2.8u l=0.28u
X10 VDD.t13 Qn.t33 Q.t3 VDD.t12 pfet_03v3 ad=1.82p pd=6.9u as=0.728p ps=3.32u w=2.8u l=0.28u
X11 Qn.t29 S.t1 GND.t59 GND.t49 nfet_03v3 ad=0.728p pd=3.32u as=0.728p ps=3.32u w=2.8u l=0.28u
X12 GND.t25 Qn.t34 Q.t10 GND.t24 nfet_03v3 ad=0.728p pd=3.32u as=0.728p ps=3.32u w=2.8u l=0.28u
X13 GND.t29 S.t2 Qn.t4 GND.t28 nfet_03v3 ad=1.708p pd=6.82u as=0.728p ps=3.32u w=2.8u l=0.28u
X14 GND.t1 S.t3 Qn.t0 GND.t0 nfet_03v3 ad=0.728p pd=3.32u as=0.728p ps=3.32u w=2.8u l=0.28u
X15 Q.t26 Qn.t35 GND.t23 GND.t22 nfet_03v3 ad=0.728p pd=3.32u as=1.708p ps=6.82u w=2.8u l=0.28u
X16 Qn.t8 S.t4 GND.t45 GND.t44 nfet_03v3 ad=0.728p pd=3.32u as=0.728p ps=3.32u w=2.8u l=0.28u
X17 Qn.t5 S.t5 GND.t31 GND.t30 nfet_03v3 ad=0.728p pd=3.32u as=0.728p ps=3.32u w=2.8u l=0.28u
X18 Qn.t25 Q.t34 VDD.t37 VDD.t36 pfet_03v3 ad=0.728p pd=3.32u as=1.82p ps=6.9u w=2.8u l=0.28u
X19 VDD.t11 Qn.t36 Q.t2 VDD.t10 pfet_03v3 ad=0.728p pd=3.32u as=0.728p ps=3.32u w=2.8u l=0.28u
X20 Q.t24 Qn.t37 GND.t21 GND.t20 nfet_03v3 ad=0.728p pd=3.32u as=0.728p ps=3.32u w=2.8u l=0.28u
X21 Qn.t21 Q.t35 VDD.t35 VDD.t34 pfet_03v3 ad=0.728p pd=3.32u as=0.728p ps=3.32u w=2.8u l=0.28u
X22 VDD.t33 Q.t36 Qn.t23 VDD.t32 pfet_03v3 ad=0.728p pd=3.32u as=0.728p ps=3.32u w=2.8u l=0.28u
X23 GND.t19 Qn.t38 Q.t7 GND.t18 nfet_03v3 ad=0.728p pd=3.32u as=0.728p ps=3.32u w=2.8u l=0.28u
X24 Q.t29 R.t2 GND.t58 GND.t16 nfet_03v3 ad=0.728p pd=3.32u as=0.728p ps=3.32u w=2.8u l=0.28u
X25 Qn.t20 Q.t37 GND.t53 GND.t44 nfet_03v3 ad=0.728p pd=3.32u as=0.728p ps=3.32u w=2.8u l=0.28u
X26 GND.t35 R.t3 Q.t14 GND.t12 nfet_03v3 ad=0.728p pd=3.32u as=0.728p ps=3.32u w=2.8u l=0.28u
X27 GND.t34 R.t4 Q.t13 GND.t10 nfet_03v3 ad=0.728p pd=3.32u as=0.728p ps=3.32u w=2.8u l=0.28u
X28 VDD.t9 Qn.t39 Q.t27 VDD.t8 pfet_03v3 ad=0.728p pd=3.32u as=0.728p ps=3.32u w=2.8u l=0.28u
X29 Q.t23 R.t5 GND.t43 GND.t6 nfet_03v3 ad=0.728p pd=3.32u as=0.728p ps=3.32u w=2.8u l=0.28u
X30 Q.t17 Qn.t40 VDD.t7 VDD.t6 pfet_03v3 ad=0.728p pd=3.32u as=0.728p ps=3.32u w=2.8u l=0.28u
X31 GND.t52 Q.t38 Qn.t12 GND.t2 nfet_03v3 ad=0.728p pd=3.32u as=0.728p ps=3.32u w=2.8u l=0.28u
X32 VDD.t31 Q.t39 Qn.t28 VDD.t30 pfet_03v3 ad=0.728p pd=3.32u as=0.728p ps=3.32u w=2.8u l=0.28u
X33 Qn.t13 Q.t40 GND.t51 GND.t36 nfet_03v3 ad=0.728p pd=3.32u as=0.728p ps=3.32u w=2.8u l=0.28u
X34 Qn.t17 Q.t41 GND.t50 GND.t49 nfet_03v3 ad=0.728p pd=3.32u as=0.728p ps=3.32u w=2.8u l=0.28u
X35 GND.t3 S.t6 Qn.t1 GND.t2 nfet_03v3 ad=0.728p pd=3.32u as=0.728p ps=3.32u w=2.8u l=0.28u
X36 GND.t48 Q.t42 Qn.t16 GND.t28 nfet_03v3 ad=1.708p pd=6.82u as=0.728p ps=3.32u w=2.8u l=0.28u
X37 Qn.t7 S.t7 GND.t37 GND.t36 nfet_03v3 ad=0.728p pd=3.32u as=0.728p ps=3.32u w=2.8u l=0.28u
X38 Q.t16 Qn.t41 VDD.t5 VDD.t4 pfet_03v3 ad=0.728p pd=3.32u as=0.728p ps=3.32u w=2.8u l=0.28u
X39 Qn.t26 Q.t43 VDD.t29 VDD.t28 pfet_03v3 ad=0.728p pd=3.32u as=0.728p ps=3.32u w=2.8u l=0.28u
X40 Q.t1 Qn.t42 GND.t17 GND.t16 nfet_03v3 ad=0.728p pd=3.32u as=0.728p ps=3.32u w=2.8u l=0.28u
X41 Q.t11 Qn.t43 GND.t15 GND.t14 nfet_03v3 ad=0.728p pd=3.32u as=0.728p ps=3.32u w=2.8u l=0.28u
X42 Q.t21 R.t6 GND.t41 GND.t22 nfet_03v3 ad=0.728p pd=3.32u as=1.708p ps=6.82u w=2.8u l=0.28u
X43 VDD.t3 Qn.t44 Q.t15 VDD.t2 pfet_03v3 ad=0.728p pd=3.32u as=0.728p ps=3.32u w=2.8u l=0.28u
X44 Q.t6 Qn.t45 VDD.t1 VDD.t0 pfet_03v3 ad=0.728p pd=3.32u as=0.728p ps=3.32u w=2.8u l=0.28u
X45 GND.t38 R.t7 Q.t18 GND.t18 nfet_03v3 ad=0.728p pd=3.32u as=0.728p ps=3.32u w=2.8u l=0.28u
X46 Qn.t22 Q.t44 VDD.t27 VDD.t26 pfet_03v3 ad=0.728p pd=3.32u as=0.728p ps=3.32u w=2.8u l=0.28u
X47 VDD.t25 Q.t45 Qn.t24 VDD.t24 pfet_03v3 ad=1.82p pd=6.9u as=0.728p ps=3.32u w=2.8u l=0.28u
X48 GND.t13 Qn.t46 Q.t4 GND.t12 nfet_03v3 ad=0.728p pd=3.32u as=0.728p ps=3.32u w=2.8u l=0.28u
X49 Q.t28 R.t8 GND.t57 GND.t14 nfet_03v3 ad=0.728p pd=3.32u as=0.728p ps=3.32u w=2.8u l=0.28u
X50 GND.t11 Qn.t47 Q.t8 GND.t10 nfet_03v3 ad=0.728p pd=3.32u as=0.728p ps=3.32u w=2.8u l=0.28u
X51 GND.t9 Qn.t48 Q.t12 GND.t8 nfet_03v3 ad=1.708p pd=6.82u as=0.728p ps=3.32u w=2.8u l=0.28u
X52 GND.t40 R.t9 Q.t20 GND.t8 nfet_03v3 ad=1.708p pd=6.82u as=0.728p ps=3.32u w=2.8u l=0.28u
X53 Q.t25 Qn.t49 GND.t7 GND.t6 nfet_03v3 ad=0.728p pd=3.32u as=0.728p ps=3.32u w=2.8u l=0.28u
X54 Qn.t19 Q.t46 GND.t47 GND.t26 nfet_03v3 ad=0.728p pd=3.32u as=1.708p ps=6.82u w=2.8u l=0.28u
X55 GND.t5 S.t8 Qn.t2 GND.t4 nfet_03v3 ad=0.728p pd=3.32u as=0.728p ps=3.32u w=2.8u l=0.28u
X56 Qn.t18 Q.t47 VDD.t23 VDD.t22 pfet_03v3 ad=0.728p pd=3.32u as=0.728p ps=3.32u w=2.8u l=0.28u
X57 GND.t46 Q.t48 Qn.t11 GND.t32 nfet_03v3 ad=0.728p pd=3.32u as=0.728p ps=3.32u w=2.8u l=0.28u
X58 VDD.t21 Q.t49 Qn.t10 VDD.t20 pfet_03v3 ad=0.728p pd=3.32u as=0.728p ps=3.32u w=2.8u l=0.28u
X59 Qn.t3 S.t9 GND.t27 GND.t26 nfet_03v3 ad=0.728p pd=3.32u as=1.708p ps=6.82u w=2.8u l=0.28u
R0 Q.n0 Q.t45 55.9719
R1 Q.n1 Q.t34 55.9719
R2 Q.n2 Q.t33 55.9719
R3 Q.n3 Q.t43 55.9719
R4 Q.n4 Q.t39 55.9719
R5 Q.n5 Q.t35 55.9719
R6 Q.n6 Q.t49 55.9719
R7 Q.n7 Q.t44 55.9719
R8 Q.n8 Q.t36 55.9719
R9 Q.n9 Q.t47 55.9719
R10 Q.n1 Q.t46 55.9719
R11 Q.n2 Q.t48 55.9719
R12 Q.n3 Q.t37 55.9719
R13 Q.n4 Q.t30 55.9719
R14 Q.n5 Q.t31 55.9719
R15 Q.n6 Q.t38 55.9719
R16 Q.n7 Q.t40 55.9719
R17 Q.n8 Q.t32 55.9719
R18 Q.n9 Q.t41 55.9719
R19 Q.n0 Q.t42 55.9719
R20 Q.n35 Q.n21 7.35813
R21 Q.n33 Q.n22 7.35813
R22 Q.n31 Q.n23 7.35813
R23 Q.n29 Q.n24 7.35813
R24 Q.n27 Q.n25 7.35813
R25 Q.n13 Q.n11 5.94579
R26 Q.n35 Q.n34 5.90992
R27 Q.n33 Q.n32 5.90992
R28 Q.n31 Q.n30 5.90992
R29 Q.n29 Q.n28 5.90992
R30 Q.n27 Q.n26 5.90992
R31 Q.n20 Q.n10 5.71583
R32 Q.n19 Q.n18 5.69092
R33 Q.n17 Q.n16 5.69092
R34 Q.n15 Q.n14 5.69092
R35 Q.n13 Q.n12 5.69092
R36 Q.n18 Q.t27 0.6505
R37 Q.n18 Q.t5 0.6505
R38 Q.n16 Q.t9 0.6505
R39 Q.n16 Q.t16 0.6505
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
R86 Qn.n9 Qn.t30 55.9719
R87 Qn.n8 Qn.t39 55.9719
R88 Qn.n7 Qn.t41 55.9719
R89 Qn.n6 Qn.t31 55.9719
R90 Qn.n5 Qn.t40 55.9719
R91 Qn.n4 Qn.t44 55.9719
R92 Qn.n3 Qn.t32 55.9719
R93 Qn.n2 Qn.t36 55.9719
R94 Qn.n1 Qn.t45 55.9719
R95 Qn.n0 Qn.t33 55.9719
R96 Qn.n9 Qn.t35 55.9719
R97 Qn.n8 Qn.t46 55.9719
R98 Qn.n7 Qn.t42 55.9719
R99 Qn.n6 Qn.t34 55.9719
R100 Qn.n5 Qn.t43 55.9719
R101 Qn.n4 Qn.t38 55.9719
R102 Qn.n3 Qn.t49 55.9719
R103 Qn.n2 Qn.t47 55.9719
R104 Qn.n1 Qn.t37 55.9719
R105 Qn.n0 Qn.t48 55.9719
R106 Qn.n27 Qn.n25 9.42441
R107 Qn.n29 Qn.n24 9.42441
R108 Qn.n31 Qn.n23 9.42441
R109 Qn.n33 Qn.n22 9.42441
R110 Qn.n35 Qn.n21 9.42441
R111 Qn.n27 Qn.n26 8.15873
R112 Qn.n29 Qn.n28 8.15873
R113 Qn.n31 Qn.n30 8.15873
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
C235 Q.t11 GND 0.034838f
C236 Q.n30 GND 0.155972f
C237 Q.n31 GND 0.353538f
C238 Q.t10 GND 0.034838f
C239 Q.t1 GND 0.034838f
C240 Q.n32 GND 0.155972f
C241 Q.n33 GND 0.353538f
C242 Q.t4 GND 0.034838f
C243 Q.t26 GND 0.034838f
C244 Q.n34 GND 0.155972f
C245 Q.n35 GND 0.380023f
.ends
