ishi-kai/Chipathon2023_ADC/maple0705/SW_CDAC/TOP_pex_extracted.spice

* NGSPICE file created from TOP.ext - technology: gf180mcuD

.subckt TOP VDD Vctrl GND Vin Vout
X0 Vout.t18 a_n2515_0.t10 Vin.t5 VDD.t21 pfet_03v3 ad=0.728p pd=3.32u as=0.728p ps=3.32u w=2.8u l=0.28u
X1 a_n2515_0.t4 Vctrl.t0 GND.t29 GND.t28 nfet_03v3 ad=0.728p pd=3.32u as=0.728p ps=3.32u w=2.8u l=0.28u
X2 a_n2515_0.t5 Vctrl.t1 GND.t27 GND.t26 nfet_03v3 ad=0.728p pd=3.32u as=0.728p ps=3.32u w=2.8u l=0.28u
X3 VDD.t3 Vctrl.t2 a_n2515_0.t1 VDD.t2 pfet_03v3 ad=0.728p pd=3.32u as=0.728p ps=3.32u w=2.8u l=0.28u
X4 Vin.t8 a_n2515_0.t11 Vout.t17 VDD.t20 pfet_03v3 ad=0.728p pd=3.32u as=0.728p ps=3.32u w=2.8u l=0.28u
X5 Vin.t11 a_n2515_0.t12 Vout.t16 VDD.t19 pfet_03v3 ad=1.82p pd=6.9u as=0.728p ps=3.32u w=2.8u l=0.28u
X6 GND.t25 Vctrl.t3 a_n2515_0.t5 GND.t24 nfet_03v3 ad=1.708p pd=6.82u as=0.728p ps=3.32u w=2.8u l=0.28u
X7 Vout.t6 a_n2515_0.t13 GND.t49 GND.t48 nfet_03v3 ad=0.728p pd=3.32u as=0.728p ps=3.32u w=2.8u l=0.28u
X8 Vout.t19 a_n2515_0.t14 GND.t47 GND.t46 nfet_03v3 ad=0.728p pd=3.32u as=0.728p ps=3.32u w=2.8u l=0.28u
X9 Vout.t15 a_n2515_0.t15 Vin.t3 VDD.t18 pfet_03v3 ad=0.728p pd=3.32u as=0.728p ps=3.32u w=2.8u l=0.28u
X10 GND.t45 a_n2515_0.t16 Vout.t22 GND.t44 nfet_03v3 ad=0.728p pd=3.32u as=0.728p ps=3.32u w=2.8u l=0.28u
X11 VDD.t5 Vctrl.t4 a_n2515_0.t3 VDD.t4 pfet_03v3 ad=0.728p pd=3.32u as=0.728p ps=3.32u w=2.8u l=0.28u
X12 Vout.t21 a_n2515_0.t17 GND.t43 GND.t42 nfet_03v3 ad=0.728p pd=3.32u as=0.728p ps=3.32u w=2.8u l=0.28u
X13 a_n2515_0.t1 Vctrl.t5 VDD.t7 VDD.t6 pfet_03v3 ad=0.728p pd=3.32u as=1.82p ps=6.9u w=2.8u l=0.28u
X14 a_n2515_0.t0 Vctrl.t6 VDD.t9 VDD.t8 pfet_03v3 ad=0.728p pd=3.32u as=0.728p ps=3.32u w=2.8u l=0.28u
X15 VDD.t23 Vctrl.t7 a_n2515_0.t8 VDD.t22 pfet_03v3 ad=0.728p pd=3.32u as=0.728p ps=3.32u w=2.8u l=0.28u
X16 Vout.t14 a_n2515_0.t18 Vin.t6 VDD.t17 pfet_03v3 ad=0.728p pd=3.32u as=1.82p ps=6.9u w=2.8u l=0.28u
X17 Vout.t13 a_n2515_0.t19 Vin.t7 VDD.t16 pfet_03v3 ad=0.728p pd=3.32u as=0.728p ps=3.32u w=2.8u l=0.28u
X18 Vin.t9 a_n2515_0.t20 Vout.t12 VDD.t15 pfet_03v3 ad=0.728p pd=3.32u as=0.728p ps=3.32u w=2.8u l=0.28u
X19 Vout.t29 Vctrl.t8 Vin.t19 GND.t23 nfet_03v3 ad=0.728p pd=3.32u as=0.728p ps=3.32u w=2.8u l=0.28u
X20 a_n2515_0.t9 Vctrl.t9 GND.t22 GND.t21 nfet_03v3 ad=0.728p pd=3.32u as=1.708p ps=6.82u w=2.8u l=0.28u
X21 Vin.t16 Vctrl.t10 Vout.t26 GND.t20 nfet_03v3 ad=0.728p pd=3.32u as=0.728p ps=3.32u w=2.8u l=0.28u
X22 Vin.t15 Vctrl.t11 Vout.t25 GND.t19 nfet_03v3 ad=0.728p pd=3.32u as=0.728p ps=3.32u w=2.8u l=0.28u
X23 GND.t18 Vctrl.t12 a_n2515_0.t9 GND.t17 nfet_03v3 ad=0.728p pd=3.32u as=0.728p ps=3.32u w=2.8u l=0.28u
X24 GND.t16 Vctrl.t13 a_n2515_0.t6 GND.t15 nfet_03v3 ad=0.728p pd=3.32u as=0.728p ps=3.32u w=2.8u l=0.28u
X25 Vin.t14 Vctrl.t14 Vout.t24 GND.t14 nfet_03v3 ad=1.708p pd=6.82u as=0.728p ps=3.32u w=2.8u l=0.28u
X26 a_n2515_0.t2 Vctrl.t15 GND.t13 GND.t12 nfet_03v3 ad=0.728p pd=3.32u as=0.728p ps=3.32u w=2.8u l=0.28u
X27 Vout.t27 Vctrl.t16 Vin.t17 GND.t11 nfet_03v3 ad=0.728p pd=3.32u as=0.728p ps=3.32u w=2.8u l=0.28u
X28 GND.t10 Vctrl.t17 a_n2515_0.t4 GND.t9 nfet_03v3 ad=0.728p pd=3.32u as=0.728p ps=3.32u w=2.8u l=0.28u
X29 GND.t41 a_n2515_0.t21 Vout.t3 GND.t40 nfet_03v3 ad=0.728p pd=3.32u as=0.728p ps=3.32u w=2.8u l=0.28u
X30 Vout.t7 a_n2515_0.t22 GND.t39 GND.t38 nfet_03v3 ad=0.728p pd=3.32u as=0.728p ps=3.32u w=2.8u l=0.28u
X31 a_n2515_0.t3 Vctrl.t18 VDD.t27 VDD.t26 pfet_03v3 ad=0.728p pd=3.32u as=0.728p ps=3.32u w=2.8u l=0.28u
X32 GND.t37 a_n2515_0.t23 Vout.t4 GND.t36 nfet_03v3 ad=0.728p pd=3.32u as=0.728p ps=3.32u w=2.8u l=0.28u
X33 Vin.t10 a_n2515_0.t24 Vout.t11 VDD.t14 pfet_03v3 ad=0.728p pd=3.32u as=0.728p ps=3.32u w=2.8u l=0.28u
X34 a_n2515_0.t8 Vctrl.t19 VDD.t25 VDD.t24 pfet_03v3 ad=0.728p pd=3.32u as=0.728p ps=3.32u w=2.8u l=0.28u
X35 VDD.t29 Vctrl.t20 a_n2515_0.t7 VDD.t28 pfet_03v3 ad=1.82p pd=6.9u as=0.728p ps=3.32u w=2.8u l=0.28u
X36 GND.t35 a_n2515_0.t25 Vout.t8 GND.t34 nfet_03v3 ad=0.728p pd=3.32u as=0.728p ps=3.32u w=2.8u l=0.28u
X37 Vout.t10 a_n2515_0.t26 Vin.t12 VDD.t13 pfet_03v3 ad=0.728p pd=3.32u as=0.728p ps=3.32u w=2.8u l=0.28u
X38 Vout.t20 a_n2515_0.t27 GND.t33 GND.t32 nfet_03v3 ad=0.728p pd=3.32u as=1.708p ps=6.82u w=2.8u l=0.28u
X39 Vin.t4 a_n2515_0.t28 Vout.t9 VDD.t12 pfet_03v3 ad=0.728p pd=3.32u as=0.728p ps=3.32u w=2.8u l=0.28u
X40 Vout.t23 Vctrl.t21 Vin.t13 GND.t8 nfet_03v3 ad=0.728p pd=3.32u as=0.728p ps=3.32u w=2.8u l=0.28u
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
C216 a_n2515_0.t29 GND 0.060988f
C217 a_n2515_0.t14 GND 0.06089f
C218 a_n2515_0.t21 GND 0.06089f
C219 a_n2515_0.t13 GND 0.06089f
C220 a_n2515_0.t16 GND 0.06089f
C221 a_n2515_0.t22 GND 0.06089f
C222 a_n2515_0.t23 GND 0.06089f
C223 a_n2515_0.t17 GND 0.06089f
C224 a_n2515_0.t25 GND 0.06089f
C225 a_n2515_0.t27 GND 0.06089f
C226 a_n2515_0.t15 GND 0.061123f
C227 a_n2515_0.t26 GND 0.061123f
C228 a_n2515_0.t10 GND 0.061123f
C229 a_n2515_0.t19 GND 0.061123f
C230 a_n2515_0.t18 GND 0.061244f
C231 a_n2515_0.t24 GND 0.061123f
C232 a_n2515_0.t11 GND 0.061123f
.ends
