ishi-kai/Chipathon2023_ADC/cdac/mim_cap_array_8x8/rev001/TOP_pex_extracted.spice

* NGSPICE file created from TOP.ext - technology: gf180mcuD

.subckt TOP top_c0 top_c1 top_c5 top_c3 top_c2 top_c4 top_c_dummy common_bottom
X0 top_c5.t0 common_bottom.t62 cap_mim_2f0_m4m5_noshield c_width=7u c_length=7u
X1 top_c3.t0 common_bottom.t7 cap_mim_2f0_m4m5_noshield c_width=7u c_length=7u
X2 top_c5.t1 common_bottom.t61 cap_mim_2f0_m4m5_noshield c_width=7u c_length=7u
X3 top_c3.t1 common_bottom.t10 cap_mim_2f0_m4m5_noshield c_width=7u c_length=7u
X4 top_c4.t0 common_bottom.t27 cap_mim_2f0_m4m5_noshield c_width=7u c_length=7u
X5 top_c5.t2 common_bottom.t60 cap_mim_2f0_m4m5_noshield c_width=7u c_length=7u
X6 top_c5.t3 common_bottom.t59 cap_mim_2f0_m4m5_noshield c_width=7u c_length=7u
X7 top_c5.t4 common_bottom.t58 cap_mim_2f0_m4m5_noshield c_width=7u c_length=7u
X8 top_c5.t5 common_bottom.t57 cap_mim_2f0_m4m5_noshield c_width=7u c_length=7u
X9 top_c1.t0 common_bottom.t11 cap_mim_2f0_m4m5_noshield c_width=7u c_length=7u
X10 top_c5.t6 common_bottom.t56 cap_mim_2f0_m4m5_noshield c_width=7u c_length=7u
X11 top_c3.t2 common_bottom.t19 cap_mim_2f0_m4m5_noshield c_width=7u c_length=7u
X12 top_c5.t7 common_bottom.t55 cap_mim_2f0_m4m5_noshield c_width=7u c_length=7u
X13 top_c3.t3 common_bottom.t1 cap_mim_2f0_m4m5_noshield c_width=7u c_length=7u
X14 top_c5.t8 common_bottom.t54 cap_mim_2f0_m4m5_noshield c_width=7u c_length=7u
X15 top_c5.t9 common_bottom.t53 cap_mim_2f0_m4m5_noshield c_width=7u c_length=7u
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
R645 top_c4.n22 top_c4.n21 1.28714
R646 top_c4.n16 top_c4.n7 1.28714
R647 top_c4.n39 top_c4.n4 1.28489
R648 top_c4.n78 top_c4.n66 1.28063
R649 top_c4.n102 top_c4.n101 1.28063
R650 top_c4.n96 top_c4.n95 1.28063
R651 top_c4.n90 top_c4.n59 1.28063
R652 top_c4 top_c4.n115 0.810684
R653 top_c4.n70 top_c4.t14 0.586765
R654 top_c4.n51 top_c4.t9 0.586765
R655 top_c4.n72 top_c4.n71 0.5405
R656 top_c4.n53 top_c4.n52 0.5405
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
