ishi-kai/Chipathon2023_ADC/review/0407/cdac/mim_cap_array_8x8/TOP_pex_extracted.spice

* NGSPICE file created from TOP.ext - technology: gf180mcuD

.subckt cap_mim m4_n120_n120 m4_0_0 VSUBS
X0 m4_0_0 m4_n120_n120 cap_mim_2f0_m4m5_noshield c_width=7u c_length=7u
C0 m4_0_0 m4_n120_n120 0.414359f
C1 m4_0_0 VSUBS 1.18568f
C2 m4_n120_n120 VSUBS 1.06208f
.ends

.subckt TOP common_bottom top_c2 top_c3 top_c4 top_c5 top_c_dummy top_c1 top_c0
Xcap_mim_0[0|0] common_bottom top_c5 VSUBS cap_mim
Xcap_mim_0[1|0] common_bottom top_c5 VSUBS cap_mim
Xcap_mim_0[2|0] common_bottom top_c5 VSUBS cap_mim
Xcap_mim_0[3|0] common_bottom top_c4 VSUBS cap_mim
Xcap_mim_0[4|0] common_bottom top_c5 VSUBS cap_mim
Xcap_mim_0[5|0] common_bottom top_c4 VSUBS cap_mim
Xcap_mim_0[6|0] common_bottom top_c4 VSUBS cap_mim
Xcap_mim_0[7|0] common_bottom top_c4 VSUBS cap_mim
Xcap_mim_0[0|1] common_bottom top_c5 VSUBS cap_mim
Xcap_mim_0[1|1] common_bottom top_c5 VSUBS cap_mim
Xcap_mim_0[2|1] common_bottom top_c4 VSUBS cap_mim
Xcap_mim_0[3|1] common_bottom m5_n4800_6800 VSUBS cap_mim
Xcap_mim_0[4|1] common_bottom top_c5 VSUBS cap_mim
Xcap_mim_0[5|1] common_bottom top_c5 VSUBS cap_mim
Xcap_mim_0[6|1] common_bottom top_c5 VSUBS cap_mim
Xcap_mim_0[7|1] common_bottom top_c3 VSUBS cap_mim
Xcap_mim_0[0|2] common_bottom top_c5 VSUBS cap_mim
Xcap_mim_0[1|2] common_bottom top_c3 VSUBS cap_mim
Xcap_mim_0[2|2] common_bottom top_c4 VSUBS cap_mim
Xcap_mim_0[3|2] common_bottom m5_n7400_6800 VSUBS cap_mim
Xcap_mim_0[4|2] common_bottom top_c5 VSUBS cap_mim
Xcap_mim_0[5|2] common_bottom top_c3 VSUBS cap_mim
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
C37 top_c4 VSUBS 38.041428f
C38 common_bottom VSUBS 0.118965p
C39 top_c_dummy VSUBS 3.679576f
C40 top_c0 VSUBS 4.36327f
C41 top_c1 VSUBS 6.20843f
C42 top_c2 VSUBS 12.04523f
C43 m5_n7400_6800 VSUBS 1.14708f
C44 top_c3 VSUBS 22.510658f
C45 m5_n4800_6800 VSUBS 1.305221f
.ends
