ishi-kai/Chipathon2023_ADC/(commit log)

2024-03-31 gitignore追加
2024-03-31 miyahara先生のPDFのp.76を参考にsch作成
    [comp_20240331.sch]
2024-03-31 シンボル生成+p.78っぽくテストベンチを作ろうとした(できなかったけど)
    [test_like_p78.sch]
2024-03-31 gds作成したけど怒られてる(discord参照)
2024-04-01 Add Noritsuna's MIM sample.
    Add Noritsuna's MIM sample.
    [test_cap_mim_2f0fF.sch]
2024-04-01 tbの名前修正
    [tb_check_pulse.sch, test_like_p78.sch]
2024-04-01 寄生抽出done
    [comp_20240331.sch]
2024-04-01 Macユーザ向けに.DS_STOREをignore
2024-04-01 自動で作られてるっぽいファイルをignore
2024-04-01 mainでgitignoreが追加されたので削除
2024-04-03 p.78ライクなtb追加
    [tb_like_p78.sch]
2024-04-03 Fix PEX.
    Fix PEX.
    [mim_cap_25ff.sch]
2024-04-03 シンボルのパスを相対パスに変更
    [tb_check_pulse.sch, tb_like_p78.sch]
2024-04-03 TOP_pex_extracted.spiceを追加
2024-04-03 TOP_pex_extracted.spiceは差分を取るように変更
2024-04-03 Fix LVS.
    Fix LVS.
    [cdac_lvs.sch, mim_cap_25ff.sch]
2024-04-04 Add PEX for MOM.
    Add PEX for MOM.
    [mom_unit.sch]
2024-04-05 Cell and Array Sample.
    Cell and Array Sample.
2024-04-05 make latch circuit
    [inv.sch, latch.sch, latch_rc.sch, latch_rc_test.sch, latch_test.sch, sw_test.sch]
2024-04-05 Challenge to make a comparator.
    Challenge to make a comparator.
    [comparator.sch, comparator_tb.sch]
2024-04-05 Add the CDAC file
    [mim_cap_array8x8_15step.sch, mim_cap_array_tb.sch]
2024-04-06 Update the CDAC design with latency measurement
    [mim_cap_array8x8_15step.sch, mim_cap_array_tb.sch]
2024-04-06 add files for SAR ADC sim.
    [SW_CDAC.sch, tran_sar_adc.sch, tran_sar_logic.sch, user_proj_sarlogic.sch]
2024-04-06 add synthesis files(openlane)
    [pin_order.cfg]
2024-04-07 Copy all each blocks in review dir.
    Copy all each blocks in review dir.
    [SW_CDAC.sch, comp_20240331.sch, inv.sch, latch.sch, latch_rc.sch, latch_rc_test.sch, latch_test.sch, mim_cap_array8x8_15step.sch]
2024-04-07 make layout for new switch
    [SW_CDAC.sch, tran_sar_adc.sch, tran_sar_logic.sch, user_proj_sarlogic.sch]
2024-04-07 remake latch
    [latch_new.sch, latch_test.sch]
2024-04-07 Add Mismatch and Montecarlo simulation examples.
    Add Mismatch and Montecarlo simulation examples.
    [bench_mc.sch, bench_mc_mm.sch, bench_mm.sch, comp_20240331.sch]
2024-04-08 森さんのを参考にp81ライクなテストベンチを作成．波形がおかしいので次回
    [tb_like_p81.sch]
2024-04-10 Add LDO circuit.
    Add LDO circuit.
    [bgr_diode.sch, bgr_diode_tb.sch, cs_vthref_3ho.sch, ldo.sch, ldo_tb.sch, opamp.sch, opamp_tb.sch]
2024-04-10 Update the Revision 0.001 layout
    [advanced_mimcap_array8x8_15step.sch, mim_cap_array8x8_15step.sch, mim_cap_array_tb.sch, test_cap_mim_2f0fF.sch]
2024-04-11 Add 1st Circuit Design.
    Add 1st Circuit Design.
    [bgr_diode_lvs.sch, bgr_diode_tb.sch, cs_vthref_3ho_lvs.sch, ldo_check_unit_tb.sch, ldo_lvs.sch, opamp_lvs.sch]
2024-04-11 new layout for SW
    [SW_CDAC_NEW.sch]
2024-04-11 modify layout
    [SW_CDAC_NEW.sch]
2024-04-11 Add current mirror for LDO.
    Add current mirror for LDO.
    [bgr_diode_orig.sch, ldo_currentmirror.sch, ldo_currentmirror_lvs.sch]
2024-04-12 new layout for latch
    [LATCH.sch, LATCH_RC_test.sch, LATCH_TEST.sch, SW_CDAC_TEST.sch, inv.sch, latch.sch, latch_new.sch, latch_rc.sch]
2024-04-12 Fix the LVS error, Magic DRC fix is still ongoing (8 error remaining)
    [advanced_mimcap_array8x8_15step.sch]
2024-04-13 作り直しました
    [bench_mm.sch, comp_20240331.sch, tb_like_p81.sch]
2024-04-13 add on-state sim
    [LATCH_RC_test.sch, SW_CDAC_TEST.sch]
2024-04-13 Update the PEX (RC), GDS, .sch of CDAC where the required DRCs and LVS are all passed
    [mim_cap_array_charge_test.sch, mim_cap_array_tb.sch, test_cap_mim_2f0fF.sch]
2024-04-13 Revmove old files from CDAC
    [mim_cap_array8x8_15step.sch]
2024-04-13 Remove old files from CDAC
    [mim_cap_array8x8_15step.sch]
2024-04-13 1st version LDO.
    1st version LDO.
    [bgr_diode.sch, bgr_diode_lvs.sch, bgr_diode_orig.sch, bgr_diode_tb.sch, cs_vthref.sch, cs_vthref_3ho.sch, cs_vthref_3ho_lvs.sch, cs_vthref_lvs.sch]
2024-04-14 Fix connection power to P tag.
    Fix connection power to P tag.
2024-04-14 folder name renamed
    [pin_order.cfg]
2024-04-14 re-upload "SAR_ADC"
    [pin_order.cfg, tran_sar_adc.sch, tran_sar_logic.sch, user_proj_sarlogic.sch]
2024-04-14 re-upload "SAR_Logic"
    [pin_order.cfg, tran_sar_adc.sch, tran_sar_logic.sch, user_proj_sarlogic.sch]
2024-04-14 integration SAR ADC on xschem
    [sar_adc_lvs.sch, tran_sar_adc.sch, tran_sar_logic.sch, user_proj_sarlogic.sch]
2024-04-15 add sim result
    [sar_adc_tran_out_typ_woLDO_eachBlockExtracted_20240415.csv]
2024-04-15 move files to new folder
    [sar_adc_lvs.sch, sar_adc_tran_out_typ_woLDO_eachBlockExtracted_20240415.csv, tran_sar_adc.sch, tran_sar_adc_allsch.sch]
2024-04-15 Result Checker.
    Result Checker.
    [vout_result.csv]
2024-04-15 add SAR ADC GDS(Caravel DRC trouble)
2024-04-15 add SAR ADC tran sim. result(cap_array is ideal)
    [cap_array_ideal.sch, sar_adc_tran_out_typ_woLDO_eachBlockExtracted_CArrayideal_20240416.csv, tran_sar_adc_CArrayideal.sch]
2024-04-16 Add vout_result_CArrayideal.csv.
    Add vout_result_CArrayideal.csv.
    [vout_result_CArrayideal.csv]
2024-04-16 DNWELLの使い方間違っていたので，DNWELL削除
    [comp_20240331.sch]
2024-04-16 Add pads.
    Add pads.
    [tran_sar_adc_pad.sch]
2024-04-16 Fix digital pad.
    Fix digital pad.
    [tran_sar_adc_pad.sch]
2024-04-16 Fix rst pad.
    Fix rst pad.
    [tran_sar_adc_pad.sch]
2024-04-16 Fix Analog pad.
    Fix Analog pad.
    [tran_sar_adc_pad.sch]
2024-04-17 絶対パスを相対パスに変更
    [tran_sar_adc_pad.sch]
2024-04-17 のりつなさんのxschemファイル追加
    [bgr_diode.sch, bgr_diode_lvs.sch, bgr_diode_tb.sch, cs_vthref.sch, cs_vthref_lvs.sch, ldo.sch, ldo_currentmirror.sch, ldo_currentmirror_lvs.sch]
2024-04-17 Confirm the Via-enhanced layout on xschem
    [advanced_mimcap_array8x8_15step.sch, test_cap_mim_2f0fF.sch]
2024-04-17 SAR ADC GDS(DRC, ANT are done. LVS is Incomplete)
2024-04-17 gds, sch for LVS
    [SAR_TOP_LVS.sch]
2024-04-18 Add LDO on ADC.
    Full DRC:OK
    Caravel DRC:OK
    Magic DRC:OK
2024-04-19 Add PEX file.
    Add PEX file.
    [ldo_pex_tb.sch]
2024-04-19 提出用ディレクトリをひとまず作成
    提出用ディレクトリをひとまず作成
    [LATCH.sch, SAR_TOP_LVS.sch, SW_CDAC.sch, SW_CDAC_NEW.sch, advanced_mimcap_array8x8_15step.sch, bgr_diode.sch, bgr_diode_lvs.sch, bgr_diode_tb.sch]
2024-04-19 Add no label LDO.
    Add no label LDO.
    [tran_sar_adc_pex.sch]
2024-04-19 add layout pin placement image
2024-04-19 パス修正
    [bgr_diode_lvs.sch]
2024-04-19 スクショ追加
2024-04-19 Add circuit figs.
    Add circuit figs.
2024-04-19 スクショ追加その２
2024-04-19 add SAR ADC waveform
