ishi-kai/Chipathon2023_ADC/(notices)

Notices in the files:
noritsuna/ldo/README.md:
License:
[License: Apache 2.0](https://opensource.org/licenses/Apache-2.0)
